avilleret/laser_drawer/schematic/README

ce dossier contient le projet Kicad laser_drawer.pro

Il s'agit de la version 2 du projet (version RGB et symétrisée)

Il a été crée avec la version 2013-03-31 BZR 4008-stable de Kicad (non compatible avec la version des dépôts du moment).

Exporter depuis Kicad vers Latex :
je n'utilise que le format PDF dans Latex.

Pour exporter en PDF depuis Eeschema (éditeur de schéma) :
Fichier -> Tracer
Puis sélectionner : 
Dimension page : taille schématique
Format : PDF
Épaisseur de ligne par défaut : 0.152
Mode : couleur
Tracer cartouche et encadrement (optionel)

Puis cliquer : tracer toutes les pages

Pour exporter depuis PcbNew (éditeur de circuit imprimé) vers Latex (on passe par le format intermédiaire SVG) :
Export du schéma avec l'empreinte des composants, les valeurs, les reférences, les jumpers...
Fichier -> Export SVG
Répertoire de sortie : svg/
Couche cuivre : aucune sinon c'est illisible à cause du plan de masse
Couches techniques : 
	Dessus.Silks -> pour avoir les formes des composants
	Eco2.User -> pour avoir la connexion des jumpers
Dimension plume par défaut : 0,00393701 inch
Mode d'impression : couleur
Format de la page SVG : Surface du circuit seulement
Cocher Imprimer les contours du CI
Option de fichier : Tout en un fichier

Puis convertir les fichiers avec Inkscape : 
laser_drawer--brd.svg :
	Convertir en PDF : Fichier -> Enregistrer sous -> ../pdf/laser_drawer--brd.pdf
Options d'export : 
	Version PDF : 1.4
	Convertir textes en chemins : NON
	PDF+Latex : NON
	Rastériser : NON
	Résolution pour la rastérisation : 90
	Exporter dessin : NON
	Exporter page : NON
	Limiter l'exportation à l'id : <VIDE>

Pour exporter le typon : 
Fichier -> Tracer
	Format : SVG
	Répertoire : svg/
	Couches : Dessous.Cu
	Imprimer cartouche : NON
	Tracer pads sur sérigraphie : NON
	Tracer valeur module : OUI
	Tracer référence module : OUI
	Tracer autre texte : OUI
	Tracer textes invisibles : NON
	Ne pas couvrir les via : NON
	Exclure les tracés contour PCB : NON
	Tracé mirroir : NON
	Tracé négatif : NON
	Marques de perçage : petit
	Épaisseur ligne par défaut : 0,006"

Puis ouvrir svg/laser_drawer-Dessous_Cu.svg avec Inkscape
Réduire la taille de la page au contenu : 
	Fichier -> Propriété du document
	Dans l'onglet Page -> Taille de la page
	Redimensionner la page au contenu -> Ajuster la page au dessin ou à la sélection
	Fermer la fenêtre de dialogue
Retourner l'image : 
	Sélectionner tout : CTRL + A
	Retourner horizontalement : H
Sauvegarder en PDF : 
	Fichier -> Sauvegarder sous : pdf/laser_drawer-Dessous_Cu.pdf
Option d'export PDF cf plus haut.
