avilleret/laser_drawer/doc/laser_drawer-en-web.pdf

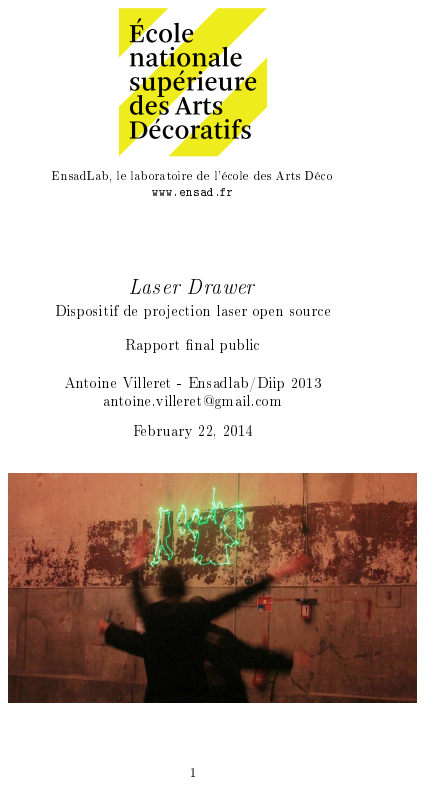
[picture p1: page 1]
❊♥s❛❞▲❛❜✱ ❧❡ ❧❛❜♦r❛t♦✐r❡ ❞❡ ❧✬é❝♦❧❡ ❞❡s ❆rts ❉é❝♦ ✇✇✇✳❡♥s❛❞✳❢r

## ❈♦♥t❡♥ts

✶ ❙t❛t❡ ♦❢ t❤❡ ❛rt ❛♥❞ t❡❝❤♥✐❝s | ✷
✶✳✶ P✐❡❝❡s ♦❢ ❛rt✐st✐❝ ✇♦r❦ ✳ ✳ ✳ ✳ ✳ ✳ ✳ ✳ ✳ ✳ ✳ ✳ ✳ ✳ ✳ ✳ ✳ ✳ ✳ ✳ | ✸
✶✳✶✳✶ | ❏❡❛♥✲▼✐❝❤❡❧ ❏❛rr❡ ✕ ▲❛s❡r ❤❛r♣ ✕ ✶✾✽✵✬s ✳ ✳ ✳ ✳ ✳ ✳ | ✸
✶✳✶✳✷ | ❆❧✈❛r♦ ❈❛ss✐♥❡❧❧✐ ✕ ❙❝♦r❡ ▲✐❣❤t ✕ ✷✵✵✽ ✳ ✳ ✳ ✳ ✳ ✳ ✳ | ✸
✶✳✶✳✸ | ❘♦❜✐♥ ❋♦① ✕ ▲❛s❡r ❙❤♦✇ ✳ ✳ ✳ ✳ ✳ ✳ ✳ ✳ ✳ ✳ ✳ ✳ ✳ ✳ ✳ | ✸
✶✳✶✳✹ | ❯❱❆ ✕ ❙♣❡❡❞ ♦❢ ❧✐❣❤t ✕ ✷✵✶✵ ✳ ✳ ✳ ✳ ✳ ✳ ✳ ✳ ✳ ✳ ✳ ✳ ✳ | ✹
✶✳✶✳✺ | ❘♦❜❡rt ❍❡♥❦❡ ✕ ❋r❛❣✐❧❡s ❚❡rr✐t♦✐r❡s ✕ ✷✵✶✷ ✳ ✳ ✳ ✳ | ✹
✶✳✶✳✻ | ❙❛♠✉❡❧ ❇✐❛♥❝❤✐♥✐ ✕ ❙✐❣♥ ✕ ✷✵✶✷ ✳ ✳ ✳ ✳ ✳ ✳ ✳ ✳ ✳ ✳ ✳ | ✺
✶✳✶✳✼ | ❍②✉♥❞❛✐ ❛♥❞ ❲❤✐t❡❱♦✐❞ ✕ ❋❧✉✐❞✐❝ ✲ ❙❝✉❧♣t✉r❡ ✐♥
| ♠♦t✐♦♥ ✕ ✷✵✶✸ ✳ ✳ ✳ ✳ ✳ ✳ ✳ ✳ ✳ ✳ ✳ ✳ ✳ ✳ ✳ ✳ ✳ ✳ ✳ ✳ | ✺
✶✳✶✳✽ | ❉❛✐t♦ ▼❛♥❛❜❡ ✕ ❯❱ ❧❛s❡r ❢❛❞❡ ♦✉t ✕ ✷✵✶✵ ✳ ✳ ✳ ✳ ✳ | ✺
✶✳✶✳✾ | ❆♥t♦✐♥❡ ❱✐❧❧❡r❡t ✕ ❙✐❧❤♦✉❡tt❡ ✕ ✷✵✶✸ ✳ ✳ ✳ ✳ ✳ ✳ ✳ ✳ | ✺
✶✳✶✳✶✵ ▼❛rs❤♠❛❧❧♦✇ ▲❛s❡r ❋❡❛st ✕ ▲❛s❡r ❋♦r❡st ✕ ✷✵✶✸ ✳ ✳ | ✺
✶✳✶✳✶✶ ❆ ❜✐t ♦❢ ❤✐st♦r② ✳ ✳ ✳ ✳ ✳ ✳ ✳ ✳ ✳ ✳ ✳ ✳ ✳ ✳ ✳ ✳ ✳ ✳ ✳ ✳ ✶✵ ✶✳✶✳✶✷ ▲❛s❡r ♣r♦❥❡❝t♦rs ✳ ✳ ✳ ✳ ✳ ✳ ✳ ✳ ✳ ✳ ✳ ✳ ✳ ✳ ✳ ✳ ✳ ✳ ✳ ✶✵ ✶✳✶✳✶✸ ■▲❉❆ ✐♥t❡r❢❛❝❡s ✳ ✳ ✳ ✳ ✳ ✳ ✳ ✳ ✳ ✳ ✳ ✳ ✳ ✳ ✳ ✳ ✳ ✳ ✳ ✳ ✶✵
✷ ❚❤❡ ▲❛s❡r ❉r❛✇❡r ♣r♦❥❡❝t | ✶✷
✷✳✶ ❙♣❡❝✐✜❝❛t✐♦♥s ✳ ✳ ✳ ✳ ✳ ✳ ✳ ✳ ✳ ✳ ✳ ✳ ✳ ✳ ✳ ✳ ✳ ✳ ✳ ✳ ✳ ✳ ✳ ✳ ✳ ✶✷ ✷✳✷ ❙♦❢t✇❛r❡ ❛♥❞ ❤❛r❞✇❛r❡ ❞❡s✐❣♥ ✳ ✳ ✳ ✳ ✳ ✳ ✳ ✳ ✳ ✳ ✳ ✳ ✳ ✳ ✳ ✳ ✶✷
✷✳✷✳✶ | ❍❛r❞✇❛r❡ ✳ ✳ ✳ ✳ ✳ ✳ ✳ ✳ ✳ ✳ ✳ ✳ ✳ ✳ ✳ ✳ ✳ ✳ ✳ ✳ ✳ ✳ ✳ ✶✷
✷✳✷✳✷ | ❙♦❢t✇❛r❡ ✳ ✳ ✳ ✳ ✳ ✳ ✳ ✳ ✳ ✳ ✳ ✳ ✳ ✳ ✳ ✳ ✳ ✳ ✳ ✳ ✳ ✳ ✳ ✳ ✶✸
✷✳✸ ▲❛s❡r ❉r❛✇❡r ✈s✳ ●❛❧❛①② ▲❛s❡r ❙❤♦✇ ✳ ✳ ✳ ✳ ✳ ✳ ✳ ✳ ✳ ✳ ✳ ✳ ✶✺
❆ ❊❧❡❝tr♦♥✐❝ ❙❝❤❡♠❛t✐❝s | ✶✾
❇ ▲❡❣❛❧ ❛♥❞ s❡❝✉r✐t② ✐ss✉❡s ✇✐t❤ t❤❡ ❧❛s❡rs | ✷✹
❈ ■♠❛❣❡ ❝r❡❞✐t | ✷✻

▲❛s❡r ❉r❛✇❡r ✐s ❛♥ ♦♣❡♥ s♦✉r❝❡ ❧❛s❡r ♣r♦❥❡❝t✐♦♥ ❛♣♣❛r❛t✉s✳ ❆❢t❡r ❛ st❛t❡ ♦❢ t❤❡ ❛rt ❛♥❞ t❡❝❤♥✐❝s ❛r♦✉♥❞ ❛♥✐♠❛t✐♦♥ ❧❛s❡r✱ t❤✐s ❛rt✐❝❧❡ ✐♥tr♦✲ ❞✉❝❡ t❤❡ ❞❡✈✐❝❡ ❛♥❞ ❤♦✇ ✐t ✐s ♠❛❞❡✳ ❚✇♦ ❛♣♣❡♥❞✐❝❡s ♣r❡s❡♥ts ❡❧❡❝tr♦♥✐❝ s❝❤❡♠❛t✐❝s ❛♥❞ s❡❝✉r✐t② ✐ss✉❡s✳

## ✶ ❙t❛t❡ ♦❢ t❤❡ ❛rt ❛♥❞ t❡❝❤♥✐❝s

■♥st❡❛❞ ♦❢ ♠❛❦✐♥❣ ❛♥ ❡①❤❛✉t✐✈❡ st❛t❡ ♦❢ t❤❡ ❛rt ❛♥❞ t❡❝❤♥✐❝s✱ ■ ❝❤♦♦s❡ ❢❡✇ ♣✐❡❝❡s ♦❢ ❛rt✐st✐❝ ✇♦r❦s ✐♥✈♦❧✈✐♥❣ ❧❛s❡r ❛♥❞ s♦♠❡ s♦❧✉t✐♦♥s t♦ ❞r✐✈❡ t❤❡♠ ✇✐t❤ ❛ ❝♦♠♣✉t❡r✳

✷

✶✳✶ | P✐❡❝❡s ♦❢ ❛rt✐st✐❝ ✇♦r❦
✶✳✶✳✶ | ❇❡r♥❛r❞ ❙③❛❥♥❡r ✕ ❙②♥r✐♥❣✉❡ ✭❤❛r♣❡ ❧❛s❡r✮ ✕ ✶✾✽✵

■♥ t❤❡ ✶✾✽✵✬s✱ ❇❡r♥❛r❞ ❙③❛❥♥❡r✶ ❞❡s✐❣♥❡❞ ❛ ♠✉s✐❝❛❧ ✐♥str✉♠❡♥t ❜❛s❡❞ ♦♥ ❛ ❧❛s❡r ❜❡❛♠ ✿ ❙②r✐♥❣✉❡✱ t❤❡ ❧❛s❡r ❤❛r♣✳ ■t ✐s ♦❢t❡♥ ❛ttr✐❜✉t❡❞ t♦ ❏❡❛♥✲ ▼✐❝❤❡❧ ❏❛rr❡ ✇❤✐❝❤ ✉s❡s ❛ ❧❛s❡r ❤❛r♣ s✐♥❝❡ ♠❛♥② ②❡❛rs ✇✐t❤♦✉t ❝r❡❞✐t t♦ ❇❡r♥❛r❞ ❙③❛❥♥❡r✳ ■t✬s ♣r❡tt② s✐♠♣❧❡ ✿ t❤❡ ❝✉t ♦❢ ❛ ❧❛s❡r ❜❡❛♠ tr✐❣❣❡rs ❛ s②♥t❤❡s✐③❡r✳
❆❝❝♦r❞✐♥❣ t♦ ❏❛rr❡✱ ❧❛s❡r ❡♥❛❜❧❡s ✧t♦ s❤❛r❡ ✇✐t❤ t❤❡ ❛✉❞✐❡♥❝❡✱ ✇❤✐❝❤ ✐s ❢❛r ❛✇❛② ✐♥ t❤❡ ✈❡♥✉❡✱ ❬✳ ✳ ✳ ❪ t❤❡ ♠✉s✐❝ ✐♥ ❛ ✈✐s✐❜❧❡ ❛♥❞ s❡♥s✐❜❧❡ ✇❛②✧✳ ◆❡✈❡rt❤❡❧❡ss✱ t❤✐s ❞✐s♣♦s❛❧ ❤❛s ❛ ❧✐♠✐t❡❞ ❡①♣r❡ss✐✈✐t②✳ ❚❤❡r❡ ✐s ♥❡✐t❤❡r ✈❡❧♦❝✐t② ♥♦r ❛❢t❡rt♦✉❝❤✳

✶✳✶✳✷ ❆❧✈❛r♦ ❈❛ss✐♥❡❧❧✐ ✕ ❙❝♦r❡ ▲✐❣❤t ✕ ✷✵✵✽

❙❝♦r❡ ▲✐❣❤t ✐s ❛♥ ❆❧✈❛r♦ ❈❛ss✐♥❡❧❧✐✬s ♣r♦❥❡❝t ✇❤❡r❡ ❛ s♠❛❧❧ ❧❛s❡r ❜❡❛♠ ❢♦❧❧♦✇s s❤❛♣❡s ❞r❛✇♥ ✐♥ r❡❛❧ t✐♠❡ ♦r ♠♦✈❡❞ ♦♥ ❛ ❞❡s❦ ✭❝❢✳ ✶✮✳ ❚❤✐s ✐♥st❛❧❧❛t✐♦♥ ✉s❡s ❛ s♠❛❧❧ ❧❛s❡r ❛ss♦❝✐❛t❡❞ ✇✐t❤ ❛ ✈✐❞❡♦ ❝❛♠❡r❛ t♦ ❞❡t❡❝t ❝♦♥t♦✉rs✳ ❆❧✈❛r❛ ❈❛ss✐♥❡❧❧✐ ✐s ❝✉rr❡♥t❧② ✇♦r❦✐♥❣ ♦♥ ▲❛s❡r ●❛♠❡ ♣r♦❥❡❝t ✿ t❤❡ ❧❛s❡r ❜❡❛♠ ✐s ♣r♦❥❡❝t❡❞ ♦♥ ❛ ❚✲s❤✐rt ❛♥❞ ❜♦✉♥❝❡ ♦♥ s♠❛❧❧ ♣r✐♥t❡❞ ❞♦ts ❧✐❦❡ ❛ ✢✐♣♣❡r ❜❛❧❧✳ ❚❤❡ ❣❛♠❡r s❤♦✉❧❞ ♠♦✈❡ ❤✐♠s❡❧❢ t♦ s❛✈❡ t❤❡ ❜❛❧❧ ❢r♦♠ ❢❛❧❧✐♥❣ ❞♦✇♥✳

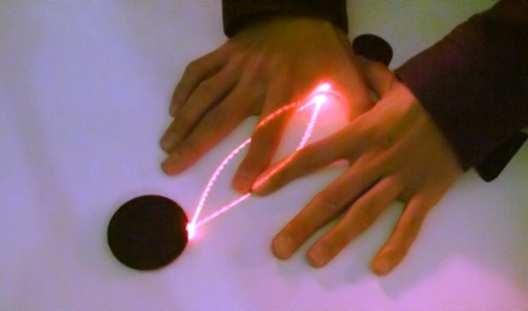
[picture p2: figure]

❋✐❣✉r❡ ✶✿ ❆❧✈❛r♦ ❈❛ss✐♥❡❧❧✐ ✕ ❙❝♦r❡ ▲✐❣❤t

✶❤tt♣✿✴✴s③❛❥♥❡r✳♥❡t✴s②r✐♥❣❡✲❧❛s❡r✲❤❛r♣✴ (http://szajner.net/syringe-laser-harp/)

✸

✶✳✶✳✸ ❘♦❜✐♥ ❋♦① ✕ ▲❛s❡r ❙❤♦✇

❘♦❜✐♥ ❋♦① ✉s❡s ❧❛s❡r ❧✐❦❡ ❛♥ ♦s❝✐❧❧♦s❝♦♣❡✳ ❍❡ ❢❡❡❞s t❤❡ ❧❛s❡r ✇✐t❤ t❤❡ s❛♠❡ s✐❣♥❛❧ ❤❡ s❡♥❞s t♦ ❧♦✉❞s♣❡❛❦❡rs✳ ❚❤✐s ✐s ❣❡♥❡r❛t❡❞ ❜② ❛ ▼❛①✴▼❙P ♣❛t❝❤ ✐♥ r❡❛❧✲t✐♠❡✳ ❚❤❛♥❦s t♦ t❤❡ s♠♦❦❡✱ t❤❡ ❜❡❛♠ ✐s ✈✐s✐❜❧❡ ✐♥ t❤❡ s♣❛❝❡ ❛♥❞ ✈♦❧✉♠❡s ❛♣♣❡❛rs ✭❝❢✳ ✷✮✳ ❚❤❡ ❜❡❛♠ s❝❛♥s t❤❡ ❛✉❞✐❡♥❝❡✱ t❤✐s ✐s ❞❛♥❣❡r♦✉s ❡✈❡♥ ✐❢ t❤❡ s♠♦❦❡ ❛tt❡♥✉❛t❡s t❤❡ ❜❡❛♠✳ ❚❤❡ s❤♦✇ ✐s ✐♠♣r❡ss✐✈❡ ❜✉t t❤❡ s②st❡♠❛t✐❝ ❝♦rr❡❧❛t✐♦♥ ❜❡t✇❡❡♥ s♦✉♥❞ ❛♥❞ ✈✐s✉❛❧ ♠❛❦❡s ✐t ❜♦r✐♥❣ q✉✐❝❦❧②✳ ❘♦❜✐♥ ❋♦① ✉s❡s ❛ ▼❖❚❯ ❚r❛✈❡❧❧❡r s♦✉♥❞ ❝❛r❞ ❛♥❞ ❛ ❤✐s ♦✇♥ ❡❧❡❝tr♦♥✐❝s t♦ ❞r✐✈❡ ❤✐s ✸✺✵ mW ❧❛s❡r✳

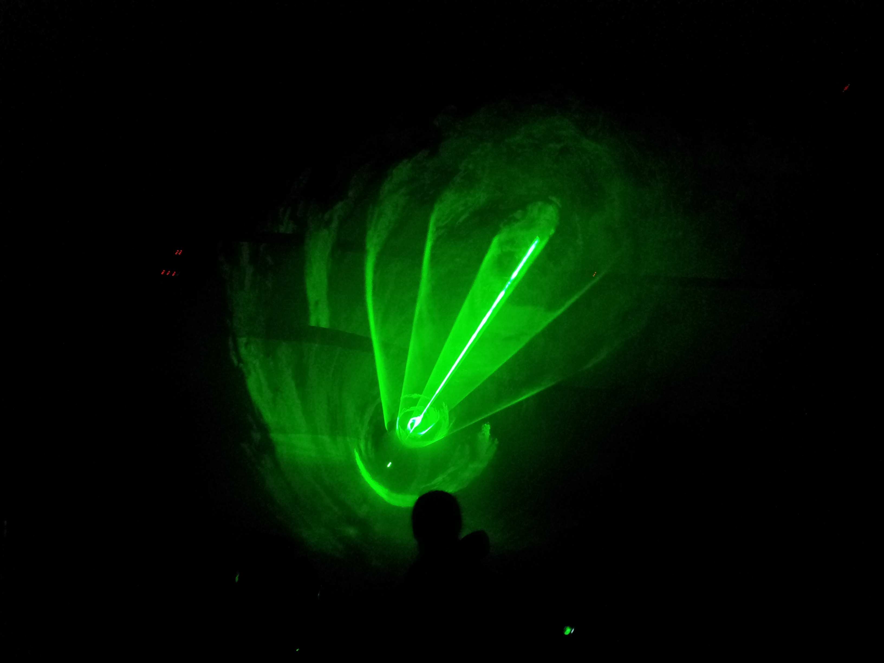
[picture p3: figure]

❋✐❣✉r❡ ✷✿ ❘♦❜✐♥ ❋♦① ✕ ▲❛s❡r ❙❤♦✇

✶✳✶✳✹ ❯❱❆ ✕ ❙♣❡❡❞ ♦❢ ❧✐❣❤t ✕ ✷✵✶✵

❙♣❡❡❞ ♦❢ ❧✐❣❤t ✐s ❛ ❧❛❜②r✐♥t❤✐❝ s❡t ♦❢ ❧❛s❡r ✐♥st❛❧❧❛t✐♦♥s✳ ❙❡✈❡r❛❧ ✐♥st❛❧✲ ❧❛t✐♦♥s s❤♦✇ ✈♦❧✉♠✐❝ ✜❣✉r❡s ❞r❛✇♥ ✇✐t❤ ❢❡✇ ❧❛s❡rs ❞❡✢❡❝t❡❞ t❤❛♥❦s t♦ ✜①❡❞ ♠✐rr♦rs✳ ❆♥♦t❤❡r ✐♥st❛❧❧❛t✐♦♥ ❞r❛✇s ❛♥ ✐♥t❡r❛❝t✐✈❡ t❡①t❡ ♦♥ ❛ ✇❛❧❧✳ ■♥ ❛ ✈✐❞❡♦✱ ✇❡ s❤♦✇ t❤❡ t❡❛♠ ✇♦r❦✐♥❣ ✇✐t❤ ▼❛①✴▼❙P✱ t❤❡② ♣r♦❜❛❜❧② ✉s❡ t❤✐s s♦❢t✇❛r❡ t♦ ❞r✐✈❡ ❧❛s❡rs✱ ❜✉t ■ ❤❛✈❡ ♥♦ ♣r♦♦❢✳

✶✳✶✳✺ ❘♦❜❡rt ❍❡♥❦❡ ✕ ❋r❛❣✐❧❡s ❚❡rr✐t♦✐r❡s ✕ ✷✵✶✷

❋r❛❣✐❧❡s ❚❡rr✐t♦✐r❡s ✐s ❛♥ ✐♥t❡r❛❝t✐✈❡ ❛♥❞ ❣❡♥❡r❛t✐✈❡ ✐♥st❛❧❧❛t✐♦♥ ❜② ❘♦❜❡rt ❍❡♥❦❡✳ ■t s❤♦✇s ❛♥ ❛♥✐♠❛t❡❞ ♥❡t✇♦r❦✳ ❚❤❡ ❛✉❞✐❡♥❝❡ ✐♥✢✉❡♥❝❡s t❤❡ ❛✉✲ ❞✐♦ ❛♥❞ ✈✐s✉❛❧ ♣❛tt❡r♥ ❣❡♥❡r❛t✐♦♥✳ ❚❤✐s ✐♥st❛❧❧❛t✐♦♥ ❤❛✈❡ ❜❡❡♥ s❤♦✇♥

| ✹

✐♥ ❊s♣❛❝❡ ▲❯ ✐♥ ◆❛♥t❡s ✭❋❘✮✳ ❘♦❜❡rt ❍❡♥❦❡ ✉s❡s ❛ ▼❖❚❯ ❚r❛✈❡❧❧❡r s♦✉♥❞ ❝❛r❞ t♦ ❞r✐✈❡ ❢♦✉r ②❡❧❧♦✇✲❜❧✉❡ ✺W ❧❛s❡rs✳ ❉✉❡ t♦ t❤❡ ❤❛③❛r❞ ♦❢ t❤♦s❡ ♣♦✇❡r❢✉❧ ❧❛s❡rs ❛♥❞ t❤❡ ✐♥❞♦♦r ✉s❡✱ ❤❡ ❞❡♣❧♦②s s♦♠❡ s♣❡❝✐❛❧ s❡❝✉r✐t② ♠❡❛s✉r❡s ✭♣❧❡❛s❡ r❡❢❡r t♦ ❆♣♣❡♥❞✐① ❇ t♦ ❧❡❛r♥ ♠♦r❡✮✳

✶✳✶✳✻ ❙❛♠✉❡❧ ❇✐❛♥❝❤✐♥✐ ✕ ❙✐❣♥ ✕ ✷✵✶✷

❙✐❣♥ ✐s ❛ ❣❡♥❡r❛t✐✈❡ ✐♥st❛❧❧❛t✐♦♥✳ ❲♦r❞s t❛❦❡♥ ❢r♦♠ t❤❡ s❝✐❡♥t✐✜❝ ✈♦❝❛❜✲ ✉❧❛r② ❛♥❞ ❢r♦♠ t❤❡ ✉♥✐✈❡rs✐t② ✇❡❜s✐t❡ ❛r❡ ✇r✐tt❡♥ ✇✐t❤ ❛ ❣r❡❡♥ ❧❛s❡r ♦♥ t❤❡ ❢r♦♥t ♦❢ ❛ ❜✉✐❧❞✐♥❣✳ ❚❤❡ ✇♦r❞s ❛r❡ ❞r❛✇♥ ✇✐t❤ ❛ ❤❛♥❞✇r✐tt❡♥ ❝❛❧✲ ❧✐❣r❛♣❤② ✇✐t❤ ❤❡s✐t❛t✐♦♥s ❛♥❞ ❝r♦ss✐♥❣ ♦✉t ❛s ✐❢ s♦♠❡♦♥❡ ✇❡r❡ ❝✉rr❡♥t❧② ✇r✐t✐♥❣ ♦♥ ❛ ♣❡♥ t❛❜❧❡t✳ ❚❤✐s ✐♥st❛❧❧❛t✐♦♥ ✉s❡s ❛ ✶✵W ❣r❡❡♥ ❧❛s❡r ❞r✐✈❡♥ ❜② ❛ ●❛❧❛①② ❙❤♦✇ ✐♥t❡r❢❛❝❡✳ ❆ s♦❢t✇❛r❡ ❤❛✈❡ ❜❡❡♥ ❞❡✈❡❧♦♣❡❞ t♦ ✉s❡ t❤✐s ✐♥t❡r❢❛❝❡ ✇✐t❤ P✉r❡❞❛t❛ ✉♥❞❡r ▲✐♥✉① ✭❝❢✳ ✶✳✶✳✶✸ ❛♥❞ ✜❣✉r❡ ✺✮✳

✶✳✶✳✼ ❍②✉♥❞❛✐ ❛♥❞ ❲❤✐t❡❱♦✐❞ ✕ ❋❧✉✐❞✐❝ ✲ ❙❝✉❧♣t✉r❡ ✐♥ ♠♦t✐♦♥ ✕ ✷✵✶✸

❋♦r t❤❡ ▼✐❧❛♥✬s ❞❡s✐❣♥❡r ✇❡❡❦ ✷✵✶✸✱ ❍✉②♥❞❛✐ ✐♥tr♦❞✉❝❡s ❋✉✐❧❞✐❝ ✲ ❙❝✉❧♣✲ t✉r❡ ✐♥ ♠♦t✐♦♥✱ ❛♥ ✐♥t❡r❛❝t✐✈❡ ✐♥st❛❧❧❛t✐♦♥ ♠❛❞❡ ❜② ❲❤✐t❡✈♦✐❞ t❡❛♠✳ ■t ✉s❡s ❛ ✸✲❞✐♠❡♥s✐♦♥❛❧ ♠♦t✐♦♥ ❝❛♣t✉r❡ ❞✐s♣♦s❛❧ t♦ tr❛❝❦ ♣❡♦♣❧❡ ❣❡st✉r❡ ❛♥❞ t♦ ❛♥✐♠❛t❡ ❧❛s❡r ♣❛tt❡r♥ ♣r♦❥❡❝t❡❞ ♦♥ ❛ ❝❧♦✉❞ ♦❢ t❤♦✉s❛♥❞ ♦❢ ♣✐♥❣✲♣♦♥❣ ❧✐❦❡ ❜❛❧❧s ✭❝❢✳ ✜❣✉r❡ ✻✮✳

✶✳✶✳✽ ❉❛✐t♦ ▼❛♥❛❜❡ ✕ ❯❱ ❧❛s❡r ❢❛❞❡ ♦✉t ✕ ✷✵✶✵

❉❛✐t♦ ▼❛♥❛❜❡ ✉s❡s ❧❛s❡r ✐♥ s❡✈❡r❛❧ ♦❢ ❤✐s ✇♦r❦s✳ ❯❱ ❧❛s❡r ❢❛❞❡ ♦✉t ✐♥✈♦❧✈❡s ❛ ❯❱ ❧❛s❡r t♦ ❞r❛✇ ♦♥ ❛ ♣❤♦s♣❤♦r❡s❝❡♥t ❜♦❛r❞✳ ❚❤❡ ❧❛s❡r ❝❤❛r❣❡s s✉❝❝❡ss✐✈❡❧② s♠❛❧❧ ♣♦✐♥ts✱ t❤❡ ❞✐s❝❤❛r❣❡ ♠❛❦❡s ❞✐✛❡r❡♥t ❧✉♠✐♥♦s✐t② ❧❡✈❡❧s ❛♥❞ ❛ ♣✐❝t✉r❡ ❛♣♣❡❛rs ✭❝❢✳ ✜❣✉r❡ ✼✮✳
❲✐t❤ P✉❧s❡✱ ❉❛✐t♦ ▼❛♥❛❜❡ ✉s❡s ❧❛s❡r ♠♦✉♥t❡❞ ♦♥ r♦❜♦t ❛♥❞ ♠✐rr♦rs ♣❧❛❝❡❞ ✐♥ ❛ ❧❛r❣❡ s♣❛❝❡ t♦ ❞❡✢❡❝t ❜❡❛♠s✳

✶✳✶✳✾ ❆♥t♦✐♥❡ ❱✐❧❧❡r❡t ✕ ❙✐❧❤♦✉❡tt❡ ✕ ✷✵✶✸

❙✐❧❤♦✉❡tt❡ ✐s ❛♥ ✐♥t❡r❛❝t✐✈❡ ✐♥st❛❧❧❛t✐♦♥ ✐♥ ✇❤✐❝❤ ❛ ❧❛s❡r ♣r♦❥❡❝t♦r ❞r❛✇s ❛♥✐♠❛t❡❞ s✐❧❤♦✉❡tt❡s✳ ■t ✇❛s ✜rst s❤♦✇❡❞ ❞✉r✐♥❣ t❤❡ ♦♣❡♥ ❞❛②s ♦❢ t❤❡ ❊◆❙❆❉ ✐♥ ❏❛♥✉❛r② ✷✺t❤ ❛♥❞ ✷✻t❤✱ ✷✵✶✸✳
❚❤❡ ✈✐s✐t♦rs ❡♥t❡r❡❞ t❤❡ ❜✉✐❧❞✐♥❣ t❤r♦✉❣❤ ❛ s✐♥♦✉s ❛♥❞ ♥❛rr♦✇ ❝♦rr✐✲ ❞♦r✳ ❆t ✐ts ❡♥❞✱ t❤❡② s❛✇ ❛ ❣r❡❡♥ s❤❛♣❡ ❛♥❞ r❡❛❧✐③❡❞ ❜② ❣❡tt✐♥❣ ❝❧♦s❡r t❤❛t ✐t ✇❛s t❤❡✐r ❝♦♥t♦✉r ♣r♦❥❡❝t❡❞ ♦♥ ❛ ♣❛♣❡r s❝r❡❡♥ ❜② ❛ ❧❛s❡r ✭❝❢✳ ✽✮✳ ❚❤✐s ❞✐s♣♦s❛❧ ✉s❡s ❛ ❞❡♣t❤ s❡♥s♦r ✭❑✐♥❡❝t✮ t❤❛t ❡❛s✐❧② ❡①tr❛❝ts t❤❡ ✈✐s✐t♦r✬s s✐❧❤♦✉❡tt❡s✳ ❚❤♦s❡ s✐❧❤♦✉❡tt❡s ❛r❡ t❤❡♥ ✈❡❝t♦r✐s❡❞ ❛♥❞ s❡♥t t♦ t❤❡ ❧❛s❡r t❤❛♥❦s t♦ t❤❡ ❝✉st♦♠ ✐♥t❡r❢❛❝❡ ❞❡❝r✐❜❡❞ ✐♥ t❤❡ r❡♣♦rt✳ ❚❤❡ ✇❤♦❧❡ ✈✐❞❡♦ ♣r♦❝❡ss✐♥❣ ✐s ❛❝❤✐❡✈❡❞ ✇✐t❤ ♣✉r❡❞❛t❛ t❤❛♥❦s t♦ ❝✉st♦♠ ❡①t❡r♥❛❧s✳

✺

✶✳✶✳✶✵ ▼❛rs❤♠❛❧❧♦✇ ▲❛s❡r ❋❡❛st ✕ ▲❛s❡r ❋♦r❡st ✕ ✷✵✶✸

▲❛s❡r ❋♦r❡st ✐♥✈♦❧✈❡s ✶✺✵ ❧❛s❡rs ♣❧❛❝❡s ♦♥ t♦♣ ♦❢ ✈❡rt✐❝❛❧ ✸ m t❛❧❧ ♠❡t❛❧ t✉❜❡s t❤✉s ❝r❡❛t✐♥❣ ❛ ✧❢♦r❡st✧✳ ❚❤❡ ♥❛t✉r❛❧ s♣r✐♥❣♥❡ss ♦❢ t✉❜❡ ♠❛❦❡s ✐t ♦s❝✐❧❧❛t✐♥❣ ✇❤❡♥ s♦♠❡❜♦❞② t♦✉❝❤❡s ✐t ❛♥❞ t❤❡♥ t❤❡ ❧❛s❡r ❞r❛✇s ✜❣✉r❡s ♦♥ t❤❡ ❝❡✐❧✐♥❣ ✭❝❢✳ ✾✮✳ ❆ t♦♥❡ ✐s ❛ss♦❝✐❛t❡❞ ✇✐t❤ ❡❛❝❤ tr❡❡✱ ✈✐s✐t♦rs ❝❛♥ ♣❧❛② s♦✉♥❞ ❛♥❞ ❧✐❣❤t ❥✉st ❜② t♦✉❝❤✐♥❣ t❤❡ tr❡❡✳

✻

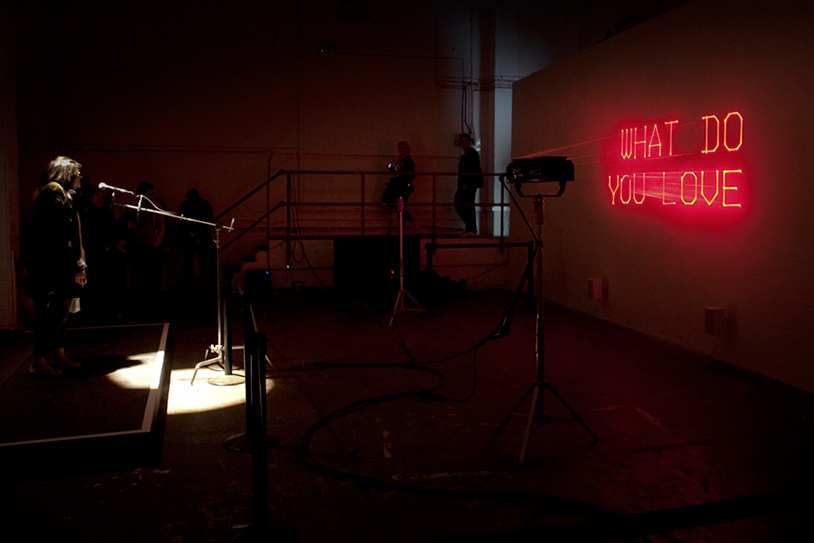
[picture p4: figure]
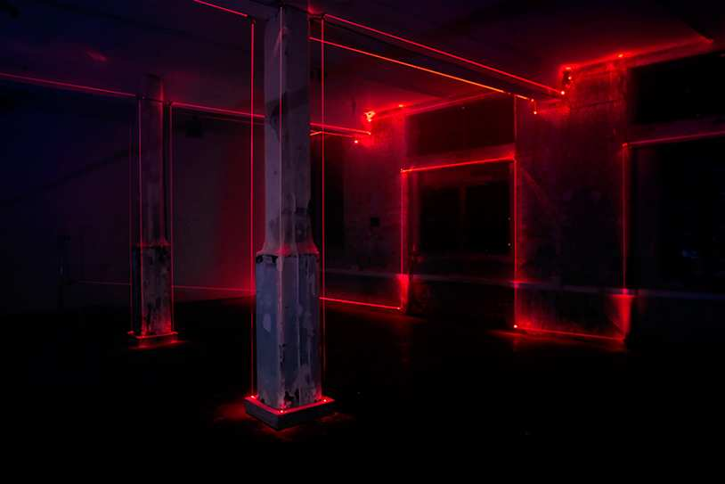
[picture p5: figure]

❋✐❣✉r❡ ✸✿ ❯❱❆ ✕ ❙♣❡❡❞ ♦❢ ❧✐❣❤t

✼

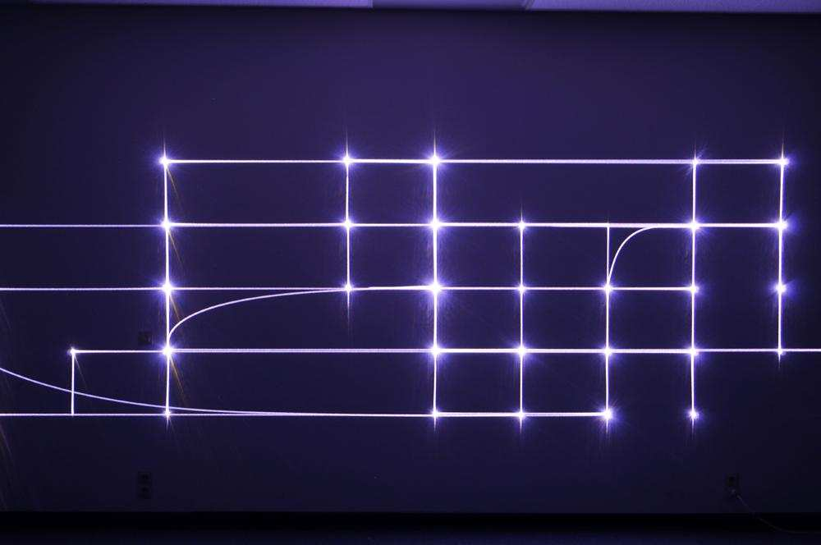
[picture p6: figure]

❋✐❣✉r❡ ✹✿ ❘♦❜❡rt ❍❡♥❦❡ ✕ ❋r❛❣✐❧❡s ❚❡rr✐t♦✐r❡s

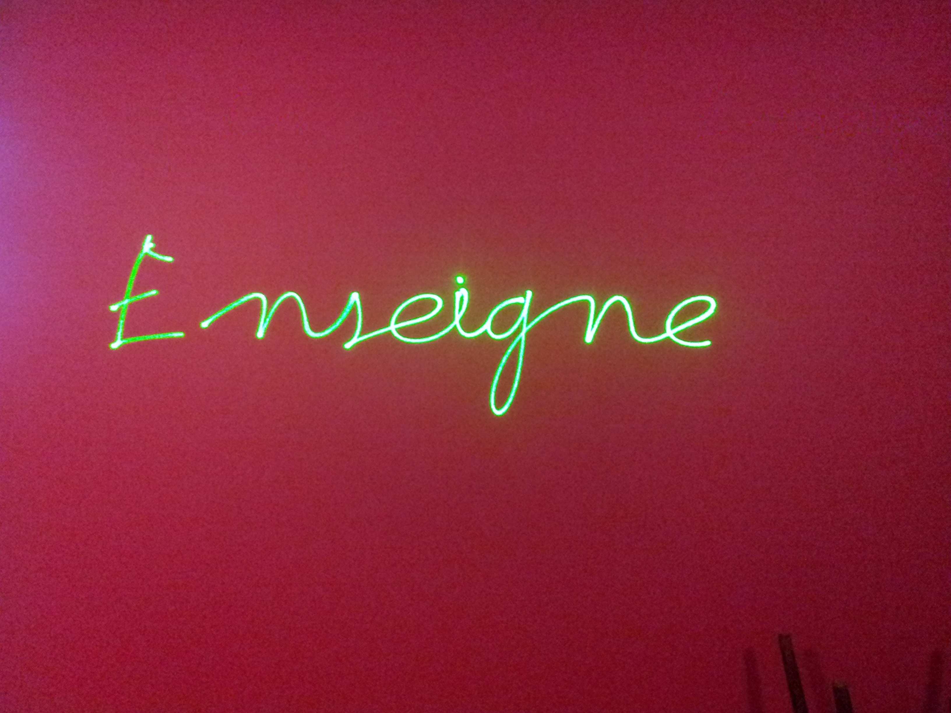
[picture p7: figure]

❋✐❣✉r❡ ✺✿ ❙❛♠✉❡❧ ❇✐❛♥❝❤✐♥✐ ✕ ❙✐❣♥

✽

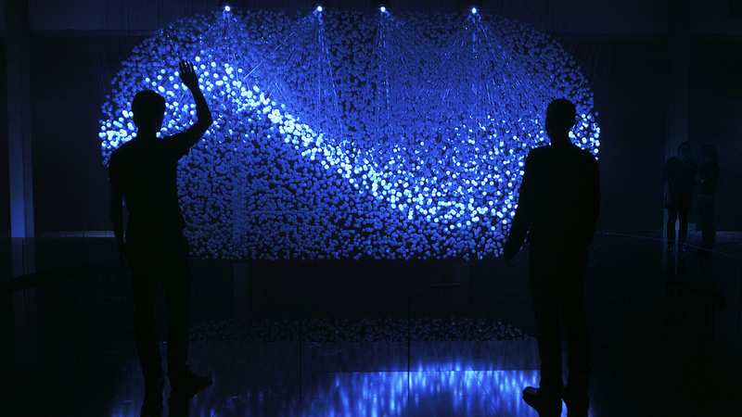
[picture p8: figure]

❋✐❣✉r❡ ✻✿ ❍②✉♥❞❛✐ ❛♥❞ ❲❤✐t❡❱♦✐❞ ✕ ❋❧✉✐❞✐❝ ✲ ❙❝✉❧♣t✉r❡ ✐♥ ♠♦t✐♦♥

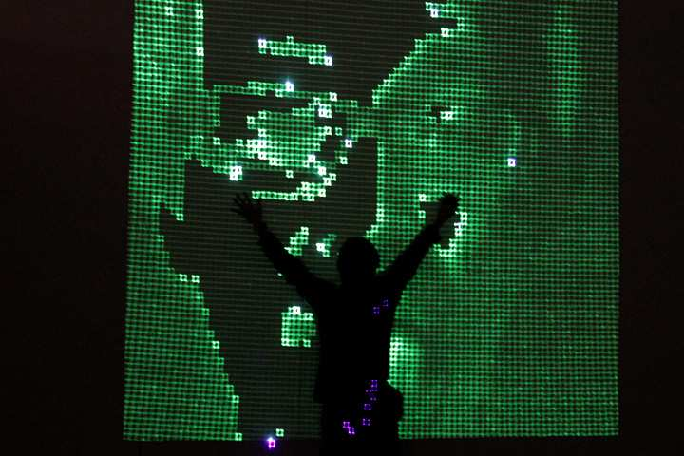
[picture p9: figure]

❋✐❣✉r❡ ✼✿ ❉❛✐t♦ ▼❛♥❛❜❡ ✕ ❯❱ ❧❛s❡r ❢❛❞❡ ♦✉t

✾

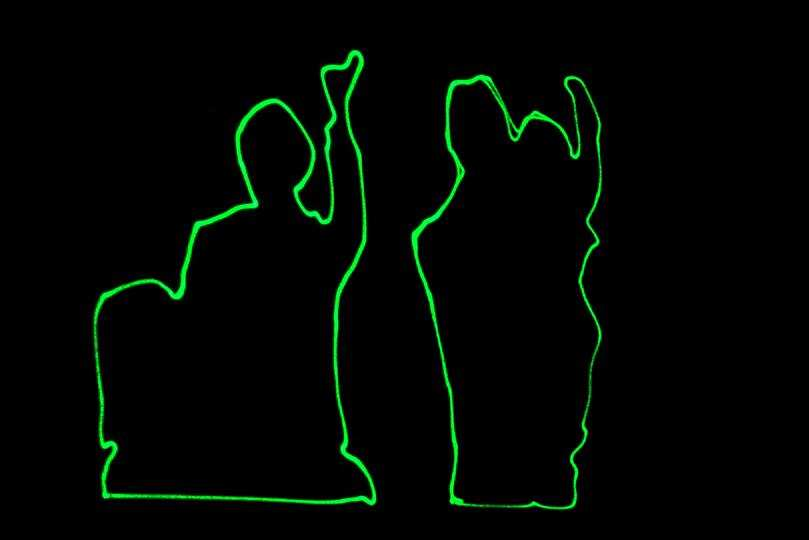
[picture p10: figure]

❋✐❣✉r❡ ✽✿ ❆♥t♦✐♥❡ ❱✐❧❧❡r❡t ✕ ❙✐❧❤♦✉❡tt❡

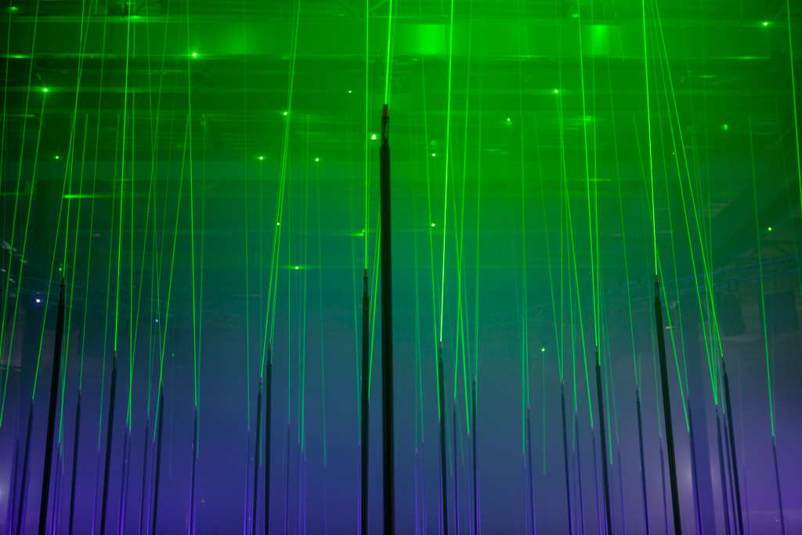
[picture p11: figure]

❋✐❣✉r❡ ✾✿ ▼❛rs❤♠❛❧❧♦✇ ▲❛s❡r ❋❡❛st ✕ ▲❛s❡r ❋♦r❡st

✶✵

✶✳✶✳✶✶ ❆ ❜✐t ♦❢ ❤✐st♦r②

❚❤❡ ❧❛s❡r ✇❛s ❝♦♥❝❡♣t✉❛❧✐③❡❞ ❜② ❆❧❜❡rt ❊✐♥st❡✐♥ ❛r♦✉♥❞ ✶✾✶✼✳ ❚❤❡ ✜rst ❧❛s❡r ❤❛s ❜❡❡♥ ❜✉✐❧❞ ❛r♦✉♥❞ ✶✾✺✽✳ ■ts ✐♥❞✉str✐❛❧ ✉s❡ st❛rts ✐♥ t❤❡ ❧❛t❡ ✼✵✬s✱ ❡s♣❡❝✐❛❧❧② ❢♦r ❝✉tt✐♥❣✳ ❙✐♥❝❡ ✐t ✐s ✇✐❞❡❧② ✉s❡❞ ✐♥ t❤♦✉s❛♥❞ ♦❢ ❛♣♣❧✐❝❛✲ t✐♦♥s ✿ ♦♣t✐❝❛❧ ❞r✐✈❡✱ ❜❛r ❝♦❞❡ r❡❛❞❡r✱ ♠❛t❡r✐❛❧ ❝✉tt✐♥❣✱ ✇❡❛♣♦♥ ✐♥❞✉str②✱ ❞✐st❛♥❝❡ s❡♥s♦r✳ ✳ ✳ ❏❡❛♥✲▼✐❝❤❡❧ ❏❛rr❡ ✇❛s t❤❡ ✜rst ■ ❦♥♦✇ t♦ ✉s❡ ✐t ✐♥ ❛♥ ❛rt✐st✐❝ ♣✉r♣♦s❡ ✇✐t❤ ❤✐s ❧❛s❡r ❤❛r♣✳

✶✳✶✳✶✷ ▲❛s❡r ♣r♦❥❡❝t♦rs

■♥s✐❞❡ ❧❛s❡r ♣r♦❥❡❝t♦rs✱ t❤❡ ❜❡❛♠ ✐s ❞❡✢❡❝t❡❞ ❜② ❤✐❣❤ s♣❡❡❞ ♠♦✈✐♥❣ ♠✐r✲ r♦rs✳ ❚❤❡ ♠✐rr♦rs ❝♦♥st❛♥t❧② s❝❛♥ t❤❡ ♣✐❝t✉r❡✱ t❤❛♥❦s t♦ t❤❡ r❡t✐♥❛❧ ♣❡rs✐st❡♥❝❡ ✇❡ s❛✇ ❛ ❧✐♥❡ ❛♥❞ ♥♦t ❛ ♠♦✈✐♥❣ ❞♦t✳ ❙♦♠❡ ♣r♦❥❡❝t♦rs ❤❛✈❡ ❛ ❉▼❳ ✐♥♣✉t ❜✉t t❤❡ ❉▼❳ ❞❛t❛ ❝♦✉❧❞ ♦♥❧② ❝❤♦♦s❡ ♣❛tt❡r♥ ❢r♦♠ ❛ ❤❛r❞✲ ❝♦❞❡❞ ❧✐❜r❛r②✳ ❚♦ ❞r❛✇ ❛r❜✐tr❛r② ♣✐❝t✉r❡ ✇✐t❤ ❛ ❧❛s❡r✱ ✇❡ s❤♦✉❧❞ ❞r✐✈❡ t❤❡ ♠✐rr♦rs ❞✐r❡❝t❧②✳ ❚❤✐s ✐s t❤❡ ❛✐♠ ♦❢ t❤❡ ■▲❉❆ ♣r♦t♦❝♦❧✳ ❲✐t❤ t❤✐s ❛♥❛❧♦❣ ♣r♦t♦❝♦❧✱ ✇❡ ❝❛♥ ❛❧s♦ ❝♦♥tr♦❧ t❤❡ ✐♥t❡♥s✐t② ♦❢ t❤❡ ❧❛s❡r ❞✐♦❞❡✳

✶✳✶✳✶✸ ■▲❉❆ ✐♥t❡r❢❛❝❡s

❊✈❡♥ ✐❢ t❤❡ ■▲❉❆ ♣r♦t♦❝♦❧ ✐s ✇✐❞❡❧② ✉s❡❞ ♦♥ ❧❛s❡r ♣r♦❥❡❝t♦rs✱ t❤❡r❡ ❛r❡ ♦♥❧② ❢❡✇ s♦❧✉t✐♦♥s t♦ ❞r✐✈❡ t❤❡♠ ✇✐t❤ ❛ ❝♦♠♣✉t❡r✳

P❛♥❣♦❧✐♥ ❚❤❡ ✇♦r❧❞ ❧❡❛❞❡r ✐s P❛♥❣♦❧✐♥ ✇❤✐❝❤ ❤❛s ❛ ❝♦♠♣❧❡t❡ t❡❝❤♥✐❝❛❧ ❝❤❛✐♥ ❢r♦♠ t❤❡ s♦❢t✇❛r❡ t♦ t❤❡ ❤❛r❞✇❛r❡✳ ❖♥ t❤❡ s♦❢t✇❛r❡ s✐❞❡✱ t❤❡r❡ ❛r❡ s❡✈❡r❛❧ s♦❧✉t✐♦♥s t♦ ♠❛❦❡ s♠❛❧❧ s❤♦✇s ♦r ❡✈❡♥ ❤✉❣❡ ♦♥❡s✳ ❚❤❡r❡ ✐s ❛❧s♦ ❛ ❙❉❑ t♦ ❞❡✈❡❧♦♣ ❝✉st♦♠ s♦❢t✇❛r❡ ❛♥❞ s♦♠❡ t♦♦❧s t♦ ✈❡❝t♦r✐③❡ ❜✐t♠❛♣ ✐♠❛❣❡s✳
❖♥ t❤❡ ❤❛r❞✇❛r❡ s✐❞❡✱ t❤❡r❡ ❛r❡ ■▲❉❆ ✐♥t❡r❢❛❝❡s ✇✐t❤ ❯❙❇ ♦r ❊t❤❡r✲ ♥❡t ✐♥♣✉t ❛♥❞ ❡✈❡♥ ❛♥ ❖❊▼ s♦❧✉t✐♦♥ t♦ ✐♥t❡❣r❛t❡ t❤❡ ❞r✐✈❡r ✇✐t❤ ❛♥♦t❤❡r ❡❧❡❝tr♦♥✐❝ ❞❡✈✐❝❡✳ ❚❤❡r❡ ❛r❡ ❛❧s♦ ❞❡✈✐❝❡s t♦ ❞✐str✐❜✉t❡ ■▲❉❆ s✐❣♥❛❧ ❜❡✲ t✇❡❡♥ s❡✈❡r❛❧ ♣r♦❥❡❝t♦rs ❛♥❞ ❛ s❡t ♦❢ ♦♣t✐❝❛❧ ❧❡♥s❡s t♦ ❝♦✈❡r ❛ ✸✻✵➦ ❛♥❣❧❡✳ ❯♥❢♦rt✉♥❛t❡❧②✱ t❤♦s❡ s♦❧✉t✐♦♥s ❛r❡ ♦♥❧② ❛✈❛✐❧❛❜❧❡ ❢♦r ❲✐♥❞♦✇s ❜❛s❡❞ ❝♦♠♣✉t❡rs ❛♥❞ t❤♦s❡ ❛r❡ q✉✐t❡ ❡①♣❡♥s✐✈❡✳ ❚❤❡ s♠❛❧❧❡st ❞❡✈✐❝❡ ❝♦sts ✻✺✵e ❛♥❞ ♣r♦❢❡ss✐♦♥❛❧ t♦♦❧s st❛rt ❛r♦✉♥❞ ✹ ✵✵✵e✳

❊❧❡❝tr♦✲❝♦♥❝❡♣t ❊❧❡❝tr♦✲❝♦♥❝❡♣t✷ ❞❡✈❡❧♦♣❡❞ t✇♦ ❯❙❇ t♦ ■▲❉❆ ✐♥✲ t❡r❢❛❝❡s✱ ▼✐♥✐✐❧❞❛ ❛♥❞ ▼❛①✐✐❧❞❛✱ r❡s♣❡❝t✐✈❡❧② s♦❧❞ ❛t e ✷✺✾ ❛♥❞ e ✸✹✾✳ ❚❤♦s❡ t✇♦ ✐♥t❡r❢❛❝❡s ✇♦r❦s ✉♥❞❡r ❲✐♥❞♦✇s ✇✐t❤ t❤❡✐r ♦✇♥ s♦❢t✇❛r❡✳ ■✬✈❡ t❡st❡❞ t❤❡ ▼✐♥✐✐❧❞❛ ✇❤✐❝❤ ✇♦r❦s ✉♥❞❡r ▲✐♥✉① t❤❛♥❦s t♦ ❛ ♣✐❡❝❡ ♦❢ s♦❢t✇❛r❡ ■✬✈❡ ✇r✐tt❡♥✳ ❯♥❢♦rt✉♥❛t❡❧② ✐t✬s ♥♦t st❛❜❧❡ ❡♥♦✉❣❤ ❛♥❞ ❊❧❡❝tr♦✲ ❝♦♥❝❡♣t ❞♦❡s♥✬t ❛♣♣❡❛r t♦ ❜❡ ✐♥t❡r❡st❡❞ ✐♥ s✉❝❤ ❛ ❞❡✈❡❧♦♣♠❡♥t✳ ❙♦ t❤✐s ✇❛② ✇❛s ❡❛r❧② ❣✐✈❡♥ ✉♣✳

✷❤tt♣✿✴✴✇✇✇✳❜♦✉t✐q✉❡✲❡❧❡❝tr♦❝♦♥❝❡♣t✳❝♦♠✴❜♦✉t✐q✉❡✴ (http://www.boutique-electroconcept.com/boutique/)

✶✶

●❛❧❛①② ▲❛s❡r ❙❤♦✇ ❋♦r t❤❡ ❙✐❣♥ ♣r♦❥❡❝t ❜② ❙❛♠✉❡❧ ❇✐❛♥❝❤✐♥✐ ✭❝❢✳ ✺✮✱ ✇❡ ✇♦r❦❡❞ ✇✐t❤ ❙♦♥❛tr♦♥✐❝✱ ✇❤♦ ♣r♦❞✉❝❡s t❤❡ ●❛❧❛①② ▲❛s❡r ❙❤♦✇ ✐♥t❡r❢❛❝❡✱ t♦ ♣♦rt ✐t ♦♥ ▼❛❝ ❖❙ ❳ ❛♥❞ ▲✐♥✉①✳ ❚❤✐s ✇❛s ❛ ❣♦♦❞ ✐♥✐t✐❛t✐✈❡✱ ❡✈❡♥ ✐❢ t❤❡ s♦❢t✇❛r❡ s♦✉r❝❡ ✇❛s ♥♦t ♦♣❡♥✱ t❤✐s ✐s t❤❡ ✜rst ❝r♦ss✲♣❧❛t❢♦r♠ ✐♥t❡r❢❛❝❡ ■ ❦♥♦✇✳ ■t ✐s ❜❛s❡❞ ♦♥ ❛ s❡r✈❡r ✇r✐tt❡♥ ✐♥ ❈★ ❢r♦♠ t❤❡ ✳◆❊❚ ❢r❛♠❡✇♦r❦✸
✳ ❚❤✐s s❡r✈❡r ❝♦♠♠✉♥✐❝❛t❡s ✇✐t❤ t❤❡ ✐♥t❡r❢❛❝❡ ✇❤✐❝❤ ✐♥❝❧✉❞❡s ❛ ❋P●❆✳ P♦t❡♥t✐❛❧❧② ❛♥② s♦❢t✇❛r❡ ❝❛♣❛❜❧❡ ♦❢ s❡♥❞✐♥❣ ❯❉P ♣❛❝❦❡t ❝❛♥ ❜❡ ✉s❡❞ t♦ ❞r❛✇ ✇✐t❤ ❛ ❧❛s❡r ♣r♦❥❡❝t♦r✳
■✬✈❡ t❡st❡❞ t❤❡ r❡❧❡❛s❡s ✷ ❛♥❞ ✸ ♦❢ t❤❡ ✐♥t❡r❢❛❝❡✳ ❲✐t❤ t❤❡ r❡✈✐s✐♦♥ ✷✱ t❤❡ s♦❢t✇❛r❡ st♦♣s t❤❡ ❝♦♠♠✉♥✐❝❛t✐♦♥ ✇✐t❤ t❤❡ ❤❛r❞✇❛r❡ ✐❢ ♥❡t✇♦r❦ ♣❛❝❦❡ts ❛r❡ t♦♦ s♠❛❧❧ ♦r ✐❢ s❝❛♥♥❡rs✬ ❢r❡q✉❡♥❝② ✐s ❛❜♦✈❡ ✷✵ kpps✳ ❚❤❡ ✈❡rs✐♦♥ ✸ ■ ❤❛✈❡ t♦ t❡st ✇❛s ❜r♦❦❡♥ ✿ ❛s s♦♦♥ ❛s s♦♠❡t❤✐♥❣ ✐s ♣❧✉❣ ✐♥ t❤❡ ❙✉❜✲❉✷✺ t❤❡ ✐♥t❡r❢❛❝❡ ✐s ♥♦ ♠♦r❡ ❛✈❛✐❧❛❜❧❡ t♦ t❤❡ s♦❢t✇❛r❡✳

❜■▲❉❆ ♣r♦❥❡❝t ❜■▲❉❆ ✐s ❛♥ ♦♣❡♥ s♦✉r❝❡ ❯❙❇ t♦ ■▲❉❆ ✐♥t❡r❢❛❝❡ ♣r♦❥❡❝t✳ ■t ❝♦♠❡s ✇✐t❤ ❛♥ ❡❧❡❝tr♦♥✐❝ ❜♦❛r❞ ❛♥❞ ❛ s♦❢t✇❛r❡✳ ❚❤✐s ✐s ✉♥❢♦r✲ t✉♥❛t❡❧② ♦❜s♦❧❡t❡ ✿ t❤❡ ❜♦❛r❞ ✐s ❜❛s❡❞ ♦♥ t❤❡ ❝❤✐♣ ❆◆✷✶✸✺❙❈ ❢r♦♠ ❈②♣r❡ss ❙❡♠✐❝♦♥❞✉❝t♦r ✇❤✐❝❤ ✐s ♥♦ ♠♦r❡ ♣r♦❞✉❝❡❞✳ ▼♦r❡♦✈❡r ✐ts ♣❡r❢♦r♠❛♥❝❡s ✇❡r❡ ♥♦t ✈❡r② ❣♦♦❞ ✿ ♦♥❧② ✽ bit ❉❆❈✳

❊t❤❡r❞r❡❛♠✹ ❊t❤❡r❞r❡❛♠ ✐s ❛♥ ♦♣❡♥ s♦✉r❝❡ ❛♥❞ ✈❡rs❛t✐❧❡ ■▲❉❆ ✐♥✲ t❡r❢❛❝❡✳ ■t s✉♣♣♦rts str❡❛♠✐♥❣ ♣❧❛②❜❛❝❦ ♦✈❡r ❡t❤❡r♥❡t ✉♣ t♦ ✶✵✵ kpps✳ ❆❧❧ ❢❡❛t✉r❡s ❝❛♥ ❜❡ ❝♦♥tr♦❧❧❡❞ t❤r♦✉❣❤ ❖❙❈ ❛♥❞ ✐t ♣r♦✈✐❞❡s ❛ ♣❡rs♣❡❝✲ t✐✈❡ ❝♦rr❡❝t✐♦♥ t♦♦❧✳ ■t ❝♦✉❧❞ r✉♥ st❛♥❞❛❧♦♥❡ t❤❛♥❦s t♦ ✐ts ♠✐❝r♦❙❉ ❝❛r❞ r❡❛❞❡r✳ ❯♥❢♦rt✉♥❛t❡❧② ■ ♦♥❧② ❞✐s❝♦✈❡r t❤✐s ✐♥t❡r❢❛❝❡ ❛❢t❡r ❞❡s✐❣♥✐♥❣ ♠② ♦✇♥ ♦♥❡✳ ❚❤❡ ❜♦t❤ ♣r♦✈✐❞❡ s✐♠✐❧❛r ❢✉♥❝t✐♦♥♥❛❧✐t✐❡s ❛♥❞ ❛r❡ ♦♣❡♥ s♦✉r❝❡✳ ❊t❤❡r❞r❡❛♠ ✐♥t❡r❢❛❝❡ ✐s ❛✈❛✐❧❛❜❧❡ ✇✐t❤ ❝❛s❡ ❛♥❞ ♣♦✇❡r s✉♣♣② ❢♦r ✩ ✷✹✾✳

❆❧t❡r♥❛t✐✈❡ s♦❧✉t✐♦♥s ❆s ✐s ✇❛s s❡❡♥ ✐♥ ✶✳✶✱ s❡✈❡r❛❧ ❛rt✐sts ✉s❡ s♦✉♥❞ ❝❛r❞ t♦ ❞r✐✈❡ ❧❛s❡r ❛♥❞ ❡s♣❡❝✐❛❧❧② t❤❡ ▼❖❚❯ ❚r❛✈❡❧❧❡r✳ ❚❤✐s s♦✉♥❞ ❝❛r❞ ❤❛s ♥♦ ❉❈ ✜❧t❡rs ♦♥ ♦✉t♣✉t s♦ t❤❛t ✇❡ ❝❛♥ ♣r♦❞✉❝❡ ❛♥ ❛s②♠♠❡tr✐❝❛❧ s✐❣♥❛❧ ❢r♦♠ t❤❡ ❣r♦✉♥❞ ❛♥❞ t❤✉s tr❛♥s❧❛t❡ t❤❡ ❞r❛✇✐♥❣ ❤♦r✐③♦♥t❛❧❧② ♦r ✈❡rt✐❝❛❧❧② ❢r♦♠ t❤❡ ♣r♦❥❡❝t✐♦♥ ❝❡♥t❡r✳ ❚❤♦s❡ ❛rt✐sts ✉s❡s t❤❡✐r ♦✇♥ s♦❢t✲ ✇❛r❡ ✭♦❢t❡♥ ♠❛❞❡ ✇✐t❤ ▼❛①✴▼❙P✮ ❛♥❞ t❤❡✐r ♦✇♥ ❡❧❡❝tr✐❝❛❧ ❛❞❛♣t❛t✐♦♥ ❡❧❡❝tr♦♥✐❝✳

✸
✳◆❊❚ ✐s ❛ ▼✐❝r♦s♦❢t t❡❝❤♥♦❧♦❣② ❛✈❛✐❧❛❜❧❡ ♦♥ ▼❛❝ ❖❙ ❳ ❛♥❞ ▲✐♥✉① t❤❛♥❦s t♦ t❤❡ ♦♣❡♥ s♦✉r❝❡ ▼♦♥♦ ❢r❛♠❡✇♦r❦✳
✹❤tt♣✿✴✴❡t❤❡r✲❞r❡❛♠✳❝♦♠✴ (http://ether-dream.com/)

✶✷

✷ | ❚❤❡ ▲❛s❡r ❉r❛✇❡r ♣r♦❥❡❝t
✷✳✶ | ❙♣❡❝✐✜❝❛t✐♦♥s

❱❡rs❛t✐❧✐t② ❚❤❡ ♠♦st ✐♠♣♦rt❛♥t t❤✐♥❣ ✐s t♦ ❜❡ ❝♦♠♣❛t✐❜❧❡ ✇✐t❤ ❝♦♠✲ ♠❡r❝✐❛❧ ❧❛s❡r ♣r♦❥❡❝t♦rs✳ ❚❤♦s❡ ❧❛s❡r ♠♦st❧② ✉s❡ t❤❡ ■▲❉❆ ♣r♦t♦❝♦❧✳ ❙♦ t❤❛t t❤❡ ✐♥t❡r❢❛❝❡ s❤♦✉❧❞ ❜❡ ■▲❉❆ ❝♦♠♣❧✐❛♥t✳

Pr✐❝❡ ❈♦♠♠❡r❝✐❛❧ s♦❧✉t✐♦♥s ❝♦st s❡✈❡r❛❧ ❤✉♥❞r❡❞ ❡✉r♦s✱ ▲❛s❡r ❉r❛✇❡r s❤♦✉❧❞ ❜❡ ❝❤❡❛♣ t❤❛♥❦s t♦ t❤❡ ✉s❡ ♦❢ ✇✐❞❡s♣r❡❛❞ ❡❧❡❝tr♦♥✐❝ ❞❡✈✐❝❡s ❛♥❞ ❛ ❢r❡❡ ❛♥❞ ♦♣❡♥ s♦✉r❝❡ s♦❢t✇❛r❡✳
▲❛s❡r ❉r❛✇❡r s❤♦✉❧❞ ✇♦r❦ ✇✐t❤ ♠♦st ♦❢ ♦♣❡r❛t✐♥❣ s②st❡♠ ✭▼✐❝r♦s♦❢t ❲✐♥❞♦✇s✱ ❆♣♣❧❡ ▼❛❝ ❖❙ ❳✱ ❛♥❞ ▲✐♥✉① ❞✐str♦s ❧✐❦❡ ❉❡❜✐❛♥✲❜❛s❡❞ s②st❡♠ ✭❯❜✉♥t✉ ❛♥❞ ❘❛s♣❜✐❛♥✮✮✳

✷✳✷ ❙♦❢t✇❛r❡ ❛♥❞ ❤❛r❞✇❛r❡ ❞❡s✐❣♥

▲❛s❡r ❉r❛✇❡r ❤❛s ❛ ❤❛r❞✇❛r❡ ♣❛rt ❛♥❞ ✐ts ❛ss♦❝✐❛t❡❞ s♦❢t✇❛r❡✳

✷✳✷✳✶ ❍❛r❞✇❛r❡

❚❤❡ ❤❛r❞✇❛r❡ ♣❛rt ✐s ❜❛s❡❞ ♦♥ ❛ s♦✉♥❞ ❝❛r❞ ❛♥❞ ❛ ❡❧❡❝tr✐❝ ❛❞❛♣t❛t✐♦♥ ❜♦❛r❞✳

❙♦✉♥❞ ❝❛r❞ ■ ❝❤♦♦s❡ t❤❡ ❊❙■ ❯❉❏✲✻ s♦✉♥❞ ❝❛r❞ ❜❡❝❛✉s❡ ✐t✬s ❯❙❇ ❆✉❞✐♦ ✶✳✵ ❝♦♠♣❧✐❛♥t✱ t❤✉s ✐t ✇✐❧❧ r✉♥ ❞r✐✈❡r ❢r❡❡ ♦♥ ♠♦st ❝✉rr❡♥t ❖❙✳ ■t ❤❛s ✻ ❛♥❛❧♦❣ ♦✉t♣✉ts ❛♥❞ ♥♦ ✐♥♣✉t✱ ♣❡r❢❡❝t t♦ ❞r✐✈❡ ❛ ❘●❇ ❧❛s❡r✳ ■t r✉♥s ❛t ✹✽ Hz ♦♥ ✷✹ bit s♦ ✐t ❛❧❧♦✇s t♦ ❞r✐✈❡ ❧❛s❡r ✉♣ t♦ ✹✽ kpps ✇✐t❤ ❛ ✈❡r② ❣♦♦❞ ♣r❡❝✐s✐♦♥✳
❚❤✐s s♦✉♥❞ ❝❛r❞ ❤❛s ❉❈ ✜❧t❡r ♦♥ ♦✉t♣✉t✳ ❚♦ r❡♠♦✈❡ t❤❡♠✱ ✐t✬s ❥✉st ♥❡❡❞❡❞ t♦ s❤♦rt ❝✐r❝✉✐t s♦♠❡ ❝♦♥❞❡♥s❡rs ❜② s♦❧❞❡r ✇✐r❡ ❛s s❤♦✇♥ ✐♥ ✜❣✉r❡ ✶✵✳

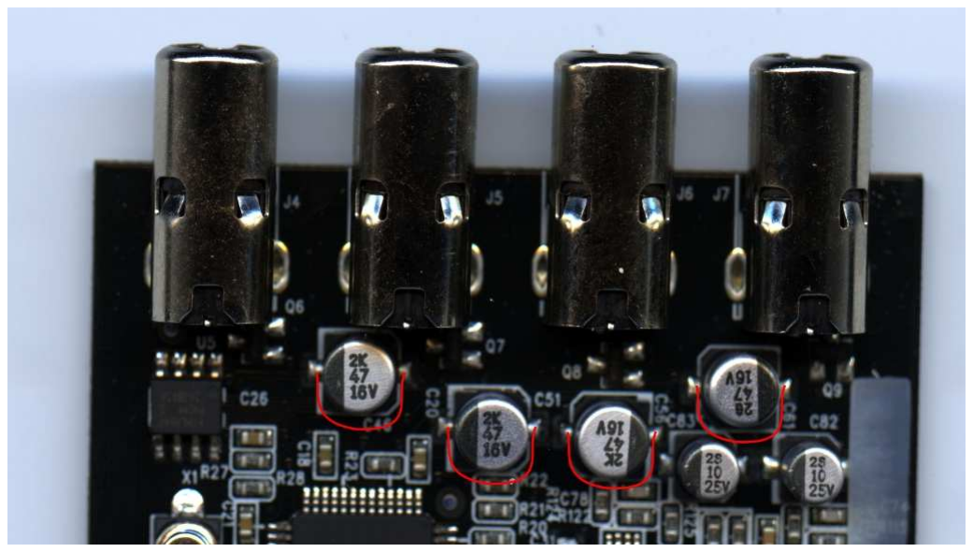
[picture p12: figure]

❋✐❣✉r❡ ✶✵✿ ❉❈ ✜❧t❡r ❜②♣❛ss❡❞

✶✸

❊❧❡❝tr✐❝❛❧ ❛❞❛♣t❛t✐♦♥ st❛❣❡ ❚❤❡ s♦✉♥❞ ❝❛r❞ ❞❡❧✐✈❡r ❛ ✵✳✻ V ♣❡❛❦✲ t♦✲♣❡❛❦ s✐❣♥❛❧ ✇❤❡r❡❛s t❤❡ ■▲❉❆ ♣r♦t♦❝♦❧ r❡q✉✐r❡s ✶✵ V ♣❡❛❦✲t♦✲♣❡❛❦ s✐❣♥❛❧s✳ ❚❤❡♥ ❛♥ ❡❧❡❝tr✐❝❛❧ ❛❞❛♣t✐♦♥ st❛❣❡ ✐s ♥❡❡❞❡❞✳ ❋♦r ♣r❛❝t✐❝❛❧ r❡❛✲ s♦♥s✱ ■ ❝❤♦♦s❡ t♦ ♣♦✇❡r t❤✐s st❛❣❡ ❞✐r❡❝t❧② ❢r♦♠ t❤❡ ❯❙❇ ♣♦✇❡r ♦❢ t❤❡ s♦✉♥❞ ❝❛r❞✳ ■ ❝❤♦♦s❡ ❛ r❛✐❧✲t♦✲r❛✐❧ ♦♣✲❛♠♣ t♦ r❡❛❝❤ t❤❡ ♣♦✇❡r s✉♣♣❧② ✈❛❧✉❡ ✭✺ V✮✳ ▼♦r❡♦✈❡r t❤❡ ❧❛s❡r ♣r♦❥❡❝t♦r ■ ❤❛✈❡ ✐s ♥♦t r❡❛❧❧② ■▲❉❆ ❝♦♠✲ ♣❧✐❛♥t ✭❛♥❞ ②❡s✱ ✐t✬s ❛ ♣✐t②✮ ✿ t❤❡ ■▲❉❆ ✐♥♣✉t ✐s ♥♦t ❜❛❧❛♥❝❡❞✳ ❙♦ ■✬✈❡ ❞❡❝✐❞❡❞ t♦ ♠❛❦❡ t❤❡ ♣r♦t♦t②♣❡ ♥♦t ■▲❉❆ ❝♦♠♣❧✐❛♥t ❜✉t ❛t ❧❡❛st ✇♦r❦✐♥❣ ✇✐t❤ t❤✐s ♣r♦❥❡❝t♦r✳
❚❤✐s ❤❛s s❡✈❡r❛❧ ❝♦♥s❡q✉❡♥❝❡s✳ ❋✐rst t❤❡ s✐❣♥❛❧ ✐s ♠♦r❡ s❡♥s✐t✐✈❡ t♦ ❡❧❡❝tr♦✲♠❛❣♥❡t✐❝ ♣❡rt✉r❜❛t✐♦♥s✱ s♦ t❤❡ ❝❛❜❧❡ ❧❡♥❣t❤ s❤♦✉❧❞ ❜❡ ❛s s❤♦rt ❛s ♣♦ss✐❜❧❡ ❜❡t✇❡❡♥ t❤❡ ✐♥t❡r❢❛❝❡ ❛♥❞ t❤❡ ❧❛s❡r✳ ❚❤❡♥ ✇❡ ❦❡❡♣ ♦♥❧② t❤❡ ♣♦s✐t✐✈❡ ♣❛rt ♦❢ t❤❡ s✐❣♥❛❧ ❛♥❞ ✐♥st❡❛❞ ♦❢ ✶✵ V ♣❡❛❦✲t♦✲♣❡❛❦ ✇❡ ❣❡t ♦♥❧② ✺ V✳ ❚❤❡ s❝❛♥♥✐♥❣ ❛r❡❛ ✐s ❛❧s♦ ❞✐✈✐❞❡❞ ❜② t✇♦ ❜✉t t❤✐s s✐♠♣❧✐✜❡s t❤❡ ❡❧❡❝tr♦♥✐❝✳

✷✳✷✳✷ ❙♦❢t✇❛r❡

❚❤❡ s♦❢t✇❛r❡ ✐s ♠❛✐♥❧② ❛♥ ❖❙❈ s❡r✈❡r✳ ■t r❡❝❡✐✈❡s ♣♦✐♥ts ✐♥ s❡✈❡r❛❧ ❖❙❈ ❜❧♦❜s✺ ♣❛❝❦❡❞ ✐♥ ♦♥❡ ❖❙❈ ♠❡ss❛❣❡✳ ❆❧❧ ❜❧♦❜s s❤♦✉❧❞ ❤❛✈❡ t❤❡ s❛♠❡ s✐③❡✳ ❚❤❡② ❝♦rr❡s♣♦♥❞ r❡s♣❡❝t✐✈❡❧② t♦ ❝❤❛♥♥❡❧ ❳✱ ❨✱ r❡❞✱ ❣r❡❡♥ ❛♥❞ ❜❧✉❡✳ ❚❤r❡❡✱ ❢♦✉r ♦r ✜✈❡ ❜❧♦❜s s❤♦✉❧❞ ❜❡ s❡♥❞ s✐♠✉❧t❛♥❡♦✉s❧② t♦ ✉♣❞❛t❡ ❛s ♠❛♥② t❛❜❧❡s✳ ❚❤❡ ♣r♦❥❡❝t✐♦♥s ♣❛r❛♠❡t❡rs ❛r❡ s❡♥t s❡♣❛r❛t❡❧② ✇✐t❤ ♦♥❡ ❖❙❈ ♠❡ss❛❣❡ ♣❡r ♣❛r❛♠❡t❡r✳ ❚❤❡ t❛❜❧❡ ✶ s❤♦✇s ❛❧❧ s✉♣♣♦rt❡❞ ♠❡ss❛❣❡s✳ ❋✐✈❡ t❛❜❧❡s ❦❡❡♣ t❤❡ ♣♦✐♥ts ✐♥ ♠❡♠♦r② ❛♥❞ t❤❡♥ t❤❡② ❛r❡ ♣❧❛②❡❞ ❛♥❞ tr❛♥s❢♦r♠❡❞ ❛❝❝♦r❞✐♥❣ t♦ ♣r♦❥❡❝t✐♦♥ ♣❛r❛♠❡t❡rs✳
❚❤❡ ❡♥❞ ❧✐♥❡ ❝♦rr❡❝t✐♦♥ ♦✛s❡ts t❤❡ ✐♥t❡♥s✐t② t❛❜❧❡ ♣❧❛②❤❡❛❞ ❜② ❛ s♠❛❧❧ ❛♠♦✉♥t t♦ ❝♦♠♣❡♥s❛t❡ t❤❡ ❞✐♦❞❡ s✇✐t❝❤✐♥❣ ❧❛t❡♥❝②✳ ❚❤✐s ❛ss✉♠❡s t❤❡ ❧❛t❡♥❝② ✐s ❝♦♥st❛♥t ❜✉t t❤✐s ✇❛s ♥♦t ✈❡r✐✜❡❞✳
❚❤❡ ❖❙❈ s❡r✈❡r ❛♥❞ ✐ts ❛ss♦❝✐❛t❡❞ ❝❧✐❡♥t ❛r❡ ❜✉✐❧❞ ✐♥ P✉r❡❞❛t❛✳ ❇♦t❤ ❞❡♣❡♥❞ ♦♥ t❤❡ ■▲❉❆ ❧✐❜r❛r② ❢♦r P✉r❡❞❛t❛✳ ❚❤✐s ❧✐❜r❛r② ♣r♦✈✐❞❡s t❤r❡❡ ❡①t❡r♥❛❧s ❛♥❞ ✐s ♣❛rt ♦❢ t❤❡ ▲❛s❡r ❉r❛✇❡r ♣r♦❥❡❝t✳ ❚❤❡ ✐❧❞❛s❡♥❞ ❡①t❡r✲ ♥❛❧ ❢♦r♠❛ts ❛♥❞ s❡♥❞s ❞❛t❛ ♦✈❡r ♥❡t✇♦r❦ ✇❤❡r❡❛s ✐❧❞❛r❡❝❡✐✈❡ r❡❝❡✐✈❡s ❛♥❞ ❞❡❝♦❞❡s t❤❡♠✳ ❚❤❡ ✐❧❞❛❢✐❧❡ ❡①t❡r♥❛❧✱ ❜❛s❡❞ ♦♥ ❜✐♥❢✐❧❡ ❜② ▼❛r✲ t✐♥ P❡❛❝❤✱ r❡❛❞s ✳✐❧❞ ✜❧❡s ❛♥❞ ❧♦❛❞ t❤❡✐r ❝♦♥t❡♥t ❢r❛♠❡ ❜② ❢r❛♠❡ ✐♥t♦ ❛ t❛❜❧❡✳
❚❤❡ s❡r✈❡r✴❝❧✐❡♥t ❛r❝❤✐t❡❝t✉r❡ ❛❧❧♦✇s t♦ r✉♥ ❡❛❝❤ ♦♥❡ ♦♥ ❛ s❡♣❛r❛t❡ ❝♦♠♣✉t❡r✳ ■ r❛♥ t❤❡ s❡r✈❡r ♦♥ ❘❛s♣❜❡rr② P✐ ❜✉t ✉♥❢♦rt✉♥❛t❡❧② ■ ❣♦t ❝r❛❝❦❧❡s ♦♥ s♦✉♥❞ ❛♥❞ ✐t r❡s✉❧ts ✐♥ ❛rt✐❢❛❝ts ✐♥ t❤❡ ❞r❛✇✐♥❣✳ ❚❤✐s ✐s ❞✉❡ t♦ s♦♠❡ ✐ss✉❡ ♦♥ t❤❡ ✐♥t❡r♥❛❧ ✜r♠✇❛r❡✳ ❚❤✐s ❝♦✉❧❞ ❜❡ ✜① ❜② t✉♥✐♥❣ s♦♠❡ ♣❛r❛♠❡t❡rs ❧✐❦❡ ❞✐s❛❜❧✐♥❣ t❤❡ t✉r❜♦ ♠♦❞❡ ♦❢ t❤❡ ❊t❤❡r♥❡t ❝♦♥tr♦❧❧❡r✳ ❇✉t ■ ❞✐❞♥✬t tr② ✐t ②❡t✳
❙♦❢t✇❛r❡ s♦✉r❝❡s ❛♥❞ ❡①❛♠♣❧❡s ❛r❡ ❛✈❛✐❧❛❜❧❡ ♦♥ ♠② ❣✐t❤✉❜ ✿ ❤tt♣s✿ ✴✴❣✐t❤✉❜✳❝♦♠✴❛✈✐❧❧❡r❡t✴❧❛s❡r❴❞r✐✈❡r✳ (https://github.com/avilleret/laser_driver)

✺❜❧♦❜ ✐s ❛♥ ❖❙❈ ❞❛t❛t②♣❡ ✇✐t❤ ✇❤✐❝❤ ✇❡ ❝❛♥ tr❛♥s♠✐t ❛r❜✐tr❛r② ❞❛t❛✳

✶✹

▼❡ss❛❣❡ | P❛r❛♠❡t❡r ❜ ✿ ❜❧♦❜ ❢ ✿ ❢❧♦❛t | ❊✛❡❝t
✴❛rr❛②s | ❜❜❜④❜⑥④❜⑥ | ❯♣❞❛t❡ t❛❜❧❡s ✈❛❧✉❡s
✴s❡tt✐♥❣✴♦❢❢s❡t | ❢❢❢ | ❖✛s❡t ♦♥ ❡❛❝❤ ❝❤❛♥♥❡❧✱ r❡s♣✳ ❳✱ ❨ ❛♥❞ ✐♥t❡♥s✐t②
✴s❡tt✐♥❣✴s❝❛❧❡ | ❢❢❢ | ❙❝❛❧❡ ♦♥ ❡❛❝❤ ❝❛❤♥♥❡❧✱ r❡s♣✳ ❳✱ ❨ ❛♥❞ ✐♥t❡♥s✐t②
✴s❡tt✐♥❣✴✐♥✈❡rt | ❢❢❢ | ■♥✈❡rt ❡❛❝❤ ❝❤❛♥♥❡❧✱ r❡s♣✳ ❳✱ ❨ ❛♥❞ ✐♥t❡♥s✐t②
✴s❡tt✐♥❣✴✐♥t❡♥s✐t② | ❢❢❢ | ■♥t❡♥s✐t② ♦♥ ❡❛❝❤ ❝♦❧♦r ❝❤❛♥♥❡❧✱ r❡s♣✳ ❘✱ ● ❛♥❞ ❇
✴s❡tt✐♥❣✴❜❧❛♥❦✐♥❣❴♦❢❢ | ❢ | ❚✉r♥ ♦✛ ❜❧❛♥❦✐♥❣
✴s❡tt✐♥❣✴❛♥❣❧❡❴❝♦rr❡❝t✐♦♥ | ❢ | ❆♥❣❧❡ ❝♦rr❡❝t✐♦♥ ♣❛r❛♠❡t❡r ✭♥♦t ✐♠✲ ♣❧❡♠❡♥t❡❞ ②❡t✮
✴s❡tt✐♥❣✴❡♥❞❴❧✐♥❡❴❝♦rr❡❝t✐♦♥ | ❢ | ❊♥❞ ❧✐♥❡ ❝♦rr❡❝t✐♦♥
✴s❡tt✐♥❣✴s❝❛♥❴❢r❡q | ❢ | ❙❝❛♥♥❡r ❢r❡q✉❡♥❝② ✐♥ kHz
✴s❡tt✐♥❣✴♣❡rs♣❡❝t✐✈❡❴❝♦rr❡❝t✐♦♥ | ❢ | ❚✉r♥ ♣❡rs♣❡❝t✐✈❡ ❝♦rr❡❝t✐♦♥ ♦♥ ❛♥❞ ♦✛
✴s❡tt✐♥❣✴❞st❴♣♦✐♥t | ❢❢❢❢❢❢❢❢ | ✹ ❝♦r♥❡rs ❝♦♦r❞✐♥❛t❡s t♦ ❞❡✜♥❡ ♣r♦✲ ❥❡❝t✐♦♥ ❛r❡❛ ❛♥❞ t♦ ❝♦rr❡❝t ♣❡rs♣❡❝✲ t✐✈❡

❚❛❜❧❡ ✶✿ ❍❛♥❞❧❡❞ ❖❙❈ ♠❡ss❛❣❡s

✶✺

✷✳✸ ▲❛s❡r ❉r❛✇❡r ✈s✳ ●❛❧❛①② ▲❛s❡r ❙❤♦✇

❚❤✐s s❡❝t✐♦♥ s❤♦✇s t❤❡ ♣❡r❢♦r♠❛♥❝❡s ♦❢ ▲❛s❡r ❉r❛✇❡r ❛♥❞ ●❛❧❛①② ▲❛s❡r ❙❤♦✇ s✐❞❡ ❜② s✐❞❡✳ ■ ✉s❡ t❤❡ ■▲❉❆ t❡st ♣❛tt❡r♥ ✭❝❢✳ ✜❣✉r❡ ✶✶✮ ❛♥❞ ♦❜s❡r✈❡ ✐t ❜♦t❤ ✇✐t❤ ❛♥ ♦s❝✐❧❧♦s❝♦♣❡ ❛♥❞ ♣r♦❥❡❝t❡❞ ❜② t❤❡ ❧❛s❡r✳ ❚❤✐s ♣❛tt❡r♥ ✐s ✉s❡❞ t♦ t✉♥❡ ♣r♦❥❡❝t♦r ❜② ❝❤❛♥❣✐♥❣ t❤❡ ❤✐❣❤ ❛♥❞ ❧♦✇ ❞❛♠♣✐♥❣ ♦❢ ❣❛❧✲ ✈❛♥♦♠❡t❡rs✳ ❖♥ t❤❡ ✜❣✉r❡ ✶✶❝ t❤❡ ❜❧✉❡ ❝✐r❝❧❡ ❛♣♣❡❛rs ✐♥s✐❞❡ t❤❡ ❣r❡❡♥ sq✉❛r❡ ✇❤❡r❡❛s ♦♥ t❤❡ ✈❡❝t♦r ✐♠❛❣❡ ✶✶❜ ✐t ❛♣♣❡❛rs ♦✉ts✐❞❡✳ ❚❤✐s ✐s ❤♦✇ ❛ ✇❡❧❧ t✉♥❡❞ ❧❛s❡r s❤♦✉❧❞ r❡s♣♦♥❞s ❛❝❝♦r❞✐♥❣ t♦ ■▲❉❆ r❡❝♦♠♠❡♥❞❛t✐♦♥✳ ❚❤❡ ✜rst ♦❜s❡r✈❛t✐♦♥ ✐s t❤❛t ●❛❧❛①② ✐♥t❡r❢❛❝❡ ❞♦❡s♥✬t ✐♥t❡r♣♦❧❛t❡ ❝♦♥✲ t✐♥✉♦✉s❧② ❜❡t✇❡❡♥ ♣♦✐♥ts✳ ❲❡ s❤♦✇ ♦♥❧② ♣♦✐♥ts✱ ♥♦t ❧✐♥❡s✳ ❖♥ t❤❡ ✜❣✉r❡ ✶✶❛✱ t❤❡ ❜❧✉❡ ❝✐r❝❧❡ ✐s ♠❛❞❡ ♦❢ ✶✷ ♣♦✐♥ts ✇❤❡r❡❛s ♦♥ t❤❡ ✜❣✉r❡ ✶✷❜ t❤❡r❡ ❛r❡ ✸✵ ❛♥❞ ♦♥ ✜❣✉r❡ ✶✷❛ t❤❡ ❝✐r❝❧❡ ❧✐♥❡ ✐s ❝♦♥t✐♥✉♦✉s✳ ❚❤✐s ✐s ❛♥ ✐ss✉❡ ❢♦r t✇♦ r❡❛s♦♥s✳ ❋✐rst ✇❡ ✇✐❧❧ s❡❡ ♣♦✐♥ts ✐♥st❡❛❞ ♦❢ ❧✐♥❡s ✇✐t❤ ❛ ❧♦✇ ❧❛✲ t❡♥❝② ❧❛s❡r ❞✐♦❞❡✳ ❆♥❞ t❤❡♥ ❜② ❛❞❞✐♥❣ ♣♦✐♥ts✱ t❤❡ ❞r❛✇✐♥❣ ✐s ♥♦t r✐❣❤t ✭❛❝❝♦r❞✐♥❣ t♦ ■▲❉❆ r❡❝♦♠♠❡♥❞❛t✐♦♥✮✱ t❤❡ ❝✐r❝❧❡ ❛♣♣❡❛rs ♦✉ts✐❞❡ ♦❢ t❤❡ sq✉❛r❡ ✇✐t❤ ❛ ✇❡❧❧ t✉♥❡❞ ❧❛s❡r ✭❝❢✳ ✜❣✉r❡ ✶✹❜✮✳
❚❤❡ ✜❣✉r❡ ✶✸ s❤♦✇s ●❛❧❛①② ✐s ♠♦r❡ st❛❜❧❡ t❤❛♥ ▲❛s❡r ❉r❛✇❡r✬s ✇❤❡♥ ✐♥❝r❡❛s✐♥❣ s❝❛♥♥❡rs ❢r❡q✉❡♥❝②✳ ❇✉t ✇✐t❤ ●❛❧❛①②✱ s♦♠❡ ♣♦✐♥t ❜❡❝♦♠❡ ❧✐❣❤t❡r ✇❤❡♥ ✐♥❝r❡❛s✐♥❣ s❝❛♥♥❡r ❢r❡q✉❡♥❝②✳
❚❤❡ s♠❛❧❧ ❛rt✐❢❛❝ts ♦♥ t❤❡ ❝✐r❝❧❡ ✐♥ ✜❣✉r❡ ✶✸❛ ❛r❡ ♥♦♥✲❧✐♥❡❛r✐t✐❡s ♦❢ ♦♣✲❛♠♣ ❞✉❡ t♦ ♣♦✇❡r s✉♣♣❧② r❡❛❝❤✐♥❣ t❤❡ ♦♣✲❛♠♣✬s ❧✐♠✐ts✳ ❉✉r✐♥❣ t❤❡ t❡sts✱ t❤❡ ❜♦❛r❞ ✇❛s s✉♣♣❧✐❡❞ ❜② t❤❡ ❧❛s❡r✬s ♠❛✐♥ ✶✺ V✴✲✶✺ V✳ ❚❤❡ ▲▼✸✺✽ ♦♣✲❛♠♣ ✇❡r❡ ❛❜♦✉t t♦ ✜r❡✳ ❚❤❡ ✉s❡ ♦❢ ♦t❤❡r ♦♣✲❛♠♣ ❛♥❞ ❧♦✇s❡r ♣♦✇❡r s✉♣♣❧② s❤♦✉❧❞ ✜① t❤✐s✳

✶✻

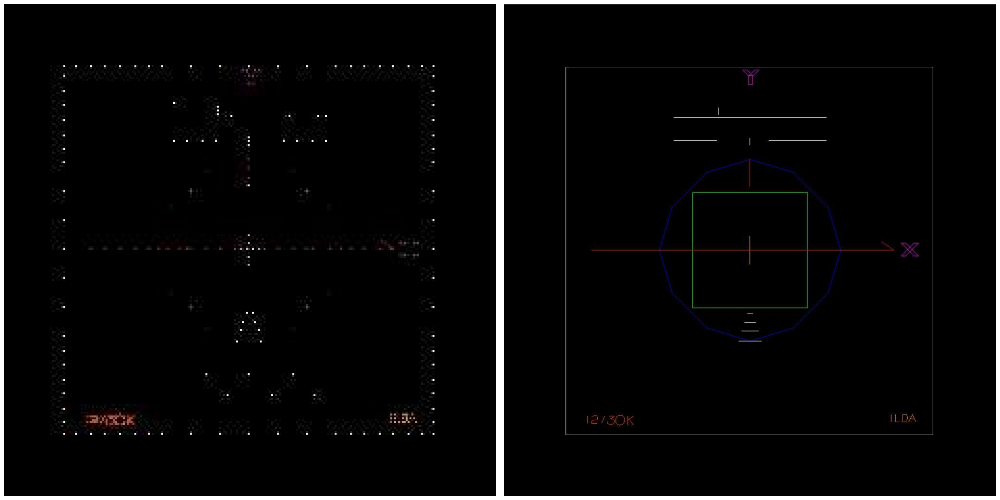
[picture p13: figure]

✭❛✮ P♦✐♥ts | ✭❜✮ ❱❡❝t♦rs

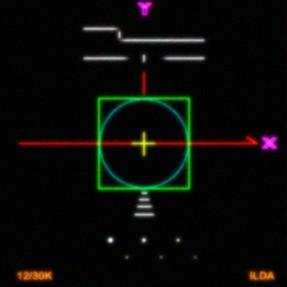
[picture p14: figure]

✭❝✮ Pr♦❥❡❝t❡❞ ✇✐t❤ ❛ ✇❡❧❧ t✉♥❡❞ ❧❛s❡r

❋✐❣✉r❡ ✶✶✿ ■▲❉❆ ♣❛tt❡r♥ ✿ ♣♦✐♥ts✱ ✈❡❝t♦rs ❛♥❞ r❡❢❡r❡♥❝❡ ♣r♦❥❡❝t✐♦♥

✶✼

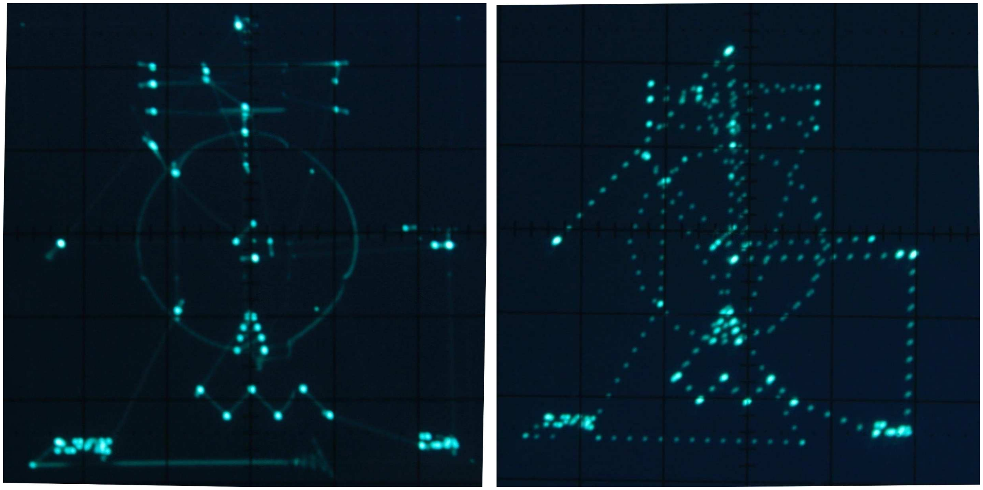
[picture p15: figure]

✭❛✮ ▲❛s❡r ❉r❛✇❡r | ✭❜✮ ●❛❧❛①②

❋✐❣✉r❡ ✶✷✿ ❖♥ ♦s❝✐❧❧♦s❝♦♣❡ ❛t ✶✷ kpps

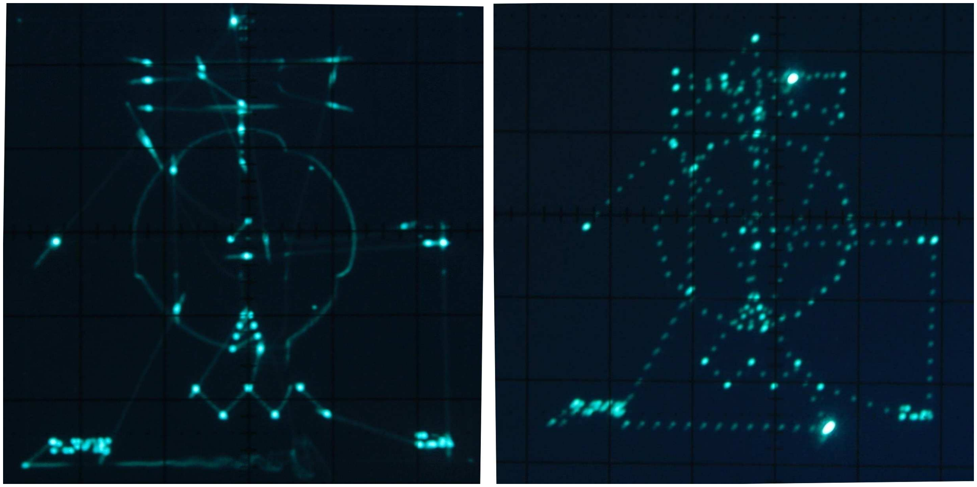
[picture p16: figure]

✭❛✮ ▲❛s❡r ❉r❛✇❡r ✕ ✹✽ kpps | ✭❜✮ ●❛❧❛①② ✕ ✶✵✵ kkps

❋✐❣✉r❡ ✶✸✿ ❍✐❣❤❡st s♣❡❡❞ s❤♦✇♥ ♦♥ ♦s❝✐❧❧♦s❝♦♣❡

✶✽

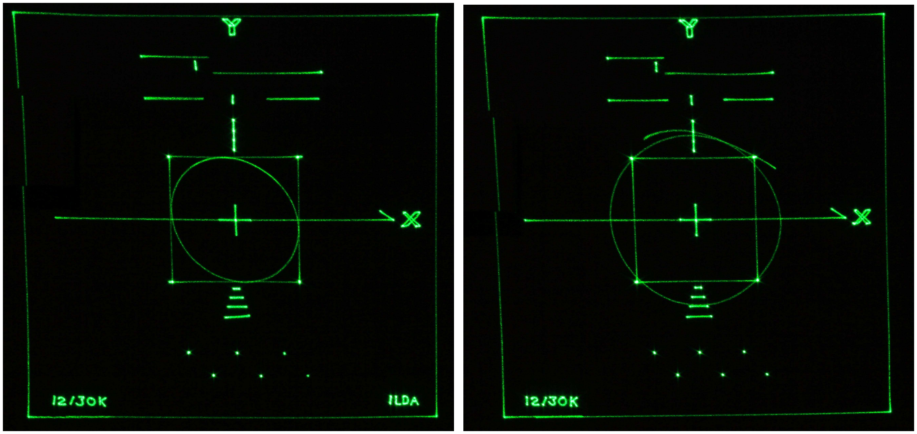
[picture p17: figure]

✭❛✮ ▲❛s❡r ❉r❛✇❡r | ✭❜✮ ●❛❧❛①②

❋✐❣✉r❡ ✶✹✿ ▲❛s❡r ♣r♦❥❡❝t✐♦♥ ❛t ✶✷ kpps

✶✾

## ❆♣♣❡♥❞✐① ❆ ❊❧❡❝tr♦♥✐❝ ❙❝❤❡♠❛t✐❝s

❚❤❡ ♣r♦t♦t②♣❡ s❝❤❡♠❛t✐❝ ♦♥ ✜❣✉r❡ ✶✺ ✇♦r❦s ❜✉t ❤❛s s♦♠❡ ❞❡❢❡❝ts✳ ❋✐rst ✐t✬s ♥♦t r❡❛❧❧② ■▲❉❆ ❝♦♠♣❧✐❛♥t s✐♥❝❡ t❤❡ ♦✉t♣✉t ✐s♥✬t ❜❛❧❛♥❝❡❞✳ ❆❧s♦ t❤❡r❡ ✐s ♥♦ s❤♦rt ❝✐r❝✉✐t ♣r♦t❡❝t✐♦♥ ♦♥ ♦✉t♣✉ts✳ ❚❤❡ ♦♣✲❛♠♣s ❝♦✉❧❞ ❜❡ ❞❛♠❛❣❡❞ ❜② ❛ ❝♦♥♥❡❝t✐♦♥ ❡rr♦r ♦r ❛ ❤❛r❞✇❛r❡ ❢❛✐❧✉r❡✳
❚❤❡ ❜♦❛r❞ ✇❛s ♣♦✇❡r❡❞ ❜② ❯❙❇ ❜✉t t❤❡r❡ ✐s ♦♥❧② ✹✳✽✺ V ♦♥ t❤❡ ❡♥❞ ❛♥❞ ✐t✬s ♥♦t ❡♥♦✉❣❤ ❢♦r ❉❈✴❉❈ ❝♦♥✈❡rt❡r t♦ ✇♦r❦ ♣r♦♣❡r❧②✳
■t ✇✐❧❧ ❜❡ ❡❛s✐❡r t♦ ✉s❡ ❛ ❉❈✴❉❈ ✺ V t♦ ✾ V ❝♦♥✈❡rt❡r✳ ■♥ t❤✐s ❝❛s❡✱ ✇❡ ❝♦✉❧❞ ❝❤♦♦s❡ ❜❡tt❡r ♦♣✲❛♠♣ ✭♥♦t r❛✐❧✲t♦✲r❛✐❧✱ s♦ ❝❤❡❛♣❡r✮ ❧✐❦❡ ◆❊✺✺✸✷✳ ❚❤❡r❡ ✐s ❛♥ ✐♠♣r♦✈❡❞ s❝❤❡♠❛t✐❝ ♦♥ ✜❣✉r❡ ✶✻ t♦ ❞r✐✈❡ ❛ ❘●❇ ❧❛s❡r✳ ❖♥ t❤✐s✱ ♦✉t♣✉ts ❛r❡ ❜❛❧❛♥❝❡❞ ❛♥❞ t❤❡r❡ ❛r❡ ❝❛♣❛❝✐t♦rs ✐♥ t❤❡ ❢❡❡❞❜❛❝❦ ❧♦♦♣ ♦❢ ♦♣✲❛♠♣✱ s♦ t❤❛t s♣♦♥t❛♥❡♦✉s ♦s❝✐❧❧❛t✐♦♥s ❛r❡ ❛✈♦✐❞❡❞✳ ❙♦♠❡ r❡s✐st♦rs ♦♥ t❤❡ ♦✉t♣✉t ♣r♦t❡❝t ♦♣✲❛♠♣ ❛❣❛✐♥st s❤♦rt ❝✐r❝✉✐t✳
❚❤❡ ❉❈✴❉❈ ❝♦♥✈❡rt❡r ❳P✲P❖❲❊❘ ■❍✵✺✵✾❙ ❤❛s ❛ ✇✐❞❡ r❛♥❣❡ ♦❢ ✐♥✲ ♣✉t ✈♦❧t❛❣❡ ✭❢r♦♠ 4, 5 V t♦ 9 V✮ ❛♥❞ ❛ ❞✉❛❧ r❡❣✉❧❛t❡❞ ♦✉t♣✉t✳ ❚❤✉s ■ ❝❛♥ ❝❤♦♦s❡ ♥♦♥✲r❛✐❧✲t♦✲r❛✐❧ ❛♥❞ t❤❡♥ ❝❤❡❛♣❡r ♦♣✲❛♠♣✳ ■ ❝❤♦♦s❡ ◆❊✺✺✸✷ ❢♦r ✐ts ❣♦♦❞ q✉❛❧✐t②✴♣r✐❝❡ r❛t✐♦ ❛♥❞ ✐ts ❣♦♦❞ ❛✉❞✐♦ ♣❡r❢♦r♠❛♥❝❡s✳ ❏✉♠♣❡rs ❏P✶ t♦ ❏P✻ ❛r❡ ♦♥✲❜♦❛r❞ ✇✐r❡s t♦ ❛✈♦✐❞ ❞♦✉❜❧❡ ❢❛❝❡ P❈❇✳ ❚❤❡ ❥✉♠♣❡rs ❝♦♥✲ ♥❡❝t✐♦♥s ❛r❡ ❞r❛✇♥ ✐♥ ②❡❧❧♦✇ ♦♥ t❤❡ ❝♦♠♣♦♥❡♥t ✐♠♣❧❡♠❛♥t❛t✐♦♥ s❝❤❡♠❛t✐❝ ✶✼ ♣❛❣❡ ✷✷✳
❚❤❡ ✜❣✉r❡ ✶✽ s❤♦✇s t❤❡ P❈❇ ❛♥❞ t❤❡ t❛❜❧❡ ✷ ✐s t❤❡ ❧✐st ♦❢ ❝♦♠♣♦♥❡♥ts✳

✷✵

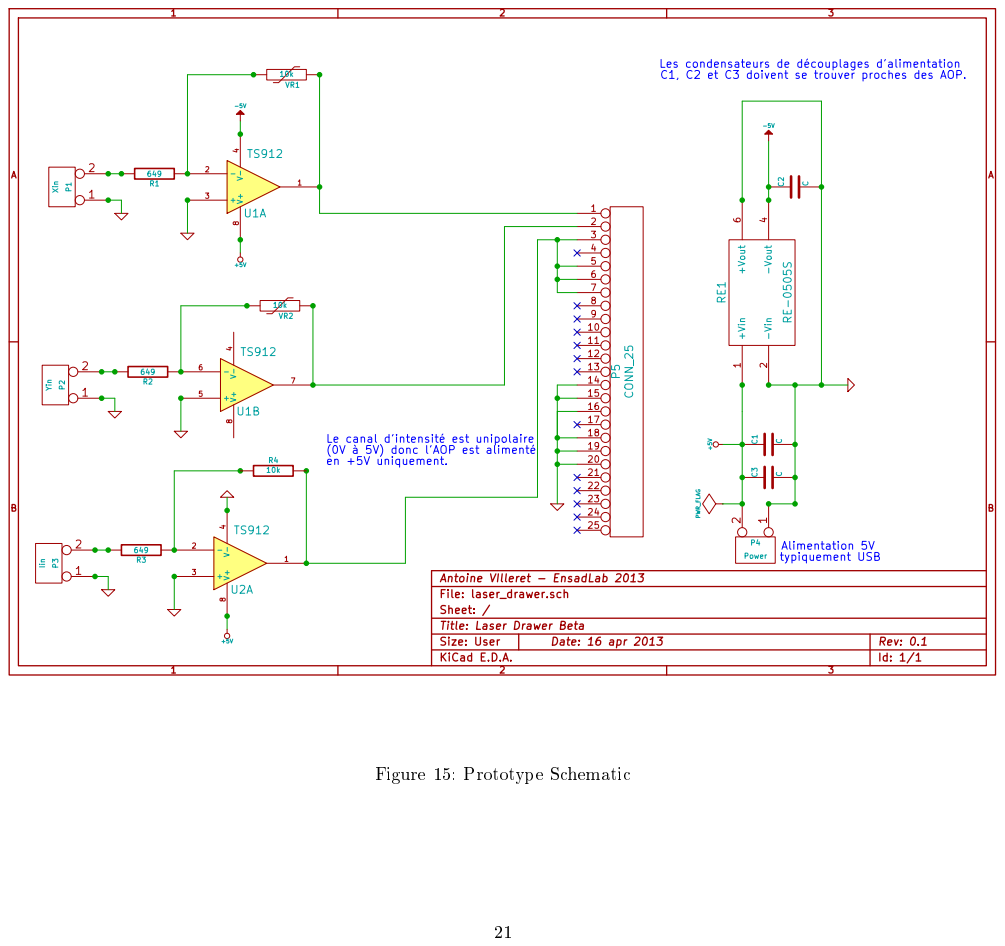
[picture p18: page 21]

Les condensateurs de découplages d'alimentation
C1, C2 et C3 doivent se trouver proches des AOP.

Le canal d'intensité est unipolaire
(0V à 5V) donc l'AOP est alimenté
en +5V uniquement.

Antoine VIlleret - EnsadLab 2013
File: laser_drawer.sch
Sheet: /
Title: Laser Drawer Beta
KiCad E.D.A.

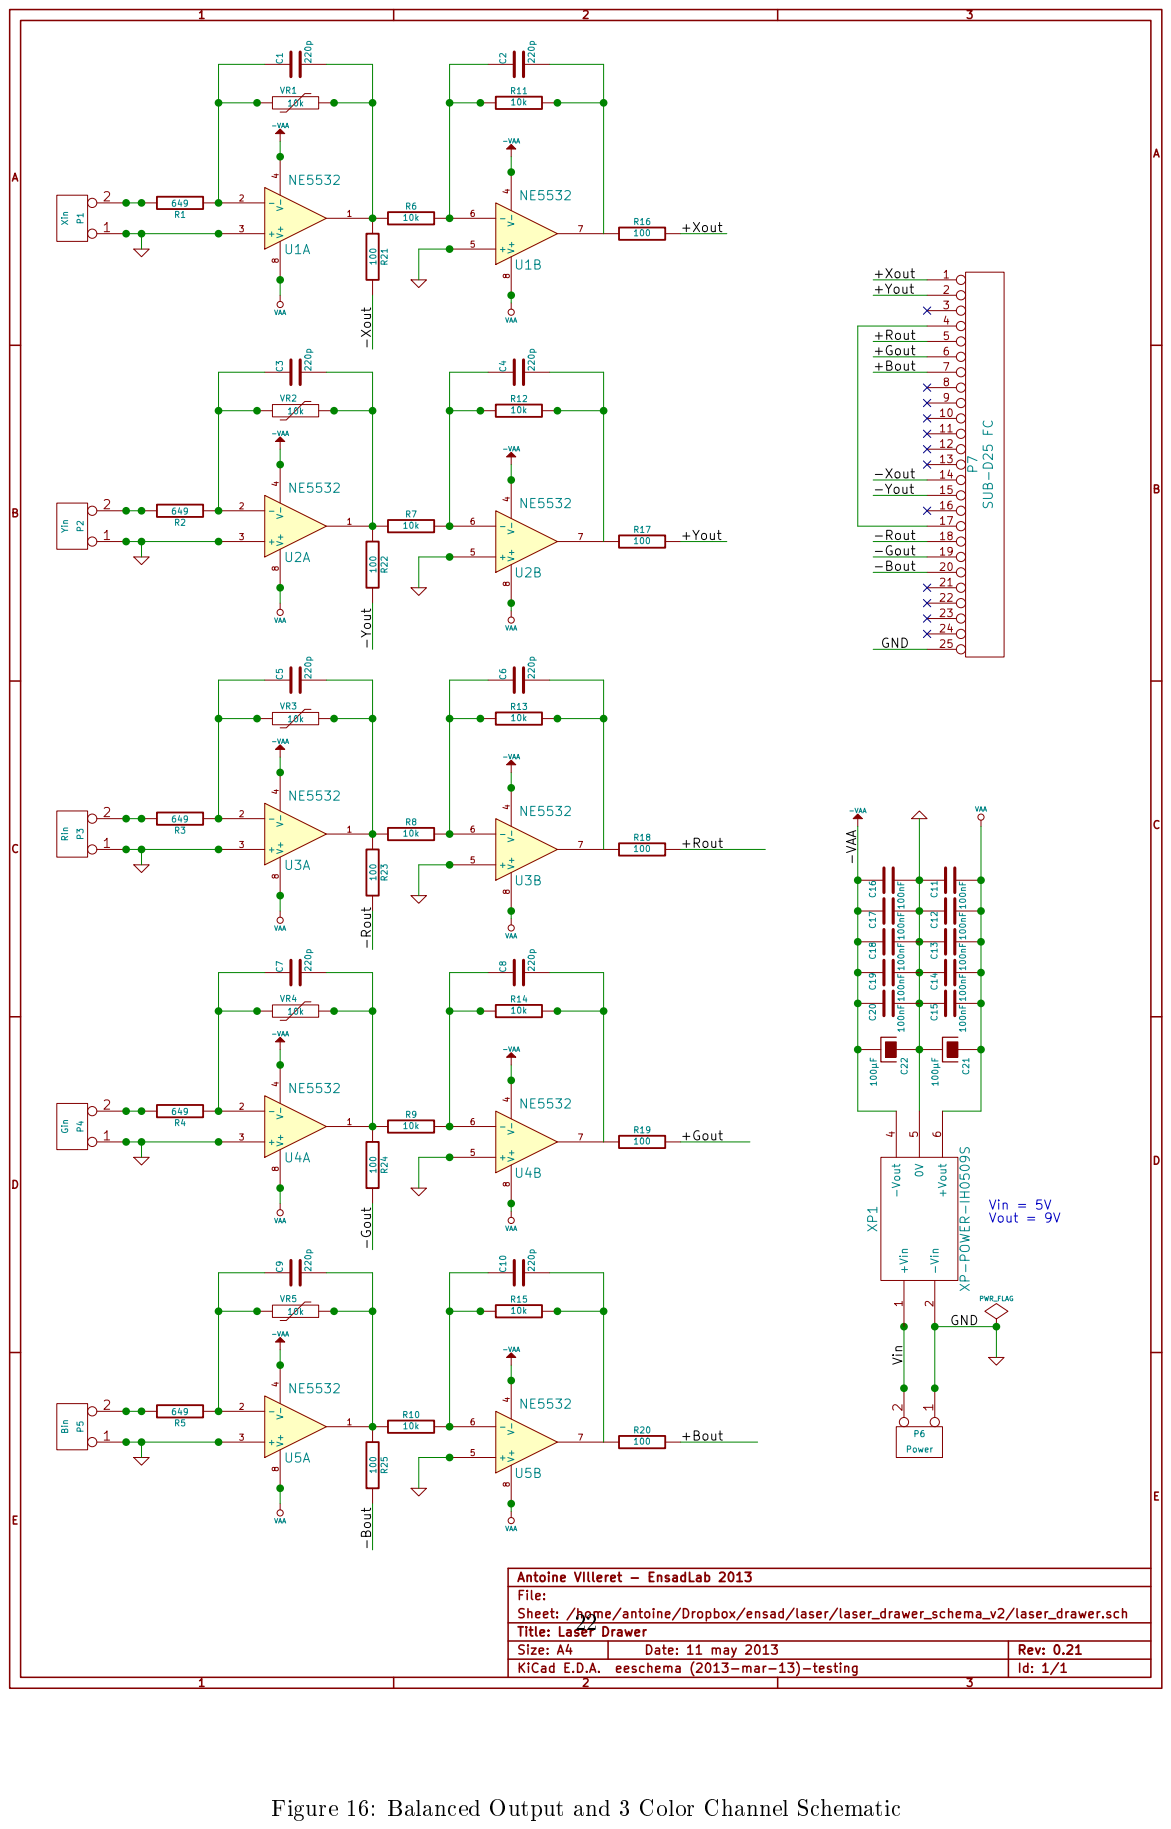
[picture p19: page 22]

Antoine VIlleret - EnsadLab 2013
File:
Sheet: /home/antoine/Dropbox/ensad/laser/laser_drawer_schema_v2/laser_drawer.sch

Title: Laser Drawer
KiCad E.D.A. eeschema (2013-mar-13)-testing

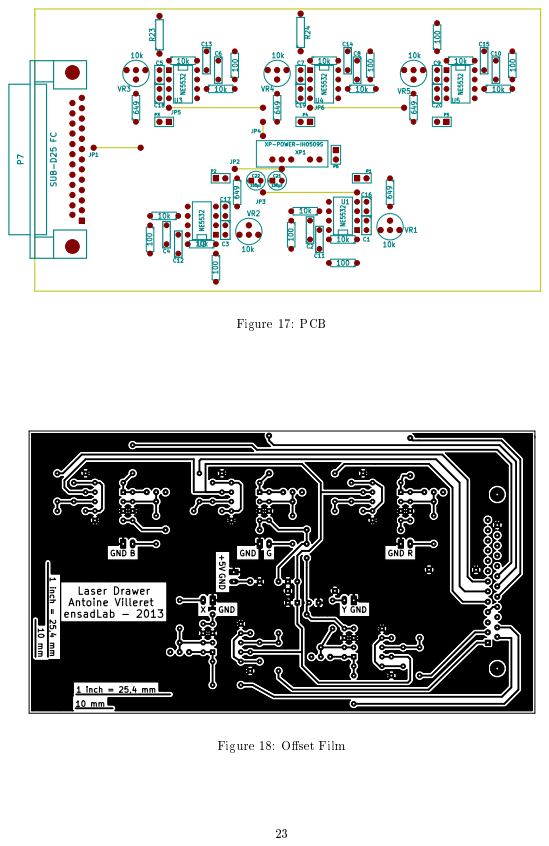
[picture p20: page 23]

❘❡❢✳ | ❱❛❧✉❡ | ◗✉❛♥t✐t② | ❘❡❢✳ ❋❛r♥❡❧❧
❈✶ à ❈✶✵ | 220 pF | ✶✵
❈✶✶ à ❈✷✵ | 100 nF | ✶✵
❈✷✶✱ ❈✷✷ | 100 µF | ✷
❏P✶ à ❏P✻ | ❏❯▼P❊❘ | ✻
P✶ à P✻ | ✷①✶ P■◆ ❍❊❆❉❊❘ | ✻ | ✾✼✸✶✶✹✽ (http://fr.farnell.com/jsp/search/productdetail.jsp?sku=9731148)
P✼ | ❙❯❇✲❉✷✺ ❋❈ | ✶ | ✶✵✾✾✷✾✻ (http://fr.farnell.com/jsp/search/productdetail.jsp?sku=1099296)
❘✶ à ❘✺ | 649 Ω | ✺
❘✻ à ❘✶✺ | 10 kΩ | ✶✵
❘✶✻ à ❘✷✺ | 100 Ω | ✶✵
❯✶ à ❯✺ | ◆❊✺✺✸✷ | ✺ | ✶✶✵✻✵✾✶ (http://fr.farnell.com/jsp/search/productdetail.jsp?sku=1106091)
❱❘✶ à ❱❘✺ | 10 kΩ tr✐♠❡r | ✺ | ✾✸✺✹✸✵✶ (http://fr.farnell.com/jsp/search/productdetail.jsp?sku=9354301)
❳P✶ | ❳P✲P❖❲❊❘ ■❍✵✺✵✾❙ | ✶ | ✽✼✷✼✽✽✵ (http://fr.farnell.com/jsp/search/productdetail.jsp?sku=8727880)

❚❛❜❧❡ ✷✿ ❇✐❧❧ ♦❢ ♠❛t❡r✐❛❧s

✷✹

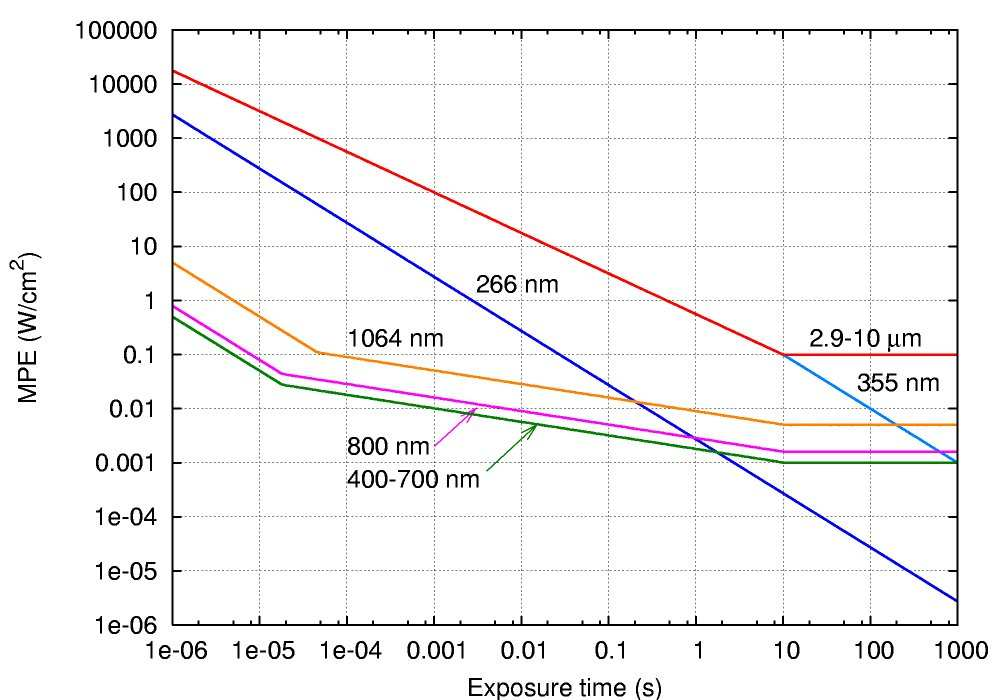
[picture p21: figure]

❋✐❣✉r❡ ✶✾✿ ▼P❊ ❢♦r s❡✈❡r❛❧ ✇❛✈❡❧❡♥❣❤t ✭s♦✉r❝❡ ✿ ❲✐❦✐♣❡❞✐❛✮

## ❆♣♣❡♥❞✐① ❇ ▲❡❣❛❧ ❛♥❞ s❡❝✉r✐t② ✐ss✉❡s ✇✐t❤ t❤❡ ❧❛s❡rs

▲❛s❡rs ❝♦✉❧❞ ❜❡ ❞❛♥❣❡r♦✉s✳ ❆ ❤✐❣❤ ❧❡✈❡❧ ♦❢ ❝♦❤❡r❡♥t ❧✐❣❤t ❝♦♥❝❡♥tr❛t❡❞ ♦♥ ❛ s♠❛❧❧ s✉r❢❛❝❡ ❤❡❛ts q✉✐❝❦❧②✳ ❚❤❛t ✐s ✇❤② ✇❡ ✉s❡ ❧❛s❡rs t♦ ❝✉t ♠❛t❡r✐❛❧s✳ ❇✉t t❤✐s ♣r♦♣❡rt② ✐s ❛❧s♦ ❞❛♥❣❡r♦✉s✱ ❜♦t❤ ❢♦r t❤✐♥❣s ❛♥❞ ♣❡♦♣❧❡✳ ❆ ✺W ❧❛s❡r ❝❛♥ ❜✉r♥ t❤❡ s❦✐♥ ♦r ❧✐❣❤t❡♥ ❛ ❝✐❣❛r❡tt❡✳
❚❤❡ ❧❛✇s ❞❡✜♥❡ s♦♠❡ r❡str✐❝t✐♦♥s t❤❛t ❝♦✉❧❞ ❜❡ ❞✐✣❝✉❧t t♦ ❢♦❧❧♦✇✳ ■ ✇✐❧❧ tr② t♦ ❝❧❛r✐❢② t❤♦s❡ ❛♥❞ t♦ r❡❧❛t✐✈✐s❡ ❛❝❝♦r❞✐♥❣ t♦ ✇❤❛t ✇❡ ❛r❡ ❞♦✐♥❣ ✇✐t❤ ❧❛s❡rs✳

❚❤❡ r✐s❦s

▲❛s❡rs ❝❛♥ ❜✉r♥ t❤❡ s❦✐♥ ❛♥❞ t❤❡ r❡t✐♥❛✳ ❘❡t✐♥❛✬s ✐♥❥✉r✐❡s ❛r❡ ✐rr❡✈♦❝❛❜❧❡✳ ▼❛♥ ❝❛♥ ❜❡❝♦♠❡ ❜❧✐♥❞ ❜② ❞✐r❡❝t❧② ❧♦♦❦✐♥❣ ✐♥t♦ ❛ ❧❛s❡r ❞✐♦❞❡✳ ❈❧❛ss ✹ ❧❛s❡rs ❝❛♥ ❡❛s✐❧② tr✐❣ ❛ ✜r❡✳
❚♦ ❜❡ s❛❢❡✱ t❤❡ ❡①♣♦s✉r❡ s❤♦✉❧❞♥✬t ❣♦ ❛❜♦✈❡ t❤❡ ▼❛①✐♠✉♠ P❡r♠✐s✲ s✐❜❧❡ ❊①♣♦s✉r❡ ✭▼P❊✮✳ ▼P❊ ✐s ❞❡✜♥❡❞ ❛s t❤❡ t❡♥t❤ ♦❢ t❤❡ ❞♦s❡ ✇❤✐❝❤ ❤❛s ❤❛❧❢ ❝❤❛♥❝❡ t♦ ♠❛❦❡ ❛♥ ✐rr❡✈♦❝❛❜❧❡ ✐♥❥✉r②✳ ❚❤✐s ✐s ♠❡❛s✉r❡❞ ♦♥ t❤❡ ❝♦r♥❡❛ ♦r ♦♥ t❤❡ s❦✐♥ ❢♦r ❛ ❣✐✈❡♥ ✇❛✈❡ ❧❡♥❣t❤ ❛♥❞ ❡①♣♦s✉r❡ t✐♠❡✳ ▼P❊ ✉s❡❞ t♦ ❜❡ ❡①♣r❡ss❡❞ ✐♥ W/cm² ♦✉ J/cm²
| ✳ ❋✐❣✉r❡ ✶✾ s❤♦✇s t❤❡ ❝♦♥t✐♥✲
✉♦✉s ❡①♣♦s✐t✐♦♥ ♦❢ ❝♦r♥❡❛ t♦ ✈✐s✐❜❧❡ ❧❛s❡r ✐s ❞❛♥❣❡r♦✉s ❛❜♦✈❡ ✶ mW✳ ▲❛s❡rs ❝♦✉❧❞ ❛❧s♦ ❜❡ ❞❛♥❣❡r❡♦✉s ❢♦r ❛✈✐❛t✐♦♥✳ ❊✈❡♥ ✐❢ t❤❡ ♣❧❛♥❡s ✢② ❤✐❣❤ ❡♥♦✉❣❤ t♦ ♥♦t ❜❡ ❞❛♠❛❣❡❞ ❜② ❛ ❧❛s❡r ❜❡❛♠✱ ♣✐❧♦t ❝♦✉❧❞ ❜❡ ❞❛③③❧❡❞✳

✷✺

❈❧❛ss ✶ | ❆ ❈❧❛ss ✶ ❧❛s❡r ✐s s❛❢❡ ✉♥❞❡r ❛❧❧ ❝♦♥❞✐t✐♦♥s ♦❢ ♥♦r♠❛❧ ✉s❡✳ ❚❤✐s ♠❡❛♥s t❤❡ ♠❛①✐♠✉♠ ♣❡r♠✐ss✐❜❧❡ ❡①♣♦s✉r❡ ✭▼P❊✮ ❝❛♥♥♦t ❜❡ ❡①❝❡❡❞❡❞ ✇❤❡♥ ✈✐❡✇✐♥❣ ❛ ❧❛s❡r ✇✐t❤ t❤❡ ♥❛❦❡❞ ❡②❡ ♦r ✇✐t❤ t❤❡ ❛✐❞ ♦❢ t②♣✐❝❛❧ ♠❛❣♥✐❢②✐♥❣ ♦♣t✐❝s ✭❡✳❣✳ t❡❧❡s❝♦♣❡ ♦r ♠✐❝r♦s❝♦♣❡✮✳ ❚♦ ✈❡r✐❢②
| ❝♦♠♣❧✐❛♥❝❡✱ t❤❡ st❛♥❞❛r❞ s♣❡❝✐✜❡s t❤❡ ❛♣❡rt✉r❡ ❛♥❞ ❞✐st❛♥❝❡ ❝♦rr❡s♣♦♥❞✐♥❣ t♦ t❤❡ ♥❛❦❡❞ ❡②❡✱ ❛ t②♣✐❝❛❧ t❡❧❡s❝♦♣❡ ✈✐❡✇✐♥❣ ❛ ❝♦❧❧✐♠❛t❡❞ ❜❡❛♠✱ ❛♥❞ ❛ t②♣✐❝❛❧ ♠✐❝r♦s❝♦♣❡ ✈✐❡✇✐♥❣ ❛ ❞✐✈❡r❣❡♥t ❜❡❛♠✳ ■t ✐s ✐♠♣♦rt❛♥t t♦ r❡❛❧✐③❡ t❤❛t ❝❡rt❛✐♥ ❧❛s❡rs ❝❧❛ss✐✜❡❞ ❛s ❈❧❛ss ✶ ♠❛② st✐❧❧ ♣♦s❡ ❛ ❤❛③❛r❞ ✇❤❡♥ ✈✐❡✇❡❞ ✇✐t❤ ❛ t❡❧❡s❝♦♣❡ ♦r ♠✐❝r♦s❝♦♣❡ ♦❢ s✉✣❝✐❡♥t❧② ❧❛r❣❡ ❛♣❡rt✉r❡✳ ❋♦r ❡①❛♠♣❧❡✱ ❛ ❤✐❣❤✲♣♦✇❡r ❧❛s❡r ✇✐t❤ ❛ ✈❡r② ❧❛r❣❡ ❝♦❧❧✐♠❛t❡❞ ❜❡❛♠ ♦r ✈❡r② ❤✐❣❤❧② ❞✐✈❡r❣❡♥t ❜❡❛♠ ♠❛② ❜❡ ❝❧❛ss✐✜❡❞ ❛s ❈❧❛ss ✶ ✐❢ t❤❡ ♣♦✇❡r t❤❛t ♣❛ss❡s t❤r♦✉❣❤ t❤❡ ❛♣❡rt✉r❡s ❞❡✜♥❡❞ ✐♥ t❤❡ st❛♥❞❛r❞ ✐s ❧❡ss t❤❛♥ t❤❡ ❆❊▲ ❢♦r ❈❧❛ss ✶❀ ❤♦✇❡✈❡r✱ ❛♥ ✉♥s❛❢❡ ♣♦✇❡r ❧❡✈❡❧ ♠❛② ❜❡ ❝♦❧❧❡❝t❡❞ ❜② ❛ ♠❛❣♥✐❢②✐♥❣ ♦♣t✐❝ ✇✐t❤ ❧❛r❣❡r ❛♣❡rt✉r❡✳
❈❧❛ss ✶▼ | ❆ ❈❧❛ss ✶▼ ❧❛s❡r ✐s s❛❢❡ ❢♦r ❛❧❧ ❝♦♥❞✐t✐♦♥s ♦❢ ✉s❡ ❡①❝❡♣t ✇❤❡♥ ♣❛ss❡❞ t❤r♦✉❣❤ ♠❛❣♥✐❢②✐♥❣ ♦♣t✐❝s s✉❝❤ ❛s ♠✐❝r♦s❝♦♣❡s ❛♥❞ t❡❧❡s❝♦♣❡s✳ ❈❧❛ss ✶▼ ❧❛s❡rs ♣r♦❞✉❝❡ ❧❛r❣❡✲❞✐❛♠❡t❡r ❜❡❛♠s✱ ♦r ❜❡❛♠s t❤❛t ❛r❡ ❞✐✈❡r❣❡♥t✳ ❚❤❡ ▼P❊ ❢♦r ❛ ❈❧❛ss ✶▼ ❧❛s❡r ❝❛♥♥♦t ♥♦r♠❛❧❧② ❜❡ ❡①❝❡❡❞❡❞ ✉♥❧❡ss ❢♦❝✉s✐♥❣ ♦r ✐♠❛❣✐♥❣ ♦♣t✐❝s ❛r❡ ✉s❡❞ t♦ ♥❛rr♦✇ t❤❡ ❜❡❛♠✳ ■❢ t❤❡ ❜❡❛♠ ✐s r❡❢♦❝✉s❡❞✱ t❤❡ ❤❛③❛r❞ ♦❢ ❈❧❛ss ✶▼ ❧❛s❡rs ♠❛② ❜❡ ✐♥❝r❡❛s❡❞ ❛♥❞ t❤❡ ♣r♦❞✉❝t ❝❧❛ss ♠❛② ❜❡ ❝❤❛♥❣❡❞✳ ❆ ❧❛s❡r ❝❛♥ ❜❡ ❝❧❛ss✐✜❡❞ ❛s ❈❧❛ss ✶▼ ✐❢ t❤❡ ♣♦✇❡r t❤❛t ❝❛♥ ♣❛ss t❤r♦✉❣❤ t❤❡ ♣✉♣✐❧ ♦❢ t❤❡ ♥❛❦❡❞ ❡②❡ ✐s ❧❡ss t❤❛♥ t❤❡ ❆❊▲ ❢♦r ❈❧❛ss ✶✱ ❜✉t t❤❡ ♣♦✇❡r t❤❛t ❝❛♥ ❜❡ ❝♦❧❧❡❝t❡❞ ✐♥t♦ t❤❡ ❡②❡ ❜② t②♣✐❝❛❧ ♠❛❣♥✐❢②✐♥❣ ♦♣t✐❝s ✭❛s ❞❡✜♥❡❞ ✐♥ t❤❡ st❛♥❞❛r❞✮ ✐s ❤✐❣❤❡r t❤❛♥ t❤❡ ❆❊▲ ❢♦r
| ❈❧❛ss ✶ ❛♥❞ ❧♦✇❡r t❤❛♥ t❤❡ ❆❊▲ ❢♦r ❈❧❛ss ✸❇✳
❈❧❛ss ✷ | ❆ ❈❧❛ss ✷ ❧❛s❡r ✐s s❛❢❡ ❜❡❝❛✉s❡ t❤❡ ❜❧✐♥❦ r❡✢❡① ✇✐❧❧ ❧✐♠✐t t❤❡ ❡①♣♦s✉r❡ t♦ ♥♦ ♠♦r❡ t❤❛♥ ✵✳✷✺ s❡❝♦♥❞s✳ ■t ♦♥❧② ❛♣♣❧✐❡s t♦ ✈✐s✐❜❧❡✲❧✐❣❤t ❧❛s❡rs ✭✹✵✵✕✼✵✵ ♥♠✮✳ ❈❧❛ss✲✷ ❧❛s❡rs ❛r❡ ❧✐♠✐t❡❞ t♦ ✶ ♠❲ ❝♦♥t✐♥✉♦✉s ✇❛✈❡✱ ♦r ♠♦r❡ ✐❢ t❤❡ ❡♠✐ss✐♦♥ t✐♠❡ ✐s ❧❡ss t❤❛♥ ✵✳✷✺ s❡❝♦♥❞s ♦r ✐❢ t❤❡ ❧✐❣❤t ✐s ♥♦t s♣❛t✐❛❧❧② ❝♦❤❡r❡♥t✳ ■♥t❡♥t✐♦♥❛❧ s✉♣♣r❡ss✐♦♥ ♦❢ t❤❡ ❜❧✐♥❦ r❡✢❡① ❝♦✉❧❞ ❧❡❛❞ t♦ ❡②❡ ✐♥❥✉r②✳ ▼❛♥② ❧❛s❡r ♣♦✐♥t❡rs ❛♥❞ ♠❡❛s✉r✐♥❣ ✐♥str✉♠❡♥ts ❛r❡ ❝❧❛ss ✷✳
❈❧❛ss ✷▼ | ❆ ❈❧❛ss ✷▼ ❧❛s❡r ✐s s❛❢❡ ❜❡❝❛✉s❡ ♦❢ t❤❡ ❜❧✐♥❦ r❡✢❡① ✐❢ ♥♦t ✈✐❡✇❡❞ t❤r♦✉❣❤ ♦♣t✐❝❛❧ ✐♥✲ str✉♠❡♥ts✳ ❆s ✇✐t❤ ❝❧❛ss ✶▼✱ t❤✐s ❛♣♣❧✐❡s t♦ ❧❛s❡r ❜❡❛♠s ✇✐t❤ ❛ ❧❛r❣❡ ❞✐❛♠❡t❡r ♦r ❧❛r❣❡ ❞✐✈❡r❣❡♥❝❡✱ ❢♦r ✇❤✐❝❤ t❤❡ ❛♠♦✉♥t ♦❢ ❧✐❣❤t ♣❛ss✐♥❣ t❤r♦✉❣❤ t❤❡ ♣✉♣✐❧ ❝❛♥♥♦t ❡①❝❡❡❞ t❤❡ ❧✐♠✐ts ❢♦r ❝❧❛ss ✷✳
❈❧❛ss ✸❘ | ❆ ❈❧❛ss ✸❘ ❧❛s❡r ✐s ❝♦♥s✐❞❡r❡❞ s❛❢❡ ✐❢ ❤❛♥❞❧❡❞ ❝❛r❡❢✉❧❧②✱ ✇✐t❤ r❡str✐❝t❡❞ ❜❡❛♠ ✈✐❡✇✐♥❣✳ ❲✐t❤ ❛ ❝❧❛ss ✸❘ ❧❛s❡r✱ t❤❡ ▼P❊ ❝❛♥ ❜❡ ❡①❝❡❡❞❡❞✱ ❜✉t ✇✐t❤ ❛ ❧♦✇ r✐s❦ ♦❢ ✐♥❥✉r②✳ ❱✐s✐❜❧❡ ❝♦♥t✐♥✉♦✉s ❧❛s❡rs ✐♥ ❈❧❛ss ✸❘ ❛r❡ ❧✐♠✐t❡❞ t♦ ✺ ♠❲✳ ❋♦r ♦t❤❡r ✇❛✈❡❧❡♥❣t❤s ❛♥❞ ❢♦r ♣✉❧s❡❞ ❧❛s❡rs✱ ♦t❤❡r ❧✐♠✐ts ❛♣♣❧②
❈❧❛ss ✸❇ | ❆ ❈❧❛ss ✸❇ ❧❛s❡r ✐s ❤❛③❛r❞♦✉s ✐❢ t❤❡ ❡②❡ ✐s ❡①♣♦s❡❞ ❞✐r❡❝t❧②✱ ❜✉t ❞✐✛✉s❡ r❡✢❡❝t✐♦♥s s✉❝❤ ❛s t❤♦s❡ ❢r♦♠ ♣❛♣❡r ♦r ♦t❤❡r ♠❛tt❡ s✉r❢❛❝❡s ❛r❡ ♥♦t ❤❛r♠❢✉❧✳ ❚❤❡ ❆❊▲ ❢♦r ❝♦♥t✐♥✉♦✉s ❧❛s❡rs ✐♥ t❤❡ ✇❛✈❡❧❡♥❣t❤ r❛♥❣❡ ❢r♦♠ ✸✶✺ ♥♠ t♦ ❢❛r ✐♥❢r❛r❡❞ ✐s ✵✳✺ ❲✳ ❋♦r ♣✉❧s❡❞ ❧❛s❡rs ❜❡t✇❡❡♥ ✹✵✵ ❛♥❞ ✼✵✵ ♥♠✱ t❤❡ ❧✐♠✐t ✐s ✸✵ ♠❏✳ ❖t❤❡r ❧✐♠✐ts ❛♣♣❧② t♦ ♦t❤❡r ✇❛✈❡❧❡♥❣t❤s ❛♥❞ t♦ ✉❧tr❛s❤♦rt ♣✉❧s❡❞ ❧❛s❡rs✳ Pr♦t❡❝t✐✈❡ ❡②❡✇❡❛r ✐s t②♣✐❝❛❧❧② r❡q✉✐r❡❞ ✇❤❡r❡ ❞✐r❡❝t ✈✐❡✇✐♥❣ ♦❢ ❛ ❝❧❛ss ✸❇ ❧❛s❡r ❜❡❛♠ ♠❛② ♦❝❝✉r✳ ❈❧❛ss✲✸❇ ❧❛s❡rs ♠✉st ❜❡ ❡q✉✐♣♣❡❞ ✇✐t❤ ❛ ❦❡② s✇✐t❝❤ ❛♥❞ ❛ s❛❢❡t② ✐♥t❡r❧♦❝❦✳ ❈❧❛ss ✸❇ ❧❛s❡rs ❛r❡ ✉s❡❞ ✐♥s✐❞❡ ❈❉ ❛♥❞ ❉❱❉ ✇r✐t❡rs✱ ❛❧t❤♦✉❣❤ t❤❡ ✇r✐t❡r ✉♥✐t ✐ts❡❧❢ ✐s ❝❧❛ss ✶ ❜❡❝❛✉s❡ t❤❡ ❧❛s❡r ❧✐❣❤t ❝❛♥♥♦t ❧❡❛✈❡ t❤❡ ✉♥✐t✳
❈❧❛ss ✹ | ❈❧❛ss ✹ ✐s t❤❡ ❤✐❣❤❡st ❛♥❞ ♠♦st ❞❛♥❣❡r♦✉s ❝❧❛ss ♦❢ ❧❛s❡r✱ ✐♥❝❧✉❞✐♥❣ ❛❧❧ ❧❛s❡rs t❤❛t ❡①❝❡❡❞ t❤❡ ❈❧❛ss ✸❇ ❆❊▲✳ ❇② ❞❡✜♥✐t✐♦♥✱ ❛ ❝❧❛ss ✹ ❧❛s❡r ❝❛♥ ❜✉r♥ t❤❡ s❦✐♥✱ ♦r ❝❛✉s❡ ❞❡✈❛st❛t✐♥❣ ❛♥❞ ♣❡r♠❛♥❡♥t ❡②❡ ❞❛♠❛❣❡ ❛s ❛ r❡s✉❧t ♦❢ ❞✐r❡❝t✱ ❞✐✛✉s❡ ♦r ✐♥❞✐r❡❝t ❜❡❛♠ ✈✐❡✇✐♥❣✳ ❚❤❡s❡ ❧❛s❡rs ♠❛② ✐❣♥✐t❡ ❝♦♠❜✉st✐❜❧❡ ♠❛t❡r✐❛❧s✱ ❛♥❞ t❤✉s ♠❛② r❡♣r❡s❡♥t ❛ ✜r❡ r✐s❦✳ ❚❤❡s❡ ❤❛③❛r❞s ♠❛② ❛❧s♦ ❛♣♣❧② t♦ ✐♥❞✐r❡❝t ♦r ♥♦♥✲s♣❡❝✉❧❛r r❡✢❡❝t✐♦♥s ♦❢ t❤❡ ❜❡❛♠✱ ❡✈❡♥ ❢r♦♠ ❛♣♣❛r❡♥t❧② ♠❛tt❡ s✉r❢❛❝❡s✖♠❡❛♥✐♥❣ t❤❛t ❣r❡❛t ❝❛r❡ ♠✉st ❜❡ t❛❦❡♥ t♦ ❝♦♥tr♦❧ t❤❡ ❜❡❛♠ ♣❛t❤✳ ■♥ ♠♦st st❛t❡s ✐t ✐s ✐❧❧❡❣❛❧ t♦ s❡❧❧ ♣r❡❛ss❡♠❜❧❡❞ ❝❧❛ss ✹ ❧❛s❡rs✱ ❤♦✇❡✈❡r ❛ ❝✐t✐③❡♥ ❝❛♥ ❝♦♥str✉❝t ❛ ❝❧❛ss ✹ ❧❛s❡r ❢♦r ♣❡rs♦♥❛❧ ✉s❡✳ ❈❧❛ss ✹ ❧❛s❡rs ♠✉st ❜❡ ❡q✉✐♣♣❡❞ ✇✐t❤ ❛ ❦❡② s✇✐t❝❤ ❛♥❞ ❛ s❛❢❡t② ✐♥t❡r❧♦❝❦✳ ▼♦st ✐♥❞✉str✐❛❧✱ s❝✐❡♥t✐✜❝✱ ♠✐❧✐t❛r②✱ ❛♥❞ ♠❡❞✐❝❛❧ ❧❛s❡rs ❛r❡ ✐♥ t❤✐s ❝❛t❡❣♦r②✳
| ❚❛❜❧❡ ✸✿ ▲❛s❡r ❝❧❛ss✐✜❝❛t✐♦♥ ✭s♦✉r❝❡ ✿ ❲✐❦✐♣❡❞✐❛✮ ✷✻

❚❤❡ ❧❛✇

▲❛s❡rs ❛r❡ ❝❧❛ss✐✜❡❞ ❛❝❝♦r❞✐♥❣ t♦ t❤❡✐r ❞❛♥❣❡r♦✉s✐t② ✭s❡❡ t❛❜❧❡ ✸✮✳ ❚❤❡ ✜rst ❝❧❛ss✐✜❝❛t✐♦♥ ✐♥ r♦♠❛♥ ♥✉♠❜❡rs t❛❦❡s ♦♥❧② t❤❡ ❞✐♦❞❡ ♣♦✇❡r ✐♥t♦ ❛❝❝♦✉♥t✳ ❚❤❡ ✷✵✵✼ r❡✈✐s✐♦♥ t❛❦❡s ❛❧s♦ t❤❡ ✇❛✈❡❧❡♥❣t❤ ❛♥❞ t❤❡ ❞✐✈❡r❣❡♥❝❡ ✐♥t♦ ❛❝❝♦✉♥t✳
▲❛s❡r ❢r♦♠ ❝❧❛ss ✸ ❛♥❞ ❛❜♦✈❡ ❝♦✉❧❞ ♦♥❧② ❜❡ ✉s❡❞ ♦✉t❞♦♦r✳ ❖♥❧② ❛ q✉❛❧✐✜❡❞ t❡❝❤♥✐❝✐❛♥ ❝♦✉❧❞ ♠❛♥✐♣✉❧❛t❡ t❤❡ ❧❛s❡r✱ ❜✉t ■ ❝❛♥✬t ✜♥❞ ❛♥② ❝♦♠♣❛❣♥② ✐♥ ❋r❛♥❝❡ t❤❛t ❞❡❧✐✈❡rs ❛♥ ❛❣r❡❡♠❡♥t ❢♦r ❛♥✐♠❛t✐♦♥ ❧❛s❡rs✳ P❡♦♣❧❡ ❤❛✈❡ t♦ ❧❡❛r♥ ❧❛s❡r s❛❢❡t② t❤❡♠s❡❧✈❡s ❛♥❞ t❛❦❡ t❤❡✐r r❡s♣♦♥s❛❜✐❧✐t②✳ ❉✉❡ t♦ t❤✐s ❞❛♥❣❡r❡♦✉s✐t②✱ ❧❛s❡r ♠✉st ❤❛✈❡ ❛ s❡❝✉r✐t② s②st❡♠ t♦ ❝✉t t❤❡ ❜❡❛♠ ✐❢ ❛ ❢❛✐❧✉r❡ ♦❝❝✉rs✳ ❖♥ s♦♠❡ ♥❡✇ ❧❛s❡rs✱ t❤❡ ❞✐♦❞❡ ✐s s✇✐t❝❤❡❞ ♦✛ ✐❢ t❤❡ s❝❛♥♥✐♥❣ ❛r❡❛ ✐s ♥♦t ✇✐❞❡ ❡♥♦✉❣❤✳ ❚❤❡ ❜✐❣❣❡r t❤❡ s❝❛♥♥✐♥❣ ❛r❡❛ ✐s✱ t❤❡ ❧❡ss t❤❡ ❜❡❛♠ st❛② ♦♥ t❤❡ s❛♠❡ ♣❧❛❝❡✱ s♦ t❤❡ ❧❡ss ✐t ✐s ❞❛♥❣❡r♦✉s✳ ❇✉t ✇✐t❤ s✉❝❤ ❛ s②st❡♠ ✇❡ ❝❛♥✬t ❞r❛✇ ❛r❜✐tr❛r② ♣❛tt❡r♥s ✇✐t❤ ❧❛s❡r ❡✈❡♥ ✐❢ ✇❡ t❛❦❡ ❝♦♠♣❡♥s❛t♦r② ❛rr❛♥❣❡♠❡♥t ❧✐❦❡ ❝♦♥str❛✐♥✐♥❣ ❜❡❛♠ ♦r ❛ ✜r❡♣r♦♦❢❡❞ ♣r♦❥❡❝t✐♦♥ s❝r❡❡♥✳

■♥ ♣r❛❝t✐❝❡

■♥ ♣r❛❝t✐❝❡✱ t❤❡ ❧❛✇s ❛r❡ ✈❡r② r❡str✐❝t✐✈❡ ❛♥❞ ♠♦r❡♦✈❡r t❤❡② ❝❛♥ ❛❢r❛✐❞ t❡❝❤♥✐❝❛❧ ❞✐r❡❝t♦r ✐❢ t❤❡② ❛r❡ ♥♦t ❡①♣❧❛✐♥❡❞ ♣r♦♣❡r❧②✳ ❆s s♦♦♥ ❛s ✇❡ ✉s❡ ❛ ❈❧❛ss ✸ ♦r ❛❜♦✈❡ ❧❛s❡r✱ ❛✉❞✐❡♥❝❡ s❝❛♥♥✐♥❣ s❤♦✉❧❞ ❜❡ ❛✈♦✐❞❡❞✳ ■❢ ✐t ✐s r❡❛❧❧② ♥❡❡❞❡❞ t♦ s❝❛♥ ❛♥ ❛r❡❛ ❛❝❝❡ss✐❜❧❡ t♦ ♣❡♦♣❧❡✱ ✇❡ ♠✉st t❛❦❡ s♦♠❡ s♣❡❝✐❛❧ ♠❡❛s✉r❡s t♦ ❜❡ s✉r❡ t❤❛t t❤❡ ❛✉❞✐❡♥❝❡ ❡①♣♦s✉r❡ ✐s ❜❡❧♦✇ t❤❡ ▼P❊✳ ❘♦❜❡rt ❍❡♥❦❡ ✉s❡s ❝❧❛ss ✹ ❧❛s❡r ✐♥❞♦♦r ❢♦r ❋r❛❣✐❧❡s ❚❡rr✐t♦✐r❡s✳ ❍❡ ❤❛❞ t♦ s❡t✉♣ ❛♥ ■❘ ❜❛rr✐❡r t♦ ❝✉t ♦❢ ❛❧❧ ❧❛s❡rs ✐❢ s♦♠❡♦♥❡ ❡♥t❡rs ✐♥ t❤❡ ❢♦r❜✐❞❞❡♥ ❛r❡❛✳ ❚❤✉s ♥♦❜♦❞② ❝❛♥ ❜❡ r❡❛❝❤❡❞ ❜② t❤❡ ❧❛s❡r ❜❡❛♠✳ ❍❡ ❤❛❞ t♦ ❣♦ t❤r♦✉❣❤ ❛ ❧♦t ♦❢ ❞✐s❝✉ss✐♦♥s ❜❡❢♦r❡ t❤✐s ✇❛s ❛♣♣r♦✈❡❞✳
❋♦r ❙✐❣♥ ❜② ❙❛♠✉❡❧ ❇✐❛♥❝❤✐♥✐✱ t❤❡ ❧❛s❡r ✐s ❝♦♥str❛✐♥❡❞ ✐♥t♦ ❛ s♠❛❧❧ ❜❧❛❝❦ ♠❡t❛❧ ✇✐♥❞♦✇✳ ❚❤r♦✉❣❤ t❤✐s ✇✐♥❞♦✇ t❤❡ ❧❛s❡r ❜❡❛♠ ❝❛♥ ♦♥❧② r❡❛❝❤ ✐ts t❛r❣❡t ✿ ❛ ❢r♦♥t ♦❢ ❛ ❜✉✐❧❞✐♥❣ ✷✺✵ m ❢❛r✳ ■❢ ✐♥ ❛♥② ❝❛s❡ t❤❡ ❜❡❛♠ ❧❡❛✈❡ t❤❡ ✇✐♥❞♦✇✱ t❤❡ s✉rr♦✉♥❞✐♥❣ ♠❡t❛❧ ❛❜s♦r❜s ✐t✳
❈♦♥❝❡r♥✐♥❣ ❘♦❜✐♥ ❋♦①✱ ❤❡ ♣❧❛❝❡s t❤❡ ❧❛s❡r ♣r♦❥❡❝t♦r ✐♥ ❢r♦♥t ♦❢ t❤❡ ❛✉✲ ❞✐❡♥❝❡ s♦ t❤❛t t❤❡ ❜❡❛♠ ❝❛♥ r❡❛❝❤ ♦✉r ❡②❡s ❡❛s✐❧②✳ ❍❡ s❡❡♠s t♦ ❜❡ ❛✇❛r❡ ♦❢ t❤❡ ❧❛s❡r✬s ❤❛③❛r❞s ❜✉t ❞♦❡s♥✬t ❦♥♦✇ ❤✐s ❧❛s❡r ✐s ❢♦r❜✐❞❞❡♥ ✐♥❞♦♦r✱ ✐♥ ❋r❛♥❝❡ ❛t ❧❡❛st✳

## ❆♣♣❡♥❞✐① ❈ ■♠❛❣❡ ❝r❡❞✐t

P✐❝t✉r❡ ✾ ✐s r❡♣r♦❞✉❝❡❞ ✇✐t❤ ❝♦✉rt❡s② ♦❢ ▼❛rs❤♠❛❧❧♦✇ ▲❛s❡r ❋❡❛st✳ P✐❝t✉r❡ ✻ ✐s r❡♣r♦❞✉❝❡❞ ✇✐t❤ ❝♦✉rt❡s② ♦❢ ❲❤✐t❡ ❱♦✐❞✳
P✐❝t✉r❡ ✹ ✐s r❡♣r♦❞✉❝❡❞ ✇✐t❤ ❝♦✉rt❡s② ♦❢ ❘♦❜❡rt ❍❡♥❦❡ ❤✐♠s❡❧❢✳ P✐❝t✉r❡s ✺ ❛♥❞ ✷ ❛r❡ ♠✐♥❡✳

✷✼

❖t❤❡r ♣✐❝t✉r❡s ❛r❡ r❡♣r♦❞✉❝❡❞ ✇✐t❤♦✉t ❝♦✉rt❡s② ❜❡❝❛✉s❡ ■ r❡❝❡✐✈❡❞ ♥♦ ❛♥s✇❡r ❢r♦♠ t❤❡✐r ♦✇♥❡rs✳ ❊✈❡♥t❤♦✉❣❤ ■ ❞❡❝✐❞❡❞ t♦ r❡♣r♦❞✉❝❡ t❤❡♠ t♦ ✐❧❧✉str❛t❡ t❤✐s r❡♣♦rt✳ ■ ✇✐❧❧ r❡♠♦✈❡ t❤❡♠ ✐❢ ❛✉t❤♦r ❝❧❛✐♠s✳

✷✽
