avilleret/laser_drawer/doc/laser_drawer-web.pdf

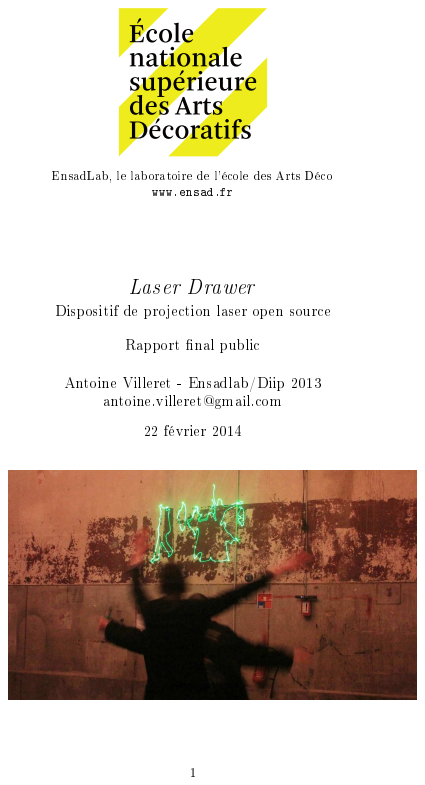
[picture p22: page 1]
❊♥s❛❞▲❛❜✱ ❧❡ ❧❛❜♦r❛t♦✐r❡ ❞❡ ❧✬é❝♦❧❡ ❞❡s ❆rts ❉é❝♦ ✇✇✇✳❡♥s❛❞✳❢r

## ❚❛❜❧❡ ❞❡s ♠❛t✐èr❡s

✶ ➱t❛t ❞❡ ❧✬❛rt ❡t ❞❡s t❡❝❤♥✐q✉❡s | ✷
✶✳✶ ❙é❧❡❝t✐♦♥ ❞❡ ♣r♦❥❡ts ❛rt✐st✐q✉❡s ✳ ✳ ✳ ✳ ✳ ✳ ✳ ✳ ✳ ✳ ✳ ✳ ✳ ✳ ✳ | ✸
✶✳✶✳✶ | ❇❡r♥❛r❞ ❙③❛❥♥❡r ✕ ❙②♥r✐♥❣✉❡ ✭❤❛r♣❡ ❧❛s❡r✮ ✕ ✶✾✽✵ ✳ | ✸
✶✳✶✳✷ | ❆❧✈❛r♦ ❈❛ss✐♥❡❧❧✐ ✕ ❙❝♦r❡ ▲✐❣❤t ✕ ✷✵✵✽ ✳ ✳ ✳ ✳ ✳ ✳ ✳ | ✸
✶✳✶✳✸ | ❘♦❜✐♥ ❋♦① ✕ ▲❛s❡r ❙❤♦✇ ✳ ✳ ✳ ✳ ✳ ✳ ✳ ✳ ✳ ✳ ✳ ✳ ✳ ✳ ✳ | ✹
✶✳✶✳✹ | ❯❱❆ ✕ ❙♣❡❡❞ ♦❢ ❧✐❣❤t ✕ ✷✵✶✵ ✳ ✳ ✳ ✳ ✳ ✳ ✳ ✳ ✳ ✳ ✳ ✳ ✳ | ✹
✶✳✶✳✺ | ❘♦❜❡rt ❍❡♥❦❡ ✕ ❋r❛❣✐❧❡s ❚❡rr✐t♦✐r❡s ✕ ✷✵✶✷ ✳ ✳ ✳ ✳ | ✺
✶✳✶✳✻ | ❙❛♠✉❡❧ ❇✐❛♥❝❤✐♥✐ ✕ ❊♥s❡✐❣♥❡ ✕ ✷✵✶✷ ✳ ✳ ✳ ✳ ✳ ✳ ✳ ✳ | ✺
✶✳✶✳✼ | ❍②✉♥❞❛✐ ❛♥❞ ❲❤✐t❡❱♦✐❞ ✕ ❋❧✉✐❞✐❝ ✲ ❙❝✉❧♣t✉r❡ ✐♥
| ♠♦t✐♦♥ ✕ ✷✵✶✸ ✳ ✳ ✳ ✳ ✳ ✳ ✳ ✳ ✳ ✳ ✳ ✳ ✳ ✳ ✳ ✳ ✳ ✳ ✳ ✳ | ✺
✶✳✶✳✽ | ❉❛✐t♦ ▼❛♥❛❜❡ ✕ ❯❱ ❧❛s❡r ❢❛❞❡ ♦✉t ✕ ✷✵✶✵ ✳ ✳ ✳ ✳ ✳ | ✺
✶✳✶✳✾ | ❆♥t♦✐♥❡ ❱✐❧❧❡r❡t ✕ ❙✐❧❤♦✉❡tt❡ ✕ ✷✵✶✸ ✳ ✳ ✳ ✳ ✳ ✳ ✳ ✳ | ✺
✶✳✶✳✶✵ ▼❛rs❤♠❛❧❧♦✇ ▲❛s❡r ❋❡❛st ✕ ▲❛s❡r ❋♦r❡st ✕ ✷✵✶✸ ✳ ✳ | ✻
✶✳✷ ➱t❛t ❞❡s t❡❝❤♥✐q✉❡s ✳ ✳ ✳ ✳ ✳ ✳ ✳ ✳ ✳ ✳ ✳ ✳ ✳ ✳ ✳ ✳ ✳ ✳ ✳ ✳ ✳ ✳ ✶✶
✶✳✷✳✶ | ❯♥ ♣❡✉ ❞✬❤✐st♦✐r❡ ✳ ✳ ✳ ✳ ✳ ✳ ✳ ✳ ✳ ✳ ✳ ✳ ✳ ✳ ✳ ✳ ✳ ✳ ✳ ✶✶
✶✳✷✳✷ | ▲❡s ♣r♦❥❡❝t❡✉rs ❞✬❛♥✐♠❛t✐♦♥ ✳ ✳ ✳ ✳ ✳ ✳ ✳ ✳ ✳ ✳ ✳ ✳ ✳ ✶✶
✶✳✷✳✸ | ▲❡s ✐♥t❡r❢❛❝❡s ■▲❉❆ ✳ ✳ ✳ ✳ ✳ ✳ ✳ ✳ ✳ ✳ ✳ ✳ ✳ ✳ ✳ ✳ ✳ ✶✶
✷ ▲❡ ♣r♦❥❡t ▲❛s❡r ❉r❛✇❡r | ✶✹
✷✳✶ ❈❛❤✐❡r ❞❡s ❝❤❛r❣❡s ✳ ✳ ✳ ✳ ✳ ✳ ✳ ✳ ✳ ✳ ✳ ✳ ✳ ✳ ✳ ✳ ✳ ✳ ✳ ✳ ✳ ✳ ✶✹ ✷✳✷ ❈♦♥❝❡♣t✐♦♥ ✳ ✳ ✳ ✳ ✳ ✳ ✳ ✳ ✳ ✳ ✳ ✳ ✳ ✳ ✳ ✳ ✳ ✳ ✳ ✳ ✳ ✳ ✳ ✳ ✳ ✳ ✶✹
✷✳✷✳✶ | ▼❛tér✐❡❧ ✳ ✳ ✳ ✳ ✳ ✳ ✳ ✳ ✳ ✳ ✳ ✳ ✳ ✳ ✳ ✳ ✳ ✳ ✳ ✳ ✳ ✳ ✳ ✳ ✶✹
✷✳✷✳✷ | ▲♦❣✐❝✐❡❧ ✳ ✳ ✳ ✳ ✳ ✳ ✳ ✳ ✳ ✳ ✳ ✳ ✳ ✳ ✳ ✳ ✳ ✳ ✳ ✳ ✳ ✳ ✳ ✳ ✶✺
✷✳✸ ❈♦♠♣❛r❛✐s♦♥ ❛✈❡❝ ❧✬✐♥t❡r❢❛❝❡ ●❛❧❛①② ▲❛s❡r ❙❤♦✇ ✳ ✳ ✳ ✳ ✳ ✶✽
❆ ❙❝❤é♠❛ é❧❡❝tr♦♥✐q✉❡ | ✷✷
❇ ▲é❣✐s❧❛t✐♦♥ s✉r ❧❡s ❧❛s❡rs | ✷✼
❈ ❈ré❞✐t ✐♠❛❣❡ | ✸✶

▲❛s❡r ❉r❛✇❡r ❡st ✉♥ ♣r♦❥❡t ❞❡ ❞✐s♣♦s✐t✐❢ ❞❡ ♣r♦❥❡❝t✐♦♥ ❧❛s❡r ♦♣❡♥ s♦✉r❝❡✳ ❆♣rès ✉♥ ét❛t ❞❡ ❧✬❛rt ❡t ❞❡s t❡❝❤♥✐q✉❡s✱ ❝❡ ❞♦❝✉♠❡♥t ♣rés❡♥t❡ à ❧❛ ❢♦✐s ❧❡ ❞✐s♣♦s✐t✐❢ ❛✐♥s✐ q✉❡ s❛ ré❛❧✐s❛t✐♦♥✳ ❖♥ tr♦✉✈❡r❛ ❡♥ ❛♥♥❡①❡ ❞✬✉♥❡ ♣❛rt ❧❡ s❝❤é♠❛ é❧❡❝tr♦♥✐q✉❡ ❞✉ ♣r♦t♦t②♣❡ ré❛❧✐sé ❛✐♥s✐ q✉✬✉♥❡ ♥♦t❡ s✉r ❧❛ ré❣❧❡♠❡♥t❛t✐♦♥ ❞❡s ❧❛s❡rs ❡t ❧❡s ♣r♦❜❧è♠❡s q✉✐ ② s♦♥t ❧✐és✳

## ✶ ➱t❛t ❞❡ ❧✬❛rt ❡t ❞❡s t❡❝❤♥✐q✉❡s

P❧✉tôt q✉✬✉♥ ét❛t ❞❡ ❧✬❛rt ❡t ❞❡s t❡❝❤♥✐q✉❡s ❡①❤❛✉st✐❢✱ ❥❡ ♣rés❡♥t❡ ✐❝✐ t♦✉t ❞✬❛❜♦r❞ q✉❡❧q✉❡s ♣r♦❥❡ts ❛rt✐st✐q✉❡s q✉✐ ✉t✐❧✐s❡♥t ❧❡ ❧❛s❡r ❡t ❡♥s✉✐t❡ ♣❧✉s✐❡✉rs s♦❧✉t✐♦♥s t❡❝❤♥✐q✉❡s q✉✐ ♣❡r♠❡tt❡♥t ❞❡ ♣✐❧♦t❡r ❧❡s ♣r♦❥❡❝t❡✉rs ❧❛s❡r ❞❡♣✉✐s ✉♥ ♦r❞✐♥❛t❡✉r✳

✷

## ✶✳✶ ❙é❧❡❝t✐♦♥ ❞❡ ♣r♦❥❡ts ❛rt✐st✐q✉❡s

✶✳✶✳✶ ❇❡r♥❛r❞ ❙③❛❥♥❡r ✕ ❙②♥r✐♥❣✉❡ ✭❤❛r♣❡ ❧❛s❡r✮ ✕ ✶✾✽✵

▲❛ ❤❛r♣❡ ❧❛s❡r ❡st ✉♥ ✐♥str✉♠❡♥t ❞❡ ♠✉s✐q✉❡ ✐♠❛❣✐♥é ♣❛r ❇❡r♥❛r❞ ❙③❛❥♥❡r ✶
| ❡t ❛ttr✐❜✉é à t♦rt à ❏❡❛♥✲▼✐❝❤❡❧ ❏❛rr❡✳ P❧✉s✐❡✉rs ✈❡rs✐♦♥s ♦♥t
✈✉ ❧❡ ❥♦✉r ❞❡♣✉✐s ❧❡s ❛♥♥é❡s ✽✵✱ t♦✉❥♦✉rs ❜❛sé❡s s✉r ❧❡ ♠ê♠❡ ♣r✐♥❝✐♣❡ ✿ ❧❛ ❝♦✉♣✉r❡ ❞✬✉♥ ❢❛✐s❝❡❛✉ ❧❛s❡r à ❧✬❛✐❞❡ ❞❡ ❧❛ ♠❛✐♥ ❞é❝❧❡♥❝❤❡ ✉♥ s②♥t❤ét✐s❡✉r✳ ❙❡❧♦♥ ❏❡❛♥✲▼✐❝❤❡❧ ❏❛rr❡✱ ❧❡ ❧❛s❡r ♣❡r♠❡t ❞❡ ✓ ♣♦✉✈♦✐r ♣❛rt❛❣❡r ❛✈❡❝ ❧❡ ♣✉❜❧✐❝ ❬q✉✐❪ s❡ tr♦✉✈❡ ❛✉ ❢♦♥❞ ❞✬✉♥❡ s❛❧❧❡ ❬✳ ✳ ✳❪ ❧❡ ❥❡✉ ♠✉s✐❝❛❧ ❞✬✉♥❡ ♠❛♥✐èr❡ ✈✐s✐❜❧❡ ❡t à ❧❛ ❢♦✐s s❡♥s✐❜❧❡ ✔✳ ❈❡ ❞✐s♣♦s✐t✐❢ ❛ ♣♦✉rt❛♥t ✉♥❡ ❡①♣r❡ss✐✈✐té ❧✐♠✐té❡ ❝❛r ✐❧ ♥✬② ❛ ♣❛s ❞❡ ❝♦♥trô❧❡ ❞❡ ✈é❧♦❝✐té ♥✐ ❞✬❛❢t❡rt♦✉❝❤ ✷
| ✳
✶✳✶✳✷ | ❆❧✈❛r♦ ❈❛ss✐♥❡❧❧✐ ✕ ❙❝♦r❡ ▲✐❣❤t ✕ ✷✵✵✽

❙❝♦r❡ ▲✐❣❤t ❡st ✉♥ ♣r♦❥❡t ❞✬❆❧✈❛r♦ ❈❛ss✐♥❡❧❧✐ ❞❛♥s ❧❡q✉❡❧ ✉♥ ♣❡t✐t ❢❛✐s❝❡❛✉ ❧❛s❡r s✉✐t ❧❡s ❝♦♥t♦✉rs ❞❡ ❢♦r♠❡s ♣♦sé❡s s✉r ✉♥❡ t❛❜❧❡ ✭❝❢✳ ✶✮✳ ■❧ ❡st ♣♦ss✐❜❧❡ ❞❡ ❜♦✉❣❡r ❧❡s ❢♦r♠❡s ❡t ❞✬❡♥ ❛❥♦✉t❡r ♣♦✉r ♠♦❞✐✜❡r ❧❛ tr❛✲ ❥❡❝t♦✐r❡ ❞✉ ❢❛✐s❝❡❛✉ ❧❛s❡r✳ ❈❡ ❞✐s♣♦s✐t✐❢ s✬❛♣♣✉✐❡ s✉r ❧❡ ❞é✈❡❧♦♣♣❡♠❡♥t ❞✬✉♥ ♠♦❞✉❧❡ ❧❛s❡r ❞❡ ❢❛✐❜❧❡ ♣✉✐ss❛♥❝❡ ❛ss♦❝✐é à ✉♥❡ ❝❛♠ér❛✱ ❞✐s♣♦s✐t✐❢ s✐♠✐❧❛✐r❡ à ❝❡ q✉❡ ❧✬♦♥ ♣❡✉t tr♦✉✈❡r ❞❛♥s ❧❡s ❞♦✉❝❤❡tt❡s ❧❛s❡rs ♣♦✉r s❝❛♥✲ ♥❡r ❧❡s ❝♦❞❡s ❜❛rr❡s✳ ❈❡ ♣r♦❥❡t ♣ré✜❣✉r❡ ❧❡ ♣r♦❥❡t ▲❛s❡r ●❛♠❡ ❡♥ ❝♦✉rs ❞❡ ❞é✈❡❧♦♣♣❡♠❡♥t ❡t ♦ù ❧❡ ❧❛s❡r ❡st ♣r♦❥❡té s✉r ❧❡ t✲s❤✐rt ❞✉ ❥♦✉❡✉r ❡t r❡❜♦♥❞✐t s✉r ❧❡s ♠♦t✐❢s à ❧❛ ♠❛♥✐èr❡ ❞✬✉♥❡ ❜✐❧❧❡ ❞❡ ✢✐♣♣❡r✳


❋✐❣✉r❡ ✶ ✕ ❆❧✈❛r♦ ❈❛ss✐♥❡❧❧✐ ✕ ❙❝♦r❡ ▲✐❣❤t

✶✳ ❤tt♣✿✴✴s③❛❥♥❡r✳♥❡t✴s②r✐♥❣❡✲❧❛s❡r✲❤❛r♣✴ (http://szajner.net/syringe-laser-harp/)
✷✳ ▲✬❛❢t❡rt♦✉❝❤ ❡st ✉♥ t❡r♠❡ ✈❡♥❛♥t ❞❡ ❧❛ ♥♦r♠❡ ▼■❉■ ❡t q✉✐ q✉❛❧✐✜❡ ❧❛ ♣♦ss✐❜✐❧✐té ❞❡ ♠♦❞✉❧❡r ❧❡ s♦♥ ❡♥ ♠♦❞✐✜❛♥t ❧❛ ♣r❡ss✐♦♥ ❡①❡r❝é❡ s✉r ❧❡s t♦✉❝❤❡s ❞✬✉♥ ✐♥str✉♠❡♥t ✭♥♦t❛♠♠❡♥t à ❝❧❛✈✐❡r✮✳

✸

✶✳✶✳✸ ❘♦❜✐♥ ❋♦① ✕ ▲❛s❡r ❙❤♦✇
❘♦❜✐♥ ❋♦① ✉t✐❧✐s❡ ❞❛♥s s❡s s❤♦✇s ❧❡ ❧❛s❡r ❝♦♠♠❡ ✉♥ ♦s❝✐❧❧♦s❝♦♣❡ ♣♦✉r ✈✐s✉❛❧✐s❡r ❧❡ s✐❣♥❛❧ ❛✉❞✐♦ q✉✬✐❧ ❣é♥èr❡ ❡♥ t❡♠♣s ré❡❧ ❛✈❡❝ ❧❡ ❧♦❣✐✲ ❝✐❡❧ ▼❛①✴▼❙P✳ ■❧ ✉t✐❧✐s❡ ❧❛ ❢✉♠é❡ ♣♦✉r ♠❛tér✐❛❧✐s❡r ❧❡ ❢❛✐s❝❡❛✉ ❡t ❢❛✐r❡ ❛♣♣❛r❛îtr❡ ❞❡s ✈♦❧✉♠❡s ❝♦♥✐q✉❡s ❞❛♥s ❧✬❡s♣❛❝❡ ✭❝❢✳ ✷✮✳ ▲❡ s❤♦✇ ❡st ✐♠♣r❡s✲ s✐♦♥♥❛♥t ♠❛✐s ❧❛ ❝♦rré❧❛t✐♦♥ s②sté♠❛t✐q✉❡ ❞✉ s♦♥ ❛✈❡❝ ❧❛ ✈✐s✉❛❧✐s❛t✐♦♥ ❧❡ r❡♥❞ ✈✐t❡ ❡♥♥✉②❡✉①✳ ❘♦❜✐♥ ❋♦① ✉t✐❧✐s❡ ✉♥❡ ❝❛rt❡ s♦♥ ▼❖❚❯ ❚r❛✈❡❧❧❡r ❡t ✉♥ ❜♦ît✐❡r ❞✬❛❞❛♣t❛t✐♦♥ ♣♦✉r ♣✐❧♦t❡r s♦♥ ❧❛s❡r ✈❡rt ❞❡ ✸✺✵ mW q✉✬✐❧ ♥✬❤és✐t❡ ♣❛s ❡♥✈♦②❡r ❞❛♥s ❧❡s ②❡✉① ❞✉ ♣✉❜❧✐❝✳


❋✐❣✉r❡ ✷ ✕ ❘♦❜✐♥ ❋♦① ✕ ▲❛s❡r ❙❤♦✇

✶✳✶✳✹ ❯❱❆ ✕ ❙♣❡❡❞ ♦❢ ❧✐❣❤t ✕ ✷✵✶✵
❙♣❡❡❞ ♦❢ ❧✐❣❤t ❡st ✉♥ ❧❛❜②r✐♥t❤❡ ❞✬✐♥st❛❧❧❛t✐♦♥s ❧❛s❡r ❞❛♥s ❧❡q✉❡❧ ❧❡s s♣❡❝t❛t❡✉rs s♦♥t ✐♥✈✐tés à ❞é❛♠❜✉❧❡r✳ P❧✉s✐❡✉rs ✐♥st❛❧❧❛t✐♦♥s ♣rés❡♥t❡ ❞❡s ❢♦r♠❡s ❣é♦♠étr✐q✉❡s t✐ssé❡s à ♣❛rt✐r ❞❡ q✉❡❧q✉❡s ❢❛✐s❝❡❛✉① ❧❛s❡rs ❞é✈✐és ♣❛r ❞❡s ♠✐r♦✐rs ✜①❡s✳ ❯♥❡ ❛✉tr❡ ❛✣❝❤❡ ✉♥ t❡①t❡ ❞❡ ♠❛♥✐èr❡ ✐♥t❡r❛❝t✐✈❡✳ ❉❛♥s ✉♥❡ ✐♥t❡r✈✐❡✇ ♦♥ ❧❡s ✈♦✐t tr❛✈❛✐❧❧❡r ❛✈❡❝ ❧❡ ❧♦❣✐❝✐❡❧ ▼❛①✴▼❙P✱ ✐❧ ❡st ❢♦rt ♣r♦❜❛❜❧❡ q✉✬✐❧s ❧✬❛✐❡♥t ✉t✐❧✐sé ♣♦✉r ♣✐❧♦t❡r ❧❡s ❧❛s❡rs ♠❛✐s ❥❡ ♥✬❛✐ ♣❛s ♣✉ ❧❡ ✈ér✐✜❡r✳

✹

✶✳✶✳✺ ❘♦❜❡rt ❍❡♥❦❡ ✕ ❋r❛❣✐❧❡s ❚❡rr✐t♦✐r❡s ✕ ✷✵✶✷
❋r❛❣✐❧❡s t❡rr✐t♦✐r❡s ❡st ✉♥❡ ✐♥st❛❧❧❛t✐♦♥ ✐♥t❡r❛❝t✐✈❡ ❡t ❣é♥ér❛t✐✈❡ ❞❡ ❘♦❜❡rt ❍❡♥❦❡ q✉✐ r❡♣rés❡♥t❡ ✉♥ rés❡❛✉ ❛♥✐♠é✳ ▲❡ ♣✉❜❧✐❝ ✐♥✢✉❡ s✉r ❧❡s ❛❧❣♦r✐t❤♠❡s ❣é♥ér❛♥t ❧❡s ❢♦r♠❡s ❣é♦♠étr✐q✉❡s ❡t ❧❡ s♦♥✳ ❈❡tt❡ ✐♥st❛❧❧❛✲ t✐♦♥ ❛ été ♣rés❡♥té❡ à ❧✬❡s♣❛❝❡ ▲❯ ❞❡ ◆❛♥t❡s✳ ❘♦❜❡rt ❍❡♥❦❡ ✉t✐❧✐s❡ ✉♥❡ ❝❛rt❡ s♦♥ ▼❖❚❯ ❚r❛✈❡❧❧❡r ❡t q✉❛tr❡ ❧❛s❡rs ❜❧❡✉✲❥❛✉♥❡s ❞❡ ✺W✳ ❋❛❝❡ à ❧❛ ❞❛♥❣❡r♦s✐té ❞❡ ❝❡s ❧❛s❡rs ❡t ❛✉ ❢❛✐t ❞❡ ❧❡✉r ✉t✐❧✐s❛t✐♦♥ ❡♥ ✐♥tér✐❡✉r✱ ❞❡s ♠❡s✉r❡s s♣é❝✐❛❧❡s ❞❡ sé❝✉r✐té ♦♥t été ♣r✐s❡s ✭❝❢✳ ❇✮✳

✶✳✶✳✻ ❙❛♠✉❡❧ ❇✐❛♥❝❤✐♥✐ ✕ ❊♥s❡✐❣♥❡ ✕ ✷✵✶✷
❊♥s❡✐♥❣♥❡ ❡st ✉♥❡ ✐♥st❛❧❧❛t✐♦♥ ❣é♥ér❛t✐✈❡ ❞❡ ❙❛♠✉❡❧ ❇✐❛♥❝❤✐♥✐✳ ❉❡s ♠♦ts ✐ss✉s ❞✉ ❧❡①✐q✉❡ s❝✐❡♥t✐✜q✉❡ ❡t t✐rés ❞❡s s✐t❡s ✐♥t❡r♥❡t ❞❡s ❧✐❡✉① ❞✬❡♥s❡✐❣♥❡♠❡♥t s✉♣ér✐❡✉r s♦♥t ♣r♦❥❡tés à ❧✬❛✐❞❡ ❞✬✉♥ ❧❛s❡r s✉r ❧❛ ❢❛ç❛❞❡ ❞✬✉♥ ❜ât✐♠❡♥t✳ ▲❡s ♠♦ts s♦♥t é❝r✐ts ❞②♥❛♠✐q✉❡♠❡♥t ❛✈❡❝ ✉♥❡ ❝❛❧❧✐❣r❛♣❤✐❡ ♠❛♥✉s❝r✐t❡✱ ❞❡s r❛t✉r❡s✱ ❞❡s ❤és✐t❛t✐♦♥s✱ ❞❡s ❜❛rrés ❝♦♠♠❡ s✐ q✉❡❧q✉✬✉♥ ét❛✐t ❡♥tr❛✐♥ ❞✬é❝r✐r❡ ❡♥ t❡♠♣s ré❡❧✳ ❈❡tt❡ ✐♥st❛❧❧❛t✐♦♥ ✉t✐❧✐s❡ ✉♥ ❧❛s❡r ✈❡rt ❞❡ ✶✵W ♣✐❧♦té ♣❛r ✉♥❡ ✐♥t❡r❢❛❝❡ ●❛❧❛①② ▲❛s❡r ❙❤♦✇✳ ❯♥ ❧♦❣✐❝✐❡❧ ❛ s♣é❝✐❛❧❡♠❡♥t été ❞é✈❡❧♦♣♣é ♣♦✉r ♣♦✉✈♦✐r ♣✐❧♦t❡r ❝❡tt❡ ✐♥t❡r❢❛❝❡ ❞❡♣✉✐s P✉r❡❞❛t❛ ✭❝❢✳ ✶✳✷✳✸ ❡t ✜❣✉r❡ ✺✮✳

✶✳✶✳✼ ❍②✉♥❞❛✐ ❛♥❞ ❲❤✐t❡❱♦✐❞ ✕ ❋❧✉✐❞✐❝ ✲ ❙❝✉❧♣t✉r❡ ✐♥ ♠♦t✐♦♥ ✕ ✷✵✶✸

P♦✉r ❧❛ s❡♠❛✐♥❡ ❞✉ ❞❡s✐❣♥ ❞❡ ▼✐❧❛♥✱ ❍②✉♥❞❛✐ ❛ ♣rés❡♥té ❛✉ ♠✉sé❡ t❡♠♣♦r❛✐r❡ ❞✉ ♥♦✉✈❡❛✉ ❞❡s✐❣♥ ❧✬✐♥st❛❧❧❛t✐♦♥ ❋❧✉✐❞✐❝ ✲ ❙❝✉❧♣t✉r❡ ✐♥ ♠♦✲ t✐♦♥✳ ❈❡tt❡ ✐♥st❛❧❧❛t✐♦♥ ✐♥t❡r❛❝t✐✈❡ ✉t✐❧✐s❡ ✉♥ s②stè♠❡ ❞❡ ❝❛♣t❛t✐♦♥ tr✐✲ ❞✐♠❡♥s✐♦♥♥❡❧ ❞✉ ♠♦✉✈❡♠❡♥t ♣♦✉r q✉❡ ❧❡s s♣❡❝t❛t❡✉rs ✐♥t❡r❛❣✐ss❡♥t ❛✈❡❝ ✉♥ ♥✉❛❣❡ ❞❡ ♠✐❧❧✐❡r ❞❡ ❜❛❧❧❡s ❞❡ ♣✐♥❣✲♣♦♥❣ ✐❧❧✉♠✐♥é ♣❛r ❞❡ ♣✉✐ss❛♥ts ❧❛s❡r ❜❧❡✉s ✭❝❢✳ ✜❣✉r❡ ✻✮✳

✶✳✶✳✽ ❉❛✐t♦ ▼❛♥❛❜❡ ✕ ❯❱ ❧❛s❡r ❢❛❞❡ ♦✉t ✕ ✷✵✶✵
❉❛✐t♦ ▼❛♥❛❜❡ ✉t✐❧✐s❡ ❧❡ ❧❛s❡r ❞❛♥s ♣❧✉s✐❡✉rs ❞❡ ❝❡s ♣r♦❥❡ts✳ ❯❱ ❧❛✲ s❡r ❢❛❞❡ ♦✉t ✉t✐❧✐s❡ ✉♥ ❧❛s❡r ✉❧tr❛✲✈✐♦❧❡t ♣♦✉r ❞❡ss✐♥❡r s✉r ✉♥ s✉♣♣♦rt ♣❤♦s♣❤♦r❡s❝❡♥t✳ ▲❡ ❧❛s❡r ❝❤❛r❣❡ ❞❡s ♣❡t✐t❡s s✉r❢❛❝❡s s✉❝❝❡ss✐✈❡♠❡♥t✱ ❧❛ ❞é❝❤❛r❣❡ ♣r♦❣r❡ss✐✈❡ ❝ré❡ ❞❡s ♥✐✈❡❛✉① ❞❡ ❧✉♠✐♥♦s✐té ❞✐✛ér❡♥ts ❡t ❢❛✐t ❛♣✲ ♣❛r❛îtr❡ ✉♥❡ ✐♠❛❣❡ ✭❝❢✳ ✜❣✉r❡ ✼✮✳
❉❛♥s P✉❧s❡✱ ❉❛✐t♦ ▼❛♥❛❜❡ ✉t✐❧✐s❡ ❞❡s ❧❛s❡rs ♠♦♥tés s✉r ❞❡s ❜r❛s r♦❜♦✲ t✐sés ❡t ❞❡s ♠✐r♦✐rs ♣❧❛❝és ❞❛♥s t♦✉t ❧✬❡s♣❛❝❡ ♣♦✉r ❞é✈✐❡r ❧❡s tr❛❥❡❝t♦✐r❡s ❡t ❝ré❡r ✉♥ ❥❡✉ ❞❡ ❧✉♠✐èr❡✳

✶✳✶✳✾ ❆♥t♦✐♥❡ ❱✐❧❧❡r❡t ✕ ❙✐❧❤♦✉❡tt❡ ✕ ✷✵✶✸
❙✐❧❤♦✉❡tt❡ ❡st ✉♥❡ ✐♥st❛❧❧❛t✐♦♥ ✐♥t❡r❛❝t✐✈❡ ❞❛♥s ❧❛q✉❡❧❧❡ ✉♥ ♣r♦❥❡❝t❡✉r ❧❛s❡r ❞❡ss✐♥❡ ❧❡s s✐❧❤♦✉❡tt❡s ❛♥✐♠é❡s ❞❡s s♣❡❝t❛t❡✉rs✳ ▲♦rsq✉✬✉♥ s♣❡❝t❛✲ t❡✉r ♣❛ss❡ ❞❡✈❛♥t ❧❛ ❝❛♠ér❛ ✉♥ tr❛✐t ✈❡rt ❛♣♣❛r❛ît ❛✉ ♠✉r✳ ❙✬✐❧ ❛✈❛♥❝❡✱ ❧❡

✺

tr❛✐t ❞❡✈✐❡♥t ❢♦r♠❡ ❡t ❧❡ s♣❡❝t❛t❡✉r s❡ r❡❝♦♥♥❛ît ❛❧♦rs✳ ▲♦rsq✉✬✉♥ s♣❡❝t❛✲ t❡✉r ♣❛ss❡ ❞❡✈❛♥t ❧❛ ❝❛♠ér❛ ✉♥ tr❛✐t ✈❡rt ❛♣♣❛r❛ît ❛✉ ♠✉r✳ ❙✬✐❧ ❛✈❛♥❝❡✱ ❧❡ tr❛✐t ❞❡✈✐❡♥t ❢♦r♠❡ ❡t ❧❡ s♣❡❝t❛t❡✉r s❡ r❡❝♦♥♥❛ît ❛❧♦rs✳ ▲❡ ❞✐s♣♦s✐t✐❢ ❛tt✐r❡ ❧❡s ✈✐s✐t❡✉rs q✉✐ s♦♥t ❝✉r✐❡✉① ❞❡s ❢♦r♠❡s ❛♥✐♠é❡s ♣r♦❥❡té❡s ❛✉ ♠✉r ✭❝❢✳ ✽✮✳ ▲♦rsq✉❡ ❧❡ ♣✉❜❧✐❝ ❡st tr♦♣ ♥♦♠❜r❡✉①✱ ❧❡s s✐❧❤♦✉❡tt❡s s✬❡♥tr❡♠ê❧❡♥t ❡t ❞❡✈✐❡♥♥❡♥t ❛❜str❛✐t❡s✱ à t❡❧ ♣♦✐♥t q✉❡ ❝❡rt❛✐♥s ♥❡ r❡♥❞❡♥t ♣❛s ❝♦♠♣t❡ q✉❡ ❝✬❡st ❡✉① q✉✐ s♦♥t r❡♣rés❡♥tés✳ ▲♦rsq✉✬✐❧ ② ❛ ♠♦✐♥s ❞❡ ♠♦♥❞❡✱ ❧❡s s✐❧❤♦✉❡tt❡s ❞❡✈✐❡♥♥❡♥t ♣❧✉s ♥❡tt❡s✳ P♦✉r ❛✉t❛♥t✱ ❧❡ s♣❡❝t❛t❡✉r ♥❡ ré❛❧✐s❡ ♣❛s ❢♦r❝é♠❡♥t q✉✬✐❧ ❡st r❡♣rés❡♥té ❡♥ t❡♠♣s ré❡❧✳ ❙♦✉✈❡♥t✱ ❧♦rsq✉✬✐❧ s✬❡♥ r❡♥❞ ❝♦♠♣t❡✱ ✉♥ ❥❡✉ ❛✈❡❝ ❧❡ ❞✐s♣♦s✐t✐❢ ❞é❜✉t❡✳ ▲❡s s♣❡❝t❛t❡✉rs ❞❛♥s❡♥t✱ s❛✉t❡♥t✱ ❢♦♥t ❞❡s ❣r✐♠❛❝❡s ♣♦✉r t❡st❡r ❧❡ ❞✐s♣♦s✐t✐❢ ❡t ❝❤❡r❝❤❡r s❡s ❧✐♠✐t❡s✳ ❈❡tt❡ ✐♥st❛❧❧❛t✐♦♥ ✉t✐❧✐s❡ ✉♥ ❝❛♣t❡✉r ❑✐♥❡❝t ♣♦✉r ❡①tr❛✐r❡ ❧❡s s✐❧❤♦✉❡tt❡s ❛✐♥s✐ q✉❡ ❧✬✐♥t❡r❢❛❝❡ ❞é❝r✐t❡ ❞❛♥s ❧❛ s✉✐t❡ ❞❡ ❝❡ ❞♦❝✉♠❡♥t ♣♦✉r ♣✐❧♦t❡r ❧❡ ❧❛s❡r✳

### ✶✳✶✳✶✵ ▼❛rs❤♠❛❧❧♦✇ ▲❛s❡r ❋❡❛st ✕ ▲❛s❡r ❋♦r❡st ✕ ✷✵✶✸

▲❛s❡r ❋♦r❡st ✉t✐❧✐s❡ ✶✺✵ ❧❛s❡rs ♣❧❛❝és ❡♥ ❤❛✉t ❞❡ ♠âts ❞✬❡♥✈✐r♦♥ ✸ m ❝♦♥st✐t✉❛♥t ❛✐♥s✐ ✉♥❡ ✓ ❢♦rêt ✔✳ ▲❛ s♦✉♣❧❡ss❡ ♥❛t✉r❡❧❧❡ ❞❡s ♠âts ❢❛✐t ♦s✲ ❝✐❧❧❡r ❧❡s ❧❛s❡rs ❞ès ❧♦rs q✉✬♦♥ ❧❡s t♦✉❝❤❡ ✭❝❢✳ ✾✮✳ ❈❡s ❧❛s❡rs ❞❡ss✐♥❡♥t ❞❡s ❢♦r♠❡s ♠♦✉✈❛♥t❡s ❞❛♥s ❧✬❡s♣❛❝❡ ❡t à ❝❤❛q✉❡ ✓ ❛r❜r❡ ✔ ❡st ❛ss♦❝✐é ✉♥ s♦♥✳

✻


❋✐❣✉r❡ ✸ ✕ ❯❱❆ ✕ ❙♣❡❡❞ ♦❢ ❧✐❣❤t

✼


❋✐❣✉r❡ ✹ ✕ ❘♦❜❡rt ❍❡♥❦❡ ✕ ❋r❛❣✐❧❡s ❚❡rr✐t♦✐r❡s


❋✐❣✉r❡ ✺ ✕ ❙❛♠✉❡❧ ❇✐❛♥❝❤✐♥✐ ✕ ❊♥s❡✐❣♥❡

✽


❋✐❣✉r❡ ✻ ✕ ❍②✉♥❞❛✐ ❛♥❞ ❲❤✐t❡❱♦✐❞ ✕ ❋❧✉✐❞✐❝ ✲ ❙❝✉❧♣t✉r❡ ✐♥ ♠♦t✐♦♥


❋✐❣✉r❡ ✼ ✕ ❉❛✐t♦ ▼❛♥❛❜❡ ✕ ❯❱ ❧❛s❡r ❢❛❞❡ ♦✉t

✾


❋✐❣✉r❡ ✽ ✕ ❆♥t♦✐♥❡ ❱✐❧❧❡r❡t ✕ ❙✐❧❤♦✉❡tt❡


❋✐❣✉r❡ ✾ ✕ ▼❛rs❤♠❛❧❧♦✇ ▲❛s❡r ❋❡❛st ✕ ▲❛s❡r ❋♦r❡st

✶✵

## ✶✳✷ ➱t❛t ❞❡s t❡❝❤♥✐q✉❡s

✶✳✷✳✶ ❯♥ ♣❡✉ ❞✬❤✐st♦✐r❡

▲❡ ❧❛s❡r ❛ été ❝♦♥❝❡♣t✉❛❧✐sé ♣❛r ❆❧❜❡rt ❊✐♥st❡✐♥ ✈❡rs ✶✾✶✼✳ ▲❡ ♣r❡♠✐❡r ❧❛s❡r ❛ été ❝♦♥str✉✐t ❡♥ ✶✾✺✽✳ ❙♦♥ ✉t✐❧✐s❛t✐♦♥ ✐♥❞✉str✐❡❧❧❡ ✭❞é❝♦✉♣❡ ♥♦t❛♠✲ ♠❡♥t✮ ❝♦♠♠❡♥❝❡ à ❧❛ ✜♥ ❞❡s ❛♥♥é❡s ✼✵✱ ❞❡♣✉✐s ✐❧ ❡st ❡①trê♠❡♠❡♥t ✉t✐❧✐sé ✿ ❧❡❝t❡✉r ❞✐sq✉❡ ♦♣t✐q✉❡ ✭❈❉✱ ❉❱❉✳✳✳✮✱ ❧❡❝t❡✉r ❞❡ ❝♦❞❡ ❜❛rr❡✱ ❞é❝♦✉♣❡ ❞❡ ♠❛tér✐❛✉①✱ ❛r♠❡ ❞❡ ❞ét❡❝t✐♦♥✱ ❝❛♣t❡✉r ❞❡ ❞✐st❛♥❝❡✳ ✳ ✳ ❏❡❛♥✲▼✐❝❤❡❧ ❏❛rr❡ ❢✉t✱ à ♠❛ ❝♦♥♥❛✐ss❛♥❝❡✱ ❧❡ ♣r❡♠✐❡r à ✉t✐❧✐s❡r ❧❡ ❧❛s❡r ❞❛♥s ✉♥ ❜✉t ❛rt✐st✐q✉❡ ❛✈❡❝ s❛ ❤❛r♣❡ ❧❛s❡r✳

✶✳✷✳✷ ▲❡s ♣r♦❥❡❝t❡✉rs ❞✬❛♥✐♠❛t✐♦♥

❉❛♥s ❧❡s ♣r♦❥❡❝t❡✉rs ❞✬❛♥✐♠❛t✐♦♥✱ ❧❡ ❢❛✐s❝❡❛✉ ❧❛s❡r ❡st ❞é✈✐é ♣❛r ❞❡s ♠✐r♦✐rs ♠♦❜✐❧❡s très r❛♣✐❞❡s ❡✛❡❝t✉❛♥t ✉♥ ❜❛❧❛②❛❣❡ ♣❡r♠❛♥❡♥t✳ ▲❛ ♣❡r✲ s✐st❛♥❝❡ rét✐♥✐❡♥♥❡ ♣❡r♠❡t ❞❡ ✈♦✐r ❧❛ tr❛❝❡ ❞✉ ❧❛s❡r✳ ❈❡rt❛✐♥s ♣r♦❥❡❝t❡✉rs s♦♥t ❞♦tés ❞✬✉♥❡ ❡♥tré❡ ❉▼❳ q✉✐ ♣❡r♠❡t ❞❡ ❝❤♦✐s✐r ❧❡ ♠♦t✐❢ ♣❛r♠✐ ✉♥❡ ❜✐❜❧✐♦t❤èq✉❡ ✐♥té❣ré❡ ❛✉ ♣r♦❥❡❝t❡✉r ❡t ❞✬❡♥ ♠♦❞✐✜❡r ❝❡rt❛✐♥s ♣❛r❛♠ètr❡s ❝♦♠♠❡ ❧✬é❝❤❡❧❧❡ ♦✉ ❧❛ ♣♦s✐t✐♦♥✳ ❊♥ r❡✈❛♥❝❤❡✱ ❧❡ ♣r♦t♦❝♦❧❡ ❉▼❳ ♥❡ ♣❡r✲ ♠❡t ♣❛s ❞❡ ❞❡ss✐♥❡r ❞❡s ❢♦r♠❡s ❛r❜✐tr❛✐r❡s✳ P♦✉r ❝❡❧❛✱ ❝❡rt❛✐♥s ♣r♦❥❡❝✲ t❡✉rs s♦♥t éq✉✐♣és ❞✬✉♥❡ ❡♥tré❡ ■▲❉❆✳ ❈❡ ♣r♦t♦❝♦❧❡ ❛♥❛❧♦❣✐q✉❡ ♣❡r♠❡t ❞❡ ❝♦♥trô❧❡r ❞✐r❡❝t❡♠❡♥t ❧❡s s❝❛♥♥❡rs ❡t ❧✬✐♥t❡♥s✐té ❞❡s s♦✉r❝❡s✳ ❖♥ ♣❡✉t ❞♦♥❝ ❞❡ss✐♥❡r ❞❡s ❢♦r♠❡s ❛r❜✐tr❛✐r❡s✳

✶✳✷✳✸ ▲❡s ✐♥t❡r❢❛❝❡s ■▲❉❆

❇✐❡♥ q✉❡ ❧❡ ♣r♦t♦❝♦❧❡ ■▲❉❆ s♦✐t ❛ss❡③ ré♣❛♥❞✉ s✉r ❧❡s ♣r♦❥❡❝t❡✉rs ❞✬❛♥✐♠❛t✐♦♥ à ♣❛rt✐r ❞✉ ♠✐❧✐❡✉ ❞❡ ❣❛♠♠❡✱ ✐❧ ❡①✐st❡ ♣❡✉ ❞✬✐♥t❡r❢❛❝❡s s✉r ❧❡ ♠❛r❝❤é ♣❡r♠❡tt❛♥t ❞❡ ❧❡s ❝♦♥trô❧❡r ❞❡♣✉✐s ✉♥ ♦r❞✐♥❛t❡✉r✳

P❛♥❣♦❧✐♥ ▲❡ ❧❡❛❞❡r ❞✉ ♠❛r❝❤é ❞❛♥s ❝❡ ❞♦♠❛✐♥❡ ❡st P❛♥❣♦❧✐♥ q✉✐ ♣r♦✲ ♣♦s❡ ✉♥❡ s✉✐t❡ ❧♦❣✐❝✐❡❧❧❡ ❡t ♠❛tér✐❡❧❧❡ ❝♦♠♣❧èt❡ ♣♦✉r ❝♦♥trô❧❡r ❧❡s ❧❛s❡r✳ ❆✉ ♥✐✈❡❛✉ ❧♦❣✐❝✐❡❧✱ ✐❧s ♣r♦♣♦s❡♥t ❞❡s s♦❧✉t✐♦♥s ♣♦✉r ré❛❧✐s❡r ❞❡ ♣❡t✐ts s❤♦✇ ❧❛s❡r ✭◗✉✐❝❦ ❙❤♦✇✮ ✐♥té❣r❛♥t ✉♥ séq✉❡♥❝❡✉r ❞✬❛♥✐♠❛t✐♦♥✳ ■❧ ♣r♦✲ ♣♦s❡ é❣❛❧❡♠❡♥t ✉♥ ❙❉❑ ♣♦✉r ❞é✈❡❧♦♣♣❡r ❞❡s ❛♣♣❧✐❝❛t✐♦♥s s♣é❝✐✜q✉❡s ❡t ❞❡s ✉t✐❧✐t❛✐r❡s ❞❡ ✈❡❝t♦r✐s❛t✐♦♥ ♣♦✉r ❝♦♥✈❡rt✐r ❞❡s ✐♠❛❣❡s ✜①❡s✳ ❆✉ ♥✐✲ ✈❡❛✉ ♠❛tér✐❡❧✱ P❛♥❣♦❧✐♥ ❛ ❞é✈❡❧♦♣♣é ✉♥❡ ❝❤❛î♥❡ t❡❝❤♥✐q✉❡ très ❝♦♠♣❧èt❡✳ ❖♥ tr♦✉✈❡ ❞❡s ✐♥t❡r❢❛❝❡s ■▲❉❆ ❯❙❇✱ rés❡❛✉✱ ❖❊▼ ♠❛✐s é❣❛❧❡♠❡♥t ❞❡s ♠❛tr✐❝❡s ♣❡r♠❡tt❛♥t ❞✐str✐❜✉❡r ❧❡ s✐❣♥❛❧ à ❞✐✛ér❡♥ts ♣r♦❥❡❝t❡✉rs ❡t ❛✉ss✐ ❞❡s ♦♣t✐q✉❡s s♣é❝✐✜q✉❡s ✭♣♦✉r ♣r♦❥❡t❡r à ✸✻✵➦♣❛r ❡①❡♠♣❧❡✮✳ ▼❛❧❤❡✉r❡✉s❡♠❡♥t t♦✉t ❝❡❝✐ ❡st ✉♥✐q✉❡♠❡♥t ❞✐s♣♦♥✐❜❧❡ ♣♦✉r ❲✐♥❞♦✇s✳ ▲❡s s♦❧✉t✐♦♥s P❛♥❣♦❧✐♥ s♦♥t ❛ss❡③ ♦♥ér❡✉s❡s ♣✉✐sq✉❡ ❧✬✐♥t❡r❢❛❝❡ ❛✈❡❝ ❧❡ ❧♦❣✐❝✐❡❧ ❞❡ ❜❛s❡ ❡st ❝♦♠♠❡r❝✐❛❧✐sé❡ ❛✉ ♣r✐① ❞❡ ✻✺✵ e ❡t ❧❡s ✈❡rs✐♦♥s ♣r♦✲ ❢❡ss✐♦♥♥❡❧❧❡s ❞é♣❛ss❡♥t ❧❡s ✹ ✵✵✵ e✳

✶✶

❊❧❡❝tr♦✲❝♦♥❝❡♣t ❊❧❡❝tr♦✲❝♦♥❝❡♣t ✸ ❛ ❞é✈❡❧♦♣♣é ❞❡✉① ✐♥t❡r❢❛❝❡s ❯❙❇ ■▲❉❆✱ ▼✐♥✐✐❧❞❛ ❡t ▼❛①✐✐❧❞❛ ❝♦♠♠❡r❝✐❛❧✐sé❡s r❡s♣❡❝t✐✈❡♠❡♥t ❛✉ ♣r✐① ❞❡ ✷✶✾ e ❡t ✸✹✾ e✳ ❈❡s ❞❡✉① ✐♥t❡r❢❛❝❡s ❢♦♥❝t✐♦♥♥❡♥t s♦✉s ❲✐♥❞♦✇s ✉♥✐q✉❡✲ ♠❡♥t✳ ❏✬❛✐ ♣✉ t❡sté ❧✬✐♥t❡r❢❛❝❡ ▼✐♥✐✐❧❞❛ ❡t ❥✬❛✐ ❞é✈❡❧♦♣♣é ✉♥ ❝♦♥trô❧❡✉r ❛✈❡❝ P✉r❡❞❛t❛✳ ▼❛✐s ❧✬✐♥t❡r❢❛❝❡ ♠❛♥q✉❡ ❞❡ st❛❜✐❧✐té ❡t ➱❧❡❝tr♦✲❝♦♥❝❡♣t ❡st tr♦♣ ♣❡✉ ré❛❝t✐❢ à ♠❡s q✉❡st✐♦♥s ♣♦✉r ❝❡ ❣❡♥r❡ ❞é✈❡❧♦♣♣❡♠❡♥t✳ ❏✬❛✐ ❞♦♥❝ ❛❜❛♥❞♦♥♥é ❝❡tt❡ ♣✐st❡ ❛ss❡③ tôt✳

●❛❧❛①② ▲❛s❡r ❙❤♦✇ P♦✉r ❧❡ ♣r♦❥❡t ❊♥s❡✐❣♥❡ ❞❡ ❙❛♠✉❡❧ ❇✐❛♥❝❤✐♥✐ ✭❝❢✳ ✺✮✱ ♥♦✉s ❛✈♦♥s tr❛✈❛✐❧❧é ❛✈❡❝ ❧❛ s♦❝✐été q✉✐ é❞✐t❡ ❧✬✐♥t❡r❢❛❝❡ ●❛❧❛①② ▲❛s❡r ❙❤♦✇ ❛✉ ❞é✈❡❧♦♣♣❡♠❡♥t ❞✬✉♥ s❡r✈❡✉r ❝r♦ss✲♣❧❛t❡❢♦r♠❡✳ ❈❡❝✐ ❝♦♥st✐t✉❛✐t ✉♥❡ ❜♦♥♥❡ ✐♥✐t✐❛t✐✈❡✱ ♠ê♠❡ s✐ ❧❡ ❧♦❣✐❝✐❡❧ ♥✬❡st ♣❛s ♦♣❡♥ s♦✉r❝❡✱ ❝✬ét❛✐t ❧❛ ♣r❡♠✐èr❡ ✐♥t❡r❢❛❝❡ q✉✐ ❢♦♥❝t✐♦♥♥❡ s♦✉s t♦✉s ❧❡s s②stè♠❡s ❞✬❡①♣❧♦✐t❛t✐♦♥ q✉❡ ❥❡ ❝♦♥♥❛✐ss❡✳ ▲✬✐♥t❡r❢❛❝❡ ❡st ❜❛sé s✉r ✉♥ s❡r✈❡✉r ❯❉P ♣r♦❣r❛♠♠é ❡♥ ❈★ s✉r ❧❛ ♣❧❛t❡❢♦r♠❡ ✳◆❊❚ ✹ q✉✐ ❝♦♠♠✉♥✐q✉❡ ❛✈❡❝ ❧✬✐♥t❡r❢❛❝❡ ❯❙❇ q✉✐ ❝♦♥t✐❡♥t ✉♥ ❋P●❆✳ P♦t❡♥t✐❡❧❧❡♠❡♥t✱ ♥✬✐♠♣♦rt❡ q✉❡❧ ❧♦❣✐❝✐❡❧ ❝❛♣❛❜❧❡ ❞✬❡♥✈♦②❡r ❞❡s ❞♦♥♥é❡s ❡♥ ❯❉P ♣❡✉t ❞♦♥❝ ❞❡ss✐♥❡r ❛✈❡❝ ✉♥ ❧❛s❡r ❡t ❝❡tt❡ ✐♥t❡r❢❛❝❡✳
❏✬❛✐ t❡sté ❧❡s ✈❡rs✐♦♥s ✷ ❡t ✸ ❞❡ ❧✬✐♥t❡r❢❛❝❡ ●❛❧❛①②✳ ❆✈❡❝ ❧❛ ✈❡rs✐♦♥ ✷✱ ❧❡ s❡r✈❡✉r ❝❡ss❡ ❞❡ ré♣♦♥❞r❡ ❧♦rsq✉✬♦♥ ❡♥✈♦✐❡ ❞❡s tr❛♠❡s rés❡❛✉ tr♦♣ ♣❡t✐t❡s ♦✉ ❧♦rsq✉❡ ❧❛ ❢réq✉❡♥❝❡ ❡st tr♦♣ é❧❡✈é❡ ✭❛✉ ❞❡❧à ❞❡ ✷✵ kpps✮✳ ▼❛❧❣ré ❝❡ ♣r♦❜❧è♠❡✱ ❝❡tt❡ ✐♥t❡r❢❛❝❡ ❛ été ✉t✐❧✐sé❡ à ♣❧✉s✐❡✉rs r❡♣r✐s❡s ♣♦✉r ❧❛ ♣ré✲ s❡♥t❛t✐♦♥ ❞✬❊♥s❡✐❣♥❡ ❡t ❞❡ ❧❛ ♣r❡♠✐èr❡ ✈❡rs✐♦♥ ❞❡ ♠♦♥ ✐♥st❛❧❧❛t✐♦♥ ▲❛s❡r ❉r❛✇❡r✳ ▲❡ ♠♦❞è❧❡ ✸ q✉❡ ❥✬❛✐ ❡✉ ❡♥ t❡st s❡♠❜❧❡ ❞é❢❡❝t✉❡✉① ✿ ❧✬✐♥t❡r❢❛❝❡ ♥✬❡st ♣❧✉s r❡❝♦♥♥✉❡ ❞ès ❧♦rs q✉❡ q✉❡❧q✉❡ ❝❤♦s❡ ❡st r❡❧✐é❡ ❛✉ ❝♦♥♥❡❝t❡✉r ❙❯❇✲❉✷✺✳

▲❡ ♣r♦❥❡t ❜■▲❉❆ ✺ ❜■▲❉❆ ❡st ✉♥ ♣r♦❥❡t ❞✬✐♥t❡r❢❛❝❡ ❧❛s❡r ♦♣❡♥ s♦✉r❝❡ ❝♦♥st✐t✉é ❞✬✉♥❡ ✐♥t❡r❢❛❝❡ é❧❡❝tr♦♥✐q✉❡ ❯❙❇ ❡t ❞✬✉♥ ❧♦❣✐❝✐❡❧ ♣♦✉r ❧✬✉t✐❧✐✲ s❡r✳ ❈❡ ♣r♦❥❡t ❡st ❛❝t✉❡❧❧❡♠❡♥t ♦❜s♦❧èt❡ ✿ ❧❡ ♠✐❝r♦✲❝♦♥trô❧❡✉r ❆◆✷✶✸✺❙❈ ❞❡ ❈②♣r❡ss ❙❡♠✐❝♦♥❞✉❝t♦r✱ é❧é♠❡♥t ♣r✐♥❝✐♣❛❧ ❞❡ ❧❛ ❝❛rt❡ é❧❡❝tr♦♥✐q✉❡✱ ♥✬❡st ♣❧✉s ❢❛❜r✐q✉é✳ ❉❡ ♣❧✉s✱ s❡s ♣❡r❢♦r♠❛♥❝❡s ét❛✐❡♥t ❛ss❡③ ♠♦❞❡st❡ ✿ ❧❡s ❝♦♥✈❡rt✐ss❡✉rs ❛♥❛❧♦❣✐q✉❡✲♥✉♠ér✐q✉❡ ❉❆❈✵✽✸✵ ♦♥t ✉♥❡ q✉❛♥t✐✜❝❛t✐♦♥ ❞❡ ✽ bit s❡✉❧❡♠❡♥t✳

❊t❤❡r❞r❡❛♠ ✻ ❊t❤❡r❞r❡❛♠ ❡st ✉♥❡ ✐♥t❡r❢❛❝❡ ■▲❉❆ ❖♣❡♥ ❙♦✉r❝❡ ❡①✲ trê♠❡♠❡♥t ♣♦❧②✈❛❧❡♥t❡✳ ❊❧❧❡ ♣♦ssè❞❡ ✉♥❡ ✐♥t❡r❢❛❝❡ ❊t❤❡r♥❡t ♣❡r♠❡tt❛♥t ❞✬❡♥✈♦②❡r ❞❡s tr❛♠❡s ■▲❉❆ ❥✉sq✉✬à ✶✵✵ kpps✳ ❙♦♥ s❧♦t ♣♦✉r ❝❛rt❡ ▼✐✲ ❝r♦❙❉ ♣❡r♠❡t ❞❡ s❛✉✈❡❣❛r❞❡r ❧❛ ❝♦♥✜❣✉r❛t✐♦♥ ❡t ❞❡ ❥♦✉❡r ❞❡s ❛♥✐♠❛t✐♦♥s ❞❡ ♠❛♥✐èr❡ ❛✉t♦♥♦♠❡✳ ❊❧❧❡ ❡st ❡♥t✐èr❡♠❡♥t ❝♦♥✜❣✉r❛❜❧❡ ❡♥ ❖❙❈ ❡t ✐♥✲ tè❣r❡ ✉♥❡ ❝♦rr❡❝t✐♦♥ ❞❡ ♣❡rs♣❡❝t✐✈❡✳ ❏❡ ♥✬❛✐ ♠❛❧❤❡✉r❡✉s❡♠❡♥t ❞é❝♦✉✈❡rt

✸✳ ❤tt♣✿✴✴✇✇✇✳❜♦✉t✐q✉❡✲❡❧❡❝tr♦❝♦♥❝❡♣t✳❝♦♠✴❜♦✉t✐q✉❡✴ (http://www.boutique-electroconcept.com/boutique/)
✹✳ ✳◆❊❚ ❡st ✉♥❡ t❡❝❤♥♦❧♦❣✐❡ ❞❡ ▼✐❝r♦s♦❢t q✉✐ ❡st ❞✐s♣♦♥✐❜❧❡ s✉r ▼❛❝ ❖❙ ❳ ❡t ▲✐♥✉① à tr❛✈❡rs ❧❡ ❢r❛♠❡✇♦r❦ ♦♣❡♥ s♦✉r❝❡ ▼♦♥♦✳
✺✳
✻✳ ❤tt♣✿✴✴❡t❤❡r✲❞r❡❛♠✳❝♦♠✴ (http://ether-dream.com/)

✶✷

❝❡tt❡ ✐♥t❡r❢❛❝❡ q✉✬❛♣rès ❛✈♦✐r ❝♦♥ç✉ ❧❛ ♠✐❡♥♥❡✳ ❊❧❧❡s s♦♥t ❡①trê♠❡♠❡♥t s✐♠✐❧❛✐r❡s ❞❛♥s ❧❡s ❢♦♥❝✐t♦♥s ❞✐s♣♦♥✐❜❧❡s✳ ▲✬✐♥t❡r❢❛❝❡ ❊t❤❡r❞r❡❛♠ ❡st ✈❡♥✲ ❞✉❡ ✷✹✾ $✳

▲❡s ✐♥t❡r❢❛❝❡s ❛❧t❡r♥❛t✐✈❡s ❈♦♠♠❡ é✈♦q✉é ❞❛♥s ❧❛ ♣❛rt✐❡ ✶✳✶✱ ♣❧✉✲ s✐❡✉rs ❛rt✐st❡s ✉t✐❧✐s❡♥t ❞❡s ❝❛rt❡s s♦♥s ♣♦✉r ♣✐❧♦t❡r ❧❡s ❧❛s❡rs✳ ❖♥ r❡✲ tr♦✉✈❡ à ♣❧✉s✐❡✉rs r❡♣r✐s❡ ♥♦t❛♠♠❡♥t ❧❛ ▼❖❚❯ ❚r❛✈❡❧❧❡r q✉✐ ♥❡ ♣♦ssè❞❡ ♣❛s ❞❡ ✜❧tr❡s ❝♦♥t✐♥✉s ❡♥ s♦rt✐❡✱ ❝❡ q✉✐ ♣❡r♠❡t ❞✬❡♥✈♦②❡r ✉♥ s✐❣♥❛❧ ♥♦♥ s②♠étr✐q✉❡ ♣❛r r❛♣♣♦rt à ❧❛ ♠❛ss❡ ❡t ❞♦♥❝ ❞❡ ❞é❝❛❧❡r ✈❡rt✐❝❛❧❡♠❡♥t ❡t ❤♦r✐③♦♥t❛❧❡♠❡♥t ❧❡ ❞❡ss✐♥ ❞✉ ❧❛s❡r ♣❛r r❛♣♣♦rt ❛✉ ❝❡♥tr❡ ❞❡ ❧❛ ♣r♦❥❡❝✲ t✐♦♥✳ ❈❡s ❛rt✐st❡s ✉t✐❧✐s❡♥t ❧❡✉r ♣r♦♣r❡ ❧♦❣✐❝✐❡❧ ✭s♦✉✈❡♥t ❝♦♥ç✉ à ♣❛rt✐r ❞❡ ▼❛①✴▼❙P✮ ❡t ❧❡✉r ♣r♦♣r❡ ✐♥t❡r❢❛❝❡ ❞✬❛❞❛♣t❛t✐♦♥ ❞✉ s✐❣♥❛❧ é❧❡❝tr✐q✉❡✳

✶✸

✷ ▲❡ ♣r♦❥❡t ▲❛s❡r ❉r❛✇❡r

## ✷✳✶ ❈❛❤✐❡r ❞❡s ❝❤❛r❣❡s

❱❡rs❛t✐❧✐té ▲❛ ♣r❡♠✐èr❡ ❝♦♥tr❛✐♥t❡ ❞✉ ❞✐s♣♦s✐t✐❢ ❡st s❛ ❝♦♠♣❛t✐❜✐❧✐té ❛✈❡❝ ❧❡s ❧❛s❡rs ❞✬❛♥✐♠❛t✐♦♥ ❞✉ ❝♦♠♠❡r❝❡✳ ▲❛ ♥♦r♠❡ ■▲❉❆ ❞é✜♥✐ ✉♥ ♣r♦✲ t♦❝♦❧❡ ❛♥❛❧♦❣✐q✉❡ ♣♦✉r ♣✐❧♦t❡r ❝❡s ❧❛s❡rs✳ ▲❡ ❞✐s♣♦s✐t✐❢ ❞♦✐t ❞♦♥❝ êtr❡ ❝♦♥❢♦r♠❡ à ❝❡tt❡ ♥♦r♠❡✳

Pr✐① ▲❡s s♦❧✉t✐♦♥s ✭♣❛❝❦ ✐♥t❡r❢❛❝❡ ✰ ❧♦❣✐❝✐❡❧✮ ❞✉ ❝♦♠♠❡r❝❡ ❝♦ût❡♥t ♣❧✉s✐❡✉rs ❝❡♥t❛✐♥❡s ❞✬❡✉r♦s✱ ▲❛s❡r ❉r❛✇❡r ❡st ❝♦♥ç✉ à ♣❛rt✐r ❞❡ ♠❛tér✐❡❧ ♣❡✉ ❝❤❡r ❡t ❞✬✉♥ ❧♦❣✐❝✐❡❧ ♦♣❡♥ s♦✉r❝❡ ❣r❛t✉✐t✳

❈♦♠♣❛t✐❜✐❧✐té ▲❛s❡r ❉r❛✇❡r ❡st ❝♦♠♣❛t✐❜❧❡ ❛✈❡❝ ❧❛ ♣❧✉♣❛rt ❞❡s s②s✲ tè♠❡s ❞✬❡①♣❧♦✐t❛t✐♦♥ ✭▼✐❝r♦s♦❢t ❲✐♥❞♦✇s✱ ❆♣♣❧❡ ▼❛❝ ❖❙ ❳✱ ❡t ❧❡s ❞✐str✐✲ ❜✉t✐♦♥s ▲✐♥✉①✱ ♥♦t❛♠♠❡♥t ❉❡❜✐❛♥ ❡t s❡s ❞ér✐✈és ❯❜✉♥t✉ ❡t ❘❛s♣❜✐❛♥✮✳

✷✳✷ ❈♦♥❝❡♣t✐♦♥

▲❡ ❞✐s♣♦s✐t✐❢ ▲❛s❡r ❉r❛✇❡r s❡ ❝♦♠♣♦s❡ ❞✬✉♥❡ ♣❛rt✐❡ ♠❛tér✐❡❧❧❡ ❡t ❞✬✉♥ ❧♦❣✐❝✐❡❧ ♣♦✉r ❧❛ ♣✐❧♦t❡r✳

✷✳✷✳✶ ▼❛tér✐❡❧

▲✬✐♥t❡r❢❛❝❡ ♠❛tér✐❡❧ ❞❡ ▲❛s❡r ❉r❛✇❡r ❡st ❜❛sé❡ s✉r ✉♥❡ ❝❛rt❡ s♦♥ ❡t ✉♥ ét❛❣❡ ❞✬❛❞❛♣t❛t✐♦♥ à ❧❛ ♥♦r♠❡ ■▲❉❆✳

■♥t❡r❢❛❝❡ s♦♥ ▲❛ ❝❛rt❡ s♦♥ ❊❙■ ❯❉❏✲✻ ❛ été ❝❤♦✐s✐❡ ❝❛r ❡❧❧❡ ❡st ❝♦♥❢♦r♠❡ à ❧❛ ♥♦r♠❡ ❯❙❇ ❆✉❞✐♦ ❈❧❛ss ✶✳✵ ❡t ❞♦♥❝ ❞❡ ❢❛✐t ❝♦♠♣❛t✐❜❧❡ ❛✈❡❝ ❧❛ ♣❧✉✲ ♣❛rt ❞❡s s②stè♠❡s ✭♥♦t❛♠♠❡♥t ▲✐♥✉①✮✳ ❊❧❧❡ ♣♦ssè❞❡ ✻ s♦rt✐❡s ❛♥❛❧♦❣✐q✉❡s ❡t ❛✉❝✉♥❡ ❡♥tré❡✱ ✐❞é❛❧ ♣♦✉r ♣✐❧♦t❡r ✉♥ ❧❛s❡r tr✐❝♦❧♦r❡✳ ❊❧❧❡ ❢♦♥❝t✐♦♥♥❡ à ✉♥❡ ❢réq✉❡♥❝❡ ❞❡ ✹✽ kHz ❡♥ ✷✹ bit✱ ❝❡ q✉✐ ♣❡r♠❡t ❞❡ ♣✐❧♦t❡r ❞❡s s❝❛♥♥❡rs ❥✉sq✉✬à ✹✽ kpps ❛✈❡❝ ✉♥❡ ❣r❛♥❞❡ ♣ré❝✐s✐♦♥✳
❈❡tt❡ ❝❛rt❡ s♦♥ ♣♦ssè❞❡ ❞❡s ✜❧tr❡s ❞❡ ❝♦✉r❛♥t ❝♦♥t✐♥✉ s✉r ❝❡s s♦rt✐❡s ❘❈❆ q✉✬✐❧ ❝♦♥✈✐❡♥t ❞❡ s✉♣♣r✐♠❡r ♣♦✉r ♣♦✉✈♦✐r ❞é❝❛❧❡r ❧❡ ❞❡ss✐♥ ♣❛r r❛♣♣♦rt à ❧❛ ♣♦s✐t✐♦♥ ❞✬♦r✐❣✐♥❡ ❞✉ ❧❛s❡r✳ P♦✉r ❝❡ ❢❛✐r❡✱ ♦♥ ❝♦✉rt✲❝✐r❝✉✐t❡ ❧❡s ❝♦♥❞❡♥s❛t❡✉rs ❡♥ s♦✉❞❛♥t ❞❡s ✜❧s ❝♦♠♠❡ ✐♥❞✐q✉é ❡♥ r♦✉❣❡ s✉r ❧❛ ✜❣✉r❡ ✶✵✳

➱t❛❣❡ ❞✬❛❞❛♣t❛t✐♦♥ ▲❛ ❝❛rt❡ s♦♥ ❢♦✉r♥✐t ✉♥ s✐❣♥❛❧ ❞❡ ✵✱✻ V ❝rêt❡ à ❝rêt❡ ❛❧♦rs q✉❡ ❧❛ ♥♦r♠❡ ■▲❉❆ ✉t✐❧✐s❡ ❞❡s s✐❣♥❛✉① ❞❡ ✶✵ V ❝rêt❡ à ❝rêt❡✳ ❯♥ ét❛❣❡ ❞✬❛❞❛♣t❛t✐♦♥ ❡st ❞♦♥❝ ♥é❝❡ss❛✐r❡ ♣♦✉r ❛♠♣❧✐✜❡r ❧❡ s✐❣♥❛❧✳ P♦✉r ❞❡s r❛✐s♦♥s ♣r❛t✐q✉❡s✱ ❥✬❛✐ ❝❤♦✐s✐ ❞✬❛❧✐♠❡♥t❡r ❝❡t ét❛❣❡ ❞✬❛❞❛♣t❛t✐♦♥ ❞✐✲ r❡❝t❡♠❡♥t ❞❡♣✉✐s ❧✬❛❧✐♠❡♥t❛t✐♦♥ ❯❙❇ ❞❡ ❧❛ ❝❛rt❡ s♦♥ ✭❝❡❧❛ é✈✐t❡ ❞✬❛❥♦✉t❡r ✉♥❡ ❛❧✐♠❡♥t❛t✐♦♥ ❡①t❡r♥❡✮✳ ❏✬❛✐ ❞♦♥❝ ❝❤♦✐s✐ ✉♥ ❛♠♣❧✐✜❝❛t❡✉r ♦♣ér❛t✐♦♥✲ ♥❡❧ r❛✐❧✲t♦✲r❛✐❧ ♣❡r♠❡tt❛♥t ❞✬❛tt❡✐♥❞r❡ ❡♥ s♦rt✐❡ ❧❛ ✈❛❧❡✉r ❞❡ ❧❛ t❡♥s✐♦♥ ❞✬❛❧✐♠❡♥t❛t✐♦♥ ✭✐❝✐ ✺ ❱✮✳ ❉❡ ♣❧✉s ❧❡ ❧❛s❡r q✉❡ ❥✬❛✈❛✐s à ❞✐s♣♦s✐t✐♦♥ ♣♦✉r

✶✹

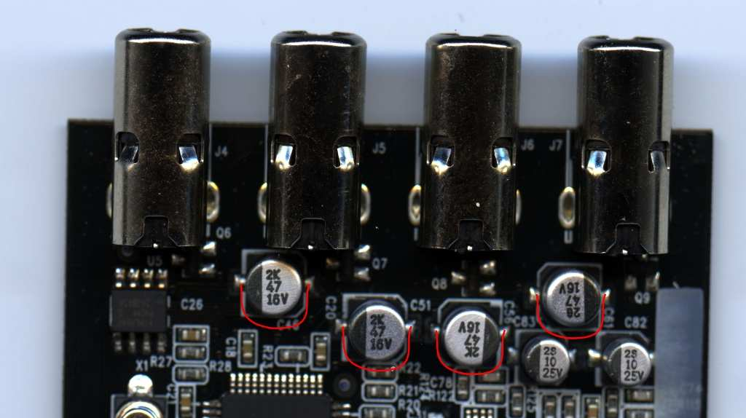
[picture p23: figure]

❋✐❣✉r❡ ✶✵ ✕ ❋✐❧tr❡ ❉❈ à ❝♦✉rt✲❝✐r❝✉✐t❡r

ré❛❧✐s❡r ❝❡s ❞é✈❡❧♦♣♣❡♠❡♥ts ♥✬❡st ♣❛s ❝♦♥❢♦r♠❡ à ❧❛ ♥♦r♠❡ ■▲❉❆✱ ♥♦t❛♠✲ ♠❡♥t ❧✬❡♥tré❡ ❞✉ s✐❣♥❛❧ ■▲❉❆ ♥✬❡st ♣❛s s②♠étr✐sé❡✳ P♦✉r q✉❡ ❧✬✐♥t❡r❢❛❝❡ s♦✐t ❝♦♠♣❛t✐❜❧❡ ❛✈❡❝ ❝❡ ❧❛s❡r✱ ❥✬❛✐ ❞é❝✐❞é ❞❡ ♥❡ ♣❛s ♠❡ ❝♦♥❢♦r♠❡r à ❧❛ ♥♦r♠❡ ✭♣♦✉r ❧❛ ré❛❧✐s❛t✐♦♥ ❞✉ ♣r♦t♦t②♣❡✮ ❡t ❞✬❛✈♦✐r ❞❡s s♦rt✐❡s ❛s②♠é✲ tr✐q✉❡s✳
❈❡ ❝❤♦✐① ❛ ♣❧✉s✐❡✉rs ❝♦♥séq✉❡♥❝❡s✳ ❉✬✉♥❡ ♣❛rt✱ ❧❡ s✐❣♥❛❧ ❡st ♣❧✉s s❡♥✲ s✐❜❧❡ ❛✉① ✐♥t❡r❢ér❡♥❝❡s✱ ❡t ❞♦♥❝ ✐❧ ❡st ♥é❝❡ss❛✐r❡ ❞❡ ré❞✉✐r❡ ❛✉t❛♥t q✉❡ ♣♦ss✐❜❧❡ ❧❡s ❧♦♥❣✉❡✉rs ❞❡ ❝â❜❧❡s ❡♥tr❡ ❧✬✐♥t❡r❢❛❝❡ ❡t ❧❡ ❧❛s❡r✳ ❉✬❛✉tr❡ ♣❛rt✱ s❡✉❧❡ ❧❛ ♣❛rt✐❡ ♣♦s✐t✐✈❡ ❞✉ s✐❣♥❛❧ ❛ été ❣❛r❞é❡ ❡t ❞♦♥❝ ❛✉ ❧✐❡✉ ❞✬❛✈♦✐r ✉♥❡ t❡♥s✐♦♥ ❝rêt❡✲à✲❝rêt❡ ❞❡ ✶✵ V ❝♦♠♠❡ ♣ré❝♦♥✐sé ♣❛r ❧❛ ♥♦r♠❡✱ ♥♦✉s ❛✈♦♥s s❡✉❧❡♠❡♥t ✺ V✳ ▲✬❛✐r❡ ❞❡ ❜❛❧❛②❛❣❡ ❞✉ ❧❛s❡r ❡st ❞♦♥❝ ré❞✉✐t❡ ❞❡ ♠♦✐t✐é✳ ❆ ❝♦♥tr❛r✐♦✱ ❝❡ ❝❤♦✐① s✐♠♣❧✐✜❡ ❧❡ ♠♦♥t❛❣❡ é❧❡❝tr♦♥✐q✉❡✳

✷✳✷✳✷ ▲♦❣✐❝✐❡❧

▲❡ ❧♦❣✐❝✐❡❧ q✉✐ ♣✐❧♦t❡ ❧✬✐♥t❡r❢❛❝❡ ❡st ✉♥ s❡r✈❡✉r ❖❙❈✳ ■❧ r❡ç♦✐t ❧❡s ♣♦✐♥ts s♦✉s ❢♦r♠❡ ❞❡ ❜❧♦❜s ✼
❡♥✈♦②és ❡♥ ✉♥ s❡✉❧ ♠❡ss❛❣❡✳ ❚♦✉s ❧❡s ❜❧♦❜s ❞♦✐✈❡♥t ❛✈♦✐r ❧❛ ♠ê♠❡ t❛✐❧❧❡✳ ▲❡s ❜❧♦❜s ❝♦rr❡s♣♦♥❞❡♥t r❡s♣❡❝t✐✈❡♠❡♥t ❛✉① ❝❛♥❛✉① ❳✱ ❨✱ r♦✉❣❡✱ ✈❡rt ❡t ❜❧❡✉✳ ❚r♦✐s✱ q✉❛tr❡ ♦✉ ❝✐♥q ❜❧♦❜s ♣❡✉✈❡♥t êtr❡ ❡♥✈♦②és s✐♠✉❧t❛♥é♠❡♥t✱ ♣♦✉r ♠❡ttr❡ à ❥♦✉r ❛✉t❛♥t ❞❡ t❛❜❧❡s✳ ▲❡s ♣❛r❛♠ètr❡s ❞❡ ♣r♦❥❡❝t✐♦♥ ✭é❝❤❡❧❧❡✱ t❛✐❧❧❡✱ tr❛♥s❧❛t✐♦♥✱ ✈✐t❡ss❡✳✳✳✮ s♦♥t q✉❛♥t à ❡✉① ❡♥✈♦②és sé♣❛ré♠❡♥t ❛✈❡❝ ✉♥ ♠❡ss❛❣❡ ❖❙❈ ♣❛r ♣❛r❛♠ètr❡✳ ▲❡ t❛❜❧❡❛✉ ✶ ❞♦♥♥❡ ❧❡s ❞✐✛ér❡♥ts t②♣❡s ❞❡ ♠❡ss❛❣❡s s✉♣♣♦rtés ♣❛r ❧❡ s❡r✈❡✉r✳ ▲❡s ♣♦✐♥ts s♦♥t st♦❝❦és ❞❛♥s ♣❧✉s✐❡✉rs t❛❜❧❡s q✉✐ s♦♥t ❡♥s✉✐t❡ ❧✉❡s✱ tr❛♥s❢♦r♠é❡s s❡❧♦♥ ❧❡s ♣❛r❛♠ètr❡s ❞❡ ❧❛ ♣r♦❥❡❝t✐♦♥ ❡t ❡♥✈♦②é❡s à ❧❛ ❝❛rt❡ s♦♥✳
▲❛ ❝♦rr❡❝t✐♦♥ ❞❡ ✜♥ ❞❡ ❧✐❣♥❡ ❞é❝❛❧❡ ❧❛ ❧❡❝t✉r❡ ❞❡ ❧❛ t❛❜❧❡ ❞✬✐♥t❡♥s✐té ♣♦✉r ❛♥t✐❝✐♣❡r ❧❛ ❧❛t❡♥❝❡ ❞✬❛❧❧✉♠❛❣❡ ❡t ❞✬❡①t✐♥❝✐t✐♦♥ ❞✉ ❧❛s❡r✳ ❈❡❝✐ ❝♦♥s✐✲ ❞èr❡ t♦✉t❡❢♦✐s q✉❡ ❝❡tt❡ ❧❛t❡♥❝❡ ❡st ❝♦♥st❛♥t❡✱ ❝❡ q✉✐ ♥✬❡st ♣❛s ✈ér✐✜é✳ ❈❡ s❡r✈❡✉r✱ ❛✐♥s✐ q✉❡ ❧❡ ❝❧✐❡♥t ❛ss♦❝✐é✱ s♦♥t ♣r♦❣r❛♠♠és ❡♥ P✉r❡❞❛t❛✳

✼✳ ❜❧♦❜ ❡st ✉♥ t②♣❡ ❞❡ ❞♦♥♥é❡s ❖❙❈✱ ✉♥ ❝♦♥t❡♥❡✉r ♣♦✉r ✉♥ ❜❧♦❝ ❞❡ ❞♦♥♥é❡s ❛r❜✐tr❛✐r❡s

✶✺

▼❡ss❛❣❡ | P❛r❛♠ètr❡ ❜ ✿ ❜❧♦❜ ❢ ✿ ❢❧♦❛t | ❊✛❡t
✴❛rr❛②s | ❜❜❜④❜⑥④❜⑥ | ▼✐s❡ à ❥♦✉r ❞❡s t❛❜❧❡s ❛✈❡❝ ❧❡s ❞♦♥✲ ♥é❡s ❞❡s ❜❧♦❜s
✴s❡tt✐♥❣✴♦❢❢s❡t | ❢❢❢ | ❉é❝❛❧❛❣❡ ❞❡s ❝❛♥❛✉①✱ r❡s♣❡❝t✐✈❡✲ ♠❡♥t ❳✱ ❨ ❡t ✐♥t❡♥s✐té
✴s❡tt✐♥❣✴s❝❛❧❡ | ❢❢❢ | ➱❝❤❡❧❧❡ r❡s♣❡❝t✐✈❡♠❡♥t ❡♥ ❳✱ ❨ ❡t ✐♥t❡♥s✐té
✴s❡tt✐♥❣✴✐♥✈❡rt | ❢❢❢ | ■♥✈❡rs✐♦♥ ❞❡s ❝❛♥❛✉①✱ r❡s♣❡❝t✐✈❡✲ ♠❡♥t ❳✱ ❨ ❡t ✐♥t❡♥s✐té
✴s❡tt✐♥❣✴✐♥t❡♥s✐t② | ❢❢❢ | ■♥t❡♥s✐té ❞❡s ❝❛♥❛✉① ❞❡ ❝♦✉❧❡✉r✱ r❡s✲ ♣❡❝t✐✈❡♠❡♥t ❘✱ ● ❡t ❇
✴s❡tt✐♥❣✴❜❧❛♥❦✐♥❣❴♦❢❢ | ❢ | ❉és❛❝t✐✈❡ ❧❡ ❝♦♥trô❧❡ ❞❡ ❧✬✐♥t❡♥s✐té ❞✉ ❧❛s❡r
✴s❡tt✐♥❣✴❛♥❣❧❡❴❝♦rr❡❝t✐♦♥ | ❢ | P❛r❛♠ètr❡ ❞❡ ❝♦rr❡❝t✐♦♥ ❞✬❛♥❣❧❡ ✭♥♦♥ ✐♠♣❧é♠❡♥té❡ ♣♦✉r ❧❡ ♠♦♠❡♥t✮
✴s❡tt✐♥❣✴❡♥❞❴❧✐♥❡❴❝♦rr❡❝t✐♦♥ | ❢ | P❛r❛♠ètr❡ ❞❡ ❝♦rr❡❝t✐♦♥ ❞❡ ✜♥ ❞❡ ❧✐❣♥❡
✴s❡tt✐♥❣✴s❝❛♥❴❢r❡q | ❢ | ❋réq✉❡♥❝❡ ❡♥ ❦❍③ ❞❡s s❝❛♥♥❡rs
✴s❡tt✐♥❣✴♣❡rs♣❡❝t✐✈❡❴❝♦rr❡❝t✐♦♥ | ❢ | ❆❝t✐✈❡ ❧❛ ❝♦rr❡❝t✐♦♥ ❞❡ ♣❡rs♣❡❝t✐✈❡
✴s❡tt✐♥❣✴❞st❴♣♦✐♥t | ❢❢❢❢❢❢❢❢ | P♦✐♥ts ❞é✜♥✐ss❛♥t ❧✬❡s♣❛❝❡ ❞❡ ♣r♦❥❡❝✲ t✐♦♥ ♣♦✉r ❝♦rr✐❣❡r ❧❛ ♣❡rs♣❡❝t✐✈❡

❚❛❜❧❡ ✶ ✕ ▼❡ss❛❣❡s ❖❙❈ s✉♣♣♦rtés ♣❛r ❧❡ s❡r✈❡✉r

✶✻

❚♦✉s ❞❡✉① ❞é♣❡♥❞❡♥t ❞❡ ❧❛ ❜✐❜❧✐♦t❤èq✉❡ ■▲❉❆ ❞❡ P✉r❡❞❛t❛ q✉✐ ❝♦♥t✐❡♥t tr♦✐s ♦❜❥❡ts ❡①t❡r♥❡s s♣é❝✐✜q✉❡s à ❝❡ ♣r♦❥❡t✳ ✐❧❞❛s❡♥❞ ❡t ✐❧❞❛r❡❝❡✐✈❡ s❡r✈❡♥t✱ r❡s♣❡❝t✐✈❡♠❡♥t✱ à ❡♥✈♦②❡r ❡t à r❡❝❡✈♦✐r ❧❡s ♣❛q✉❡ts ❖❙❈✳ ■❧s ❞é✲ ♣❡♥❞❡♥t ❞❡ ❧❛ ❜✐❜❧✐♦t❤èq✉❡ ❧✐❜❧♦ ✽

✳ ▲✬♦❜❥❡t ✐❧❞❛❢✐❧❡✱ ❜❛sé s✉r ❜✐♥❢✐❧❡ ❞❡ ▼❛t✐♥ P❡❛❝❤✱ ❧✐t ❧❡s ✜❝❤✐❡rs ❞✬❛♥✐♠❛t✐♦♥ ✳✐❧❞ ❡t ❝❤❛r❣❡ ❧❡✉r ❝♦♥t❡♥✉✱ tr❛♠❡ ♣❛r tr❛♠❡✱ ❞❛♥s ✉♥❡ t❛❜❧❡ q✉❡ ❧✬♦♥ ♣❡✉t ❡♥s✉✐t❡ ❡♥✈♦②❡r ❛✉ s❡r✈❡✉r✳ ▲✬❛r❝❤✐t❡❝t✉r❡ ❝❧✐❡♥t✴s❡r✈❡✉r ❖❙❈ ❞✉ ❧♦❣✐❝✐❡❧ ♣❡r♠❡t ❞❡ ❞é♣♦rt❡r ❧❡ s❡r✈❡✉r s✉r ✉♥❡ ♠❛❝❤✐♥❡ ❞✐✛ér❡♥t❡✳ ▲❡ s❡r✈❡✉r ❛ été t❡sté s✉r ✉♥❡ ❘❛s♣✲ ❜❡rr② P✐✳ ▼❛❧❤❡✉r❡✉s❡♠❡♥t s✉r ❝❡tt❡ ❝❛rt❡✱ ❧❡ ♣♦rt ❡t❤❡r♥❡t ❡st s✉r ❧❡ ♠ê♠❡ ❜✉s q✉❡ ❧❡s ♣♦rts ❯❙❇ ❡t ❧♦rsq✉✬♦♥ ❡♥✈♦✐❡ ❞❡s ♣❛q✉❡ts tr♦♣ ❣r❛♥❞s✱ ✐❧ ② ❛ ❞❡s ❝♦✉♣✉r❡s ❞❛♥s ❧❛ ❝♦♠♠✉♥✐❝❛t✐♦♥ ❛✈❡❝ ❧❛ ❝❛rt❡ s♦♥✳ ■❧ ❡♥ rés✉❧t❡ ❞❡s ❞é❢❛✉ts ✈✐s✐❜❧❡s ❞❛♥s ❧❛ tr❛❥❡❝t♦✐r❡ ❞✉ ❧❛s❡r✳ ■❧ ❡st ♥é❛♥♠♦✐♥s ♣♦✉r✲ t❛♥t ♣❡✉t êtr❡ ♣♦ss✐❜❧❡ ❞❡ ❢❛✐r❡ ❢♦♥❝t✐♦♥♥❡r ❝♦rr❡❝t❡♠❡♥t ❝❡tt❡ ✐♥t❡r❢❛❝❡ ♠♦❞✐✜❛♥t ❧❡s ♣❛r❛♠ètr❡s ❞✉ ❞r✐✈❡r ✭♥♦t❛♠♠❡♥t ❡♥ ❞és❛❝t✐✈❛♥t ❧❡ ♠♦❞❡ t✉r❜♦ ❞✉ ❝♦♥trô❧❡✉r ❊t❤❡r♥❡t✮ ♠❛✐s ❝❡s ♣✐st❡s ♥✬♦♥t ♣♦✉r ❧✬✐♥st❛♥t ♣❛s été ❡①♣❧♦ré❡s✳
▲❡s s♦✉r❝❡s ❞✉ ❧♦❣✐❝✐❡❧ ❛✐♥s✐ q✉❡ ❧❡s ❡①❡♠♣❧❡s s♦♥t ❞✐s♣♦♥✐❜❧❡s s✉r
♠♦♥ ❣✐t❤✉❜ ✿ ❤tt♣s✿✴✴❣✐t❤✉❜✳❝♦♠✴❛✈✐❧❧❡r❡t✴❧❛s❡r❴❞r✐✈❡r✳ (https://github.com/avilleret/laser_driver)

✽✳ ❤tt♣✿✴✴❧✐❜❧♦✳s♦✉r❝❡❢♦r❣❡✳♥❡t✴ (http://liblo.sourceforge.net/)

✶✼

## ✷✳✸ ❈♦♠♣❛r❛✐s♦♥ ❛✈❡❝ ❧✬✐♥t❡r❢❛❝❡ ●❛❧❛①② ▲❛s❡r ❙❤♦✇

❈❡tt❡ ♣❛rt✐❡ ♠❡t ❡♥ ♣❛r❛❧❧è❧❡ ❧❡s ♣❡r❢♦r♠❛♥❝❡s ❞❡ ❧✬✐♥t❡r❢❛❝❡ ❞é❝r✐t❡ ❝✐✲❛✈❛♥t ❡t ❞❡ ❧✬✐♥t❡r❢❛❝❡ ●❛❧❛①② ▲❛s❡r ❙❤♦✇✳ P♦✉r ❝❡❧❛✱ ❥✬❛✐ ✉t✐❧✐sé ❧❡ ♠♦t✐❢ ❞❡ t❡st ❡t ❞❡ ré❣❧❛❣❡ ■▲❉❆ ✭❝❢✳ ✜❣✉r❡ ✶✶✮ q✉❡ ❥✬❛✐ ♦❜s❡r✈é à ❧❛ ❢♦✐s à ❧✬♦s❝✐❧❧♦s❝♦♣❡ ❡t ♣r♦❥❡té ♣❛r ❧❡ ❧❛s❡r✳ ❈❡ ♣❛tt❡r♥ ♣❡r♠❡t ❞❡ ré❣❧❡r ❧❡s ❧❛s❡rs ❡♥ ❝♦rr✐❣❡❛♥t ❧❛ ✈✐t❡ss❡ ❡t ❧✬❛♠♦rt✐ss❡♠❡♥t ❞❡s ❣❛❧✈❛♥♦♠ètr❡s✳ ❙✉r ❧❛ ✜❣✉r❡ ✶✶❝ ❧❡ ❝❡r❝❧❡ ❜❧❡✉ ❛♣♣❛r❛ît ♣r♦❥❡té à ❧✬✐♥tér✐❡✉r ❞✉ ❝❛rré ✈❡rt ❛❧♦rs q✉✬✐❧ ❡st s✐t✉é à ❧✬❡①tér✐❡✉r s✉r ❧❡ ❞❡ss✐♥ ✶✶❜✳ ❈✬❡st ❛✐♥s✐ q✉✬✉♥ ❧❛s❡r ❜✐❡♥ ré❣❧é ❞♦✐t ré❛❣✐r ❞✬❛♣rès ❧❡s r❡❝♦♠♠❛♥❞❛t✐♦♥s ❞❡ ❧❛ ♥♦r♠❡ ■▲❉❆✳ ▲❛ ♣r❡♠✐èr❡ ❝♦♥st❛t❛t✐♦♥ ❡st q✉❡ ❧✬✐♥t❡r❢❛❝❡ ●❛❧❛①② ♥✬✐♥t❡r♣♦❧❡ ♣❛s ❞❡ ♠❛♥✐èr❡ ❝♦♥t✐♥✉❡ ❡♥tr❡ ❧❡s ♣♦✐♥ts✳ ❙✉r ❧❛ ✜❣✉r❡ ✶✶❛ ♦♥ ✈♦✐t q✉❡ ❧❡ ❝❡r❝❧❡ ❜❧❡✉ ❡st ❝♦♥st✐t✉é ❞❡ ❞♦✉③❡ ♣♦✐♥ts✱ s✉r ❧❛ ✜❣✉r❡ ✶✷❜ ✐❧ ❡♥ ♣♦ssè❞❡ tr❡♥t❡ ❛❧♦rs q✉❡ s✉r ❧❛ ✜❣✉r❡ ✶✷❛ ❧❡ ❝❡r❝❧❡ ❡st ❝♦♥t✐♥✉✳ ❈❡❝✐ ❡st ♣r♦❜❧é♠❛t✐q✉❡ ♣♦✉r ❞❡✉① r❛✐s♦♥s✳ ❚♦✉t ❞✬❛❜♦r❞ ♦♥ ✈❡rr❛ ❧❡s ♣♦✐♥ts ❞✐s❝r❡ts ❛✉ ❧✐❡✉ ❞✬✉♥ tr❛✐t ❛✈❡❝ ✉♥❡ ❞✐♦❞❡ ❡①trê♠❡♠❡♥t ré❛❝t✐✈❡✳ ❉❡ ♣❧✉s✱ ❡♥ r❛❥♦✉t❛♥t ❞❡s ♣♦✐♥ts ❧❡ tr❛❝é ❡st ❢❛✉ssé ❡t ❧❡ ❝❡r❝❧❡ ❛♣♣❛r❛ît ❡♥ ❞❡❤♦rs ❞✉ ❝❛rré ❛✈❡❝ ✉♥ ❧❛s❡r ❜✐❡♥ ré❣❧é ✭❝❢✳ ✜❣✉r❡ ✶✹❜✮✳
❖♥ ❝♦♥st❛t❡ s✉r ❧❛ ✜❣✉r❡ ✶✸ q✉❡ ❧✬✐♥t❡r❢❛❝❡ ●❛❧❛①② ❡st ♣❧✉s st❛❜❧❡ q✉❡ ❧❛ ♠✐❡♥♥❡✳ ◆é❛♥♠♦✐♥s✱ ✐❧ ❛♣♣❛r❛ît ❞❡s ♣♦✐♥ts ♣❧✉s ❧✉♠✐♥❡✉① ❛✉ ❢✉r à ♠❡s✉r❡ q✉❡ ❧✬♦♥ ❛✉❣♠❡♥t❡ ❧❛ ✈✐t❡ss❡✳
▲❡s ❞é❢❛✉ts q✉✐ ❛♣♣❛r❛✐ss❡♥t s✉r ❧❡ ❝❡r❝❧❡ ❞❡ ❧❛ ✜❣✉r❡ ✶✸❛ s♦♥t ❞❡s ♥♦♥✲❧✐♥é❛r✐tés ❞❡s ❆❖P ❞✉❡s à ❧✬✉t✐❧✐s❛t✐♦♥ ❞❡ ❝❡✉①✲❝✐ ❞❛♥s ❞❡s ❝♦♥❞✐t✐♦♥s ❧✐♠✐t❡s✳ ▲♦rs ❞❡s t❡sts ❧✬✐♥t❡r❢❛❝❡ ét❛✐t ❛❧✐♠❡♥té❡ ❞❡♣✉✐s ❧✬❛❧✐♠❡♥t❛t✐♦♥ ❞❡s s❝❛♥♥❡rs ❡♥ ✰✶✺ V✴✲✶✺ V✳ ▲❡s ❆❖P ▲▼✸✺✽ ❡♥ ♣❧❛❝❡ à ❝❡ ♠♦♠❡♥t ❧à ét❛✐❡♥t ❞♦♥❝ ✉t✐❧✐sés ❞❛♥s ❞❡s ❝♦♥❞✐t✐♦♥s ❧✐♠✐t❡s ❝❛r ❧❛ t❡♥s✐♦♥ ❞✬❛❧✐♠❡♥t❛t✐♦♥ ♠❡s✉ré❡ ❞❡ ✸✶ V ❡st ♣r♦❝❤❡ ❞❡ ❧❛ ❧✐♠✐t❡ t❤é♦r✐q✉❡ ❞❡ ✸✷ V✳ ▲✬✉t✐❧✐s❛t✐♦♥ ❞✬❛✉tr❡s ❆❖P ❡t ❞✬✉♥❡ t❡♥s✐♦♥ ❞✬❛❧✐♠❡♥t❛t✐♦♥ ♣❧✉s ❢❛✐❜❧❡ ❞❡✈r❛✐t rè❣❧❡r ❝❡ ♣r♦❜❧è♠❡✳

✶✽


✭❛✮ P♦✐♥ts | ✭❜✮ ❱❡❝t❡✉rs


✭❝✮ Pr♦❥❡té ❛✈❡❝ ✉♥ ❧❛s❡r ré❣❧é

❋✐❣✉r❡ ✶✶ ✕ P♦✐♥ts ❡t ✈❡❝t❡✉rs ❝♦♥st✐t✉❛♥t ❧❡ ♣❛tt❡r♥ ❞❡ t❡st ■▲❉❆

✶✾


✭❛✮ ▲❛s❡r ❉r❛✇❡r | ✭❜✮ ●❛❧❛①②

❋✐❣✉r❡ ✶✷ ✕ ❖❜s❡r✈❛t✐♦♥ à ❧✬♦s❝✐❧❧♦s❝♦♣❡ à ✶✷ kpps


✭❛✮ ▲❛s❡r ❉r❛✇❡r ✕ ✹✽ kpps | ✭❜✮ ●❛❧❛①② ✕ ✶✵✵ kkps

❋✐❣✉r❡ ✶✸ ✕ ❖❜s❡r✈❛t✐♦♥ à ❧✬♦s❝✐❧❧♦s❝♦♣❡ à ❧❛ ✈✐t❡ss❡ ❧✐♠✐t❡

✷✵


✭❛✮ ▲❛s❡r ❉r❛✇❡r | ✭❜✮ ●❛❧❛①②

❋✐❣✉r❡ ✶✹ ✕ Pr♦❥❡❝t✐♦♥ ❛✉ ❧❛s❡r à ✶✷ kpps

✷✶

## ❆♥♥❡①❡ ❆ ❙❝❤é♠❛ é❧❡❝tr♦♥✐q✉❡

▲❛ ✜❣✉r❡ ✶✺ ♣rés❡♥t❡ ❧❡ ♠♦♥t❛❣❡ ❞✉ ♣r♦t♦t②♣❡ ré❛❧✐sé✳ ❈❡ s❝❤é♠❛ ❢♦♥❝✲ t✐♦♥♥❡✱ ♥é❛♥♠♦✐♥s ✐❧ s♦✉✛r❡ ❞❡ q✉❡❧q✉❡s ❞é❢❛✉ts✳ ❚♦✉t ❞✬❛❜♦r❞✱ ✐❧ ♥✬② ❛ ♣❛s ❞❡ ♣r♦t❡❝t✐♦♥ ❝♦♥tr❡ ❧❡s ❝♦✉rt✲❝✐r❝✉✐ts ❡♥ s♦rt✐❡✳ ▲❡s ❆❖P r✐sq✉❡♥t ❞♦♥❝ ❞✬êtr❡ ❡♥❞♦♠♠❛❣és ❧♦rs ❞✬✉♥ ♠❛✉✈❛✐s ❜r❛♥❝❤❡♠❡♥t ♦✉ ❞✬✉♥ ❞é❢❛✉t ❞❡ ❧✬éq✉✐♣❡♠❡♥t r❡❧✐é✳
▲❡ ❝♦♥✈❡rt✐ss❡✉r ❉❈✴❉❈ ✺ V ✐s♦❧é ♣❡r♠❡t ❞✬✐♥✈❡rs❡r ❧❛ t❡♥s✐♦♥ ❞✬❛❧✐✲ ♠❡♥t❛t✐♦♥✳ ●râ❝❡ à ❝❡ ❝♦♠♣♦s❛♥t ❡t ❛✉① ❆❖P r❛✐❧✲t♦✲r❛✐❧✱ ❧❡ ♠♦♥t❛❣❡ ♣❡✉t êtr❡ ❛❧✐♠❡♥té ♣❛r ❧✬❯❙❇✳ ❚♦✉t❡❢♦✐s✱ ❧✬❛❧✐♠❡♥t❛t✐♦♥ ♣ré❧❡✈é s✉r ❧❛ ❝❛rt❡ s♦♥ ♥✬❡st q✉❡ ❞❡ 4, 85 V ❡t ❧❡ ❝♦♥✈❡rt✐ss❡✉r ❧❛ tr❛♥s❢♦r♠❡ ❡♥ −4, 95 V✱ ❧✬❛❧✐♠❡♥t❛t✐♦♥ ❡st ❛❧♦rs ❞✐ss②♠étr✐q✉❡✳
▼❛✐s ❝❡s ❝♦♠♣♦s❛♥ts s♦♥t ❛ss❡③ ♦♥ér❡✉①✳ ❖♥ ♣♦✉rr❛✐t ré❞✉✐r❡ ❧❡s ❝♦ûts✱ s❛♥s ré❞✉✐r❡ ❧❛ q✉❛❧✐té✱ ❡♥ ♣r❡♥❛♥t ✉♥❡ ❛❧✐♠❡♥t❛t✐♦♥ ❛✐❧❧❡✉rs✱ s✉r ❧✬❛❧✐♠❡♥t❛t✐♦♥ ❞❡s s❝❛♥♥❡rs à ❧✬✐♥tér✐❡✉r ❞✉ ❧❛s❡r ♣❛r ❡①❡♠♣❧❡ q✉✐ ❢♦✉r✲ ♥✐t ❣é♥ér❛❧❡♠❡♥t +15 V ❡t −15 V✳ ❉❛♥s ❝❡ ❝❛s✱ ✉♥ ❞♦✉❜❧❡ ré❣✉❧❛t❡✉r +9 V/ − 9 V ✭▲▼✼✽✵✾ ❡t ▲▼✼✾✵✾✮ ❡t ❞❡s ❆❖P t②♣❡s ◆❊✺✺✸✷ ✭♦✉ éq✉✐✲ ✈❛❧❡♥ts✮ s♦♥t s✉✣s❛♥ts✳
❯♥❡ ❛✉tr❡ ❧✐♠✐t❛t✐♦♥ ❞❡ ❝❡ ♠♦♥t❛❣❡ ❡st s❛ s❡♥s✐❜✐❧✐té à ❧❛ ❝❛♣❛❝✐té ❞❡s ❧♦♥❣s ❝â❜❧❡s✳ ▲♦rsq✉✬✉♥ ❝â❜❧❡ ❧♦♥❣ ✭> 50 m✮ ❡st ✉t✐❧✐sé✱ ✐❧ ❛❥♦✉t❡ ✉♥❡ ❝❤❛r❣❡ ❝❛♣❛❝✐t✐✈❡ ♥♦♥ ♥é❣❧✐❣❡❛❜❧❡ ❡t ❞❡s ♦s❝✐❧❧❛t✐♦♥s ♣❛r❛s✐t❡s ♣❡✉✈❡♥t ❛♣♣❛r❛îtr❡✳ ■❧ ❝♦♥✈✐❡♥t ❞❛♥s ❝❡ ❝❛s ❞❡ r❛❥♦✉t❡r ❞❡s ❝♦♥❞❡♥s❛t❡✉rs ❞❡ ✷✷✵ pF ❞❛♥s ❧❛ ❝♦♥tr❡✲ré❛❝t✐♦♥ ❞❡s ❆❖P✱ ❡♥ ♣❛r❛❧❧è❧❡ ❞❡s rés✐st❛♥❝❡s ❞❡ ✶✵ kΩ✳

▲❛ ✜❣✉r❡ ✶✻ ♣rés❡♥t❡ ✉♥ s❝❤é♠❛ ❛♠é❧✐♦ré ♣❡r♠❡tt❛♥t ❞❡ ♣✐❧♦t❡r ✉♥ ❧❛s❡r ❘●❇✳ ▲❡s s♦rt✐❡s s♦♥t s②♠étr✐sé❡s ♣❛r ❞❡s ❆❖P ❡t ♣r♦té❣é❡s ❞❡s ❝♦✉rts ❝✐r❝✉✐ts ♣❛r ❞❡s rés✐st❛♥❝❡s✳ ❉❡s ❝♦♥❞❡♥s❛t❡✉rs ❞❛♥s ❧❛ ❝♦♥tr❡✲ ré❛❝t✐♦♥ ❞❡s ❆❖P é✈✐t❡♥t ❧❡s ♦s❝✐❧❧❛t✐♦♥s s♣♦♥t❛♥é❡s✳
▲❡ ❝♦♥✈❡rt✐ss❡✉r ❉❈✴❉❈ ❳P✲P❖❲❊❘ ■❍✵✺✵✾❙ ♣♦ssè❞❡ ✉♥❡ ❧❛r❣❡ ♣❧❛❣❡ ❞❡ t❡♥s✐♦♥ ❞✬❡♥tré❡ ✭❞❡ 4, 5 V à 9 V✮ ❡t ✉♥❡ ❞♦✉❜❧❡ t❡♥s✐♦♥ ❞❡ s♦rt✐❡ ré❣✉❧é❡ +9 V/ − 9 V ❝❡ q✉✐ ♣❡r♠❡t ❞✬✉t✐❧✐s❡r ❞❡s ❆❖P ♥♦♥ r❛✐❧✲t♦✲r❛✐❧ ❡t ❞♦♥❝ ♠♦✐♥s ♦♥ér❡✉① ❡t ❞✬♦❜t❡♥✐r ❧❛ t❡♥s✐♦♥ ré❣✉❧é❡ ❛✈❡❝ ❧✬❛❧✐♠❡♥t❛t✐♦♥ ❯❙❇ ❞❡ 4, 85 V ❏✬❛✐ ❝❤♦✐s✐ ❞❡s ◆❊✺✺✸✷ ♣♦✉r ❧❡✉rs ♣❡r❢♦r♠❛♥❝❡s ❛✉❞✐♦ ❡t ❧❡✉r très ❜♦♥ r❛♣♣♦rt q✉❛❧✐té✴♣r✐①✳ ▲❡s ❥✉♠♣❡rs ❏P✶ à ❏P✻ s♦♥t ❞❡s ✜❧s ♠♦♥tés ❡♥ s✉r❢❛❝❡ ♣♦✉r ❢❛✐r❡ ❞❡s ❧✐❛✐s♦♥s ❡t é✈✐t❡r ❞✬❛✈♦✐r ✉♥ t②♣♦♥ ❞♦✉❜❧❡ ❢❛❝❡✳ ▲❡s ❧✐❛✐s♦♥s ❞❡s ❥✉♠♣❡rs s♦♥t r❡♣rés❡♥té❡s ❡♥ ❥❛✉♥❡ s✉r ❧❡ s❝❤é♠❛ ❞❡ ❧❛ ✜❣✉r❡ ✶✼ ♣❛❣❡ ✷✺✳
▲❛ ✜❣✉r❡ ✶✼ ♣❛❣❡ ✷✺ ♣rés❡♥t❡ ❧❡ ❝✐r❝✉✐t é❧❡❝tr♦♥✐q✉❡ ❛✈❡❝ ❧❡s ❝♦♠♣♦✲ s❛♥ts ♣♦✉r ré❢ér❡♥❝❡✳ ▲❛ ✜❣✉r❡ ✶✽ ♣❛❣❡ ✷✺ ♣rés❡♥t❡ ❧❡ t②♣♦♥✳ ▲❡ t❛❜❧❡❛✉ ✷ ♣❛❣❡ ✷✸ ❧✐st❡ ❧❡s ❝♦♠♣♦s❛♥ts ✉t✐❧✐sés✳

✷✷

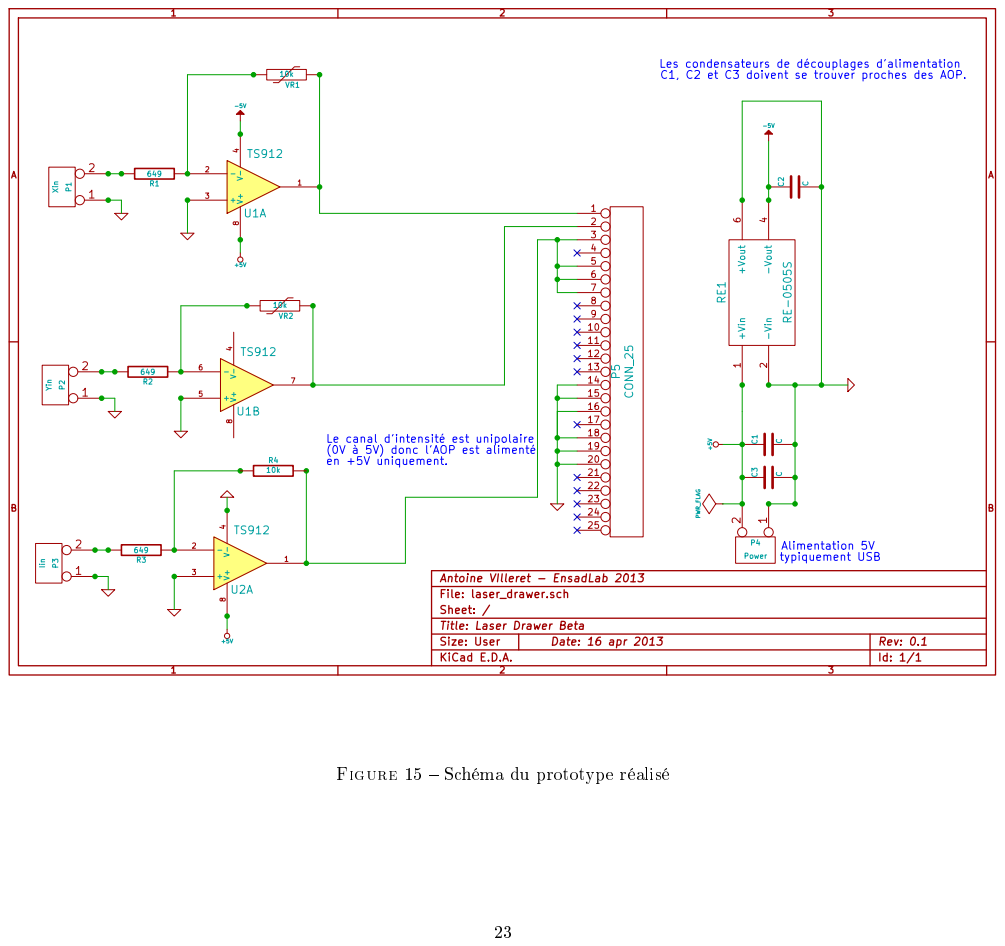
[picture p24: page 23]

Les condensateurs de découplages d'alimentation
C1, C2 et C3 doivent se trouver proches des AOP.

Le canal d'intensité est unipolaire
(0V à 5V) donc l'AOP est alimenté
en +5V uniquement.

Antoine VIlleret - EnsadLab 2013
File: laser_drawer.sch
Sheet: /
Title: Laser Drawer Beta
KiCad E.D.A.

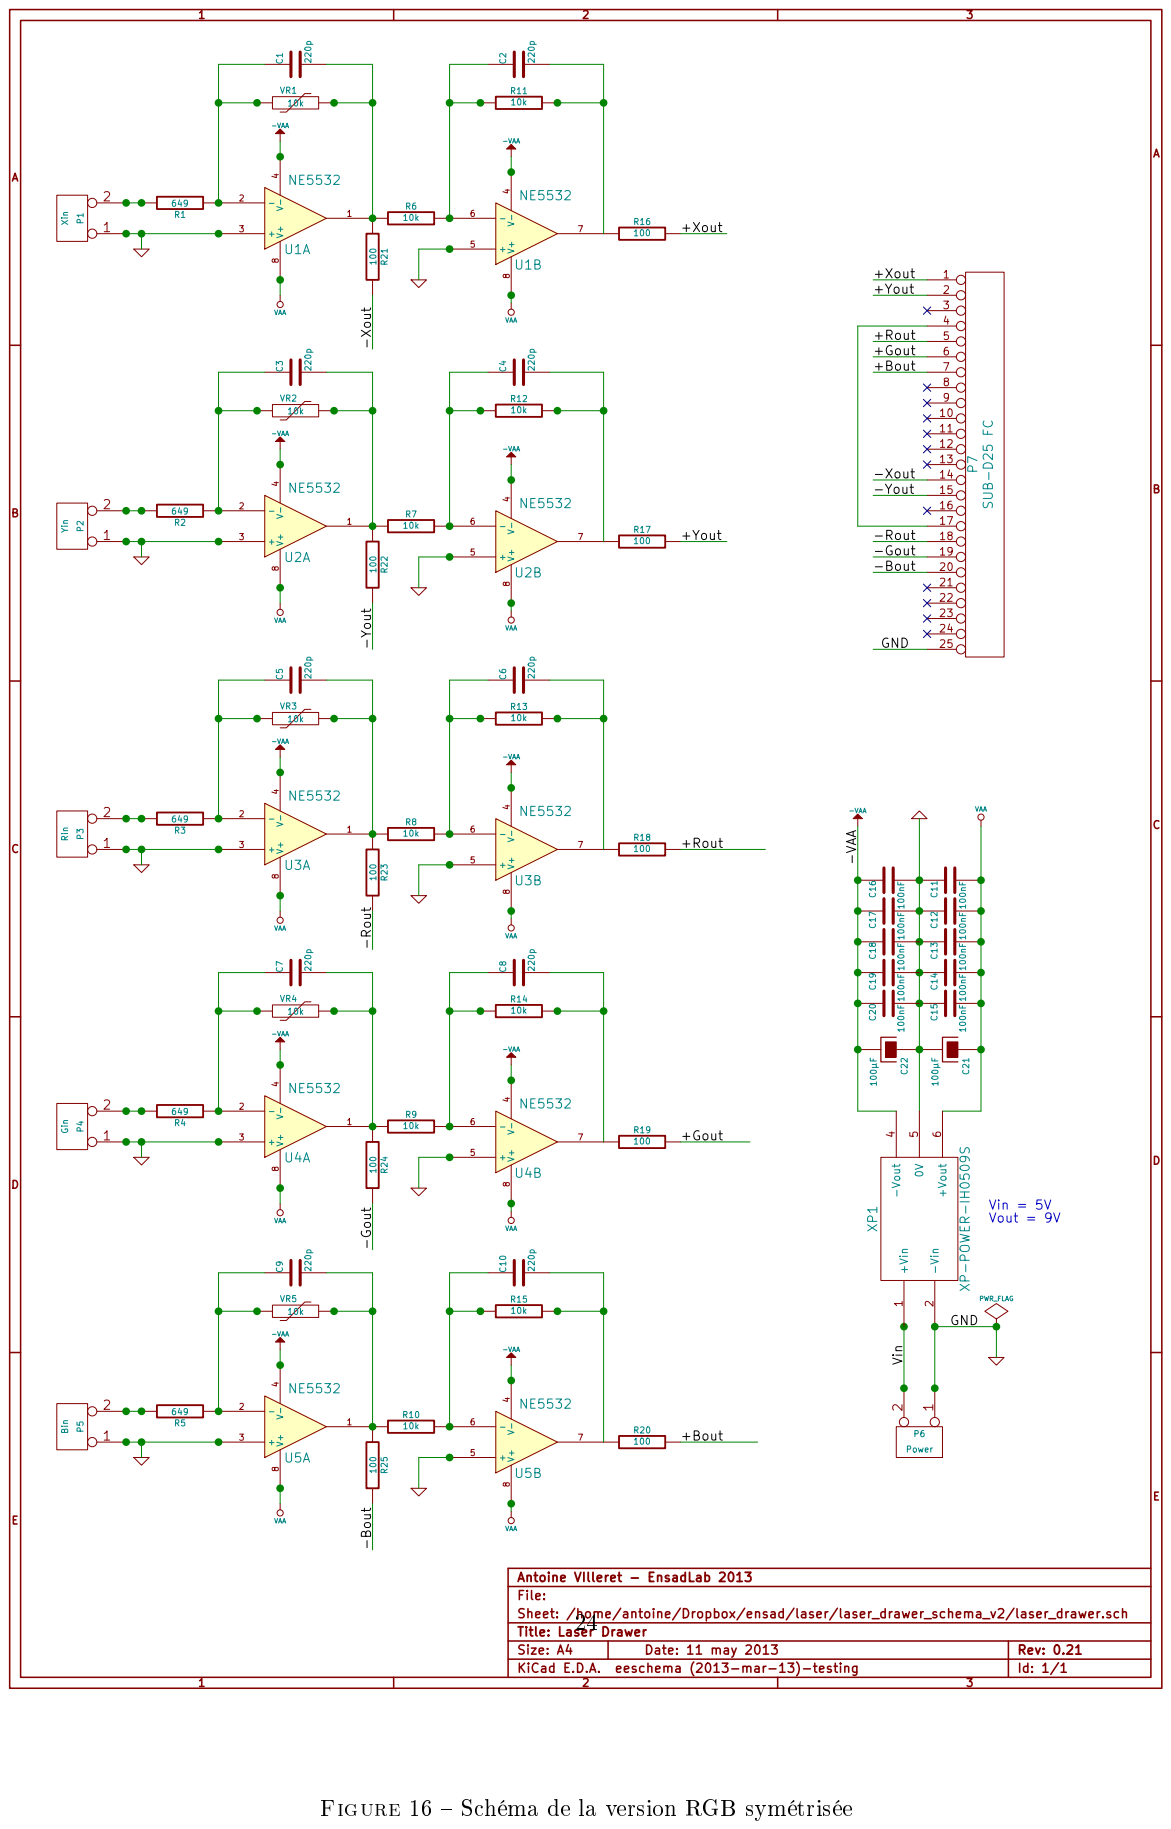
[picture p25: page 24]

Antoine VIlleret - EnsadLab 2013
File:
Sheet: /home/antoine/Dropbox/ensad/laser/laser_drawer_schema_v2/laser_drawer.sch

Title: Laser Drawer
KiCad E.D.A. eeschema (2013-mar-13)-testing

❋✐❣✉r❡ ✶✻ ✕ ❙❝❤é♠❛ ❞❡ ❧❛ ✈❡rs✐♦♥ ❘●❇ s②♠étr✐sé❡

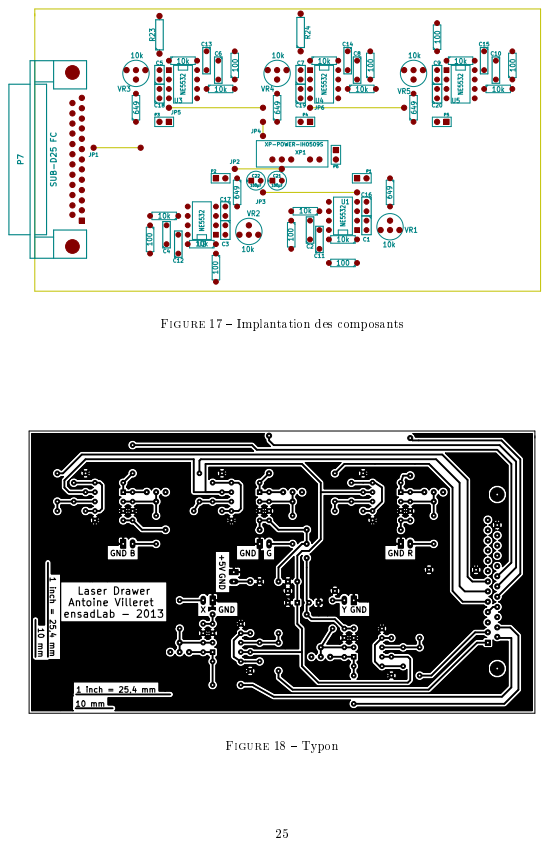
[picture p26: page 25]

❘❡❢✳ | ❱❛❧❡✉r | ◗✉❛♥t✐té | r❡❢✳ ❋❛r♥❡❧❧
❈✶ à ❈✶✵ | 220 pF | ✶✵
❈✶✶ à ❈✷✵ | 100 nF | ✶✵
❈✷✶✱ ❈✷✷ | 100 µF | ✷
❏P✶ à ❏P✻ | ❏❯▼P❊❘ | ✻
P✶ à P✻ | ✷①✶ P■◆ ❍❊❆❉❊❘ | ✻ | ✾✼✸✶✶✹✽ (http://fr.farnell.com/jsp/search/productdetail.jsp?sku=9731148)
P✼ | ❙❯❇✲❉✷✺ ❋❈ | ✶ | ✶✵✾✾✷✾✻ (http://fr.farnell.com/jsp/search/productdetail.jsp?sku=1099296)
❘✶ à ❘✺ | 649 Ω | ✺
❘✻ à ❘✶✺ | 10 kΩ | ✶✵
❘✶✻ à ❘✷✺ | 100 Ω | ✶✵
❯✶ à ❯✺ | ◆❊✺✺✸✷ | ✺ | ✶✶✵✻✵✾✶ (http://fr.farnell.com/jsp/search/productdetail.jsp?sku=1106091)
❱❘✶ à ❱❘✺ | 10 kΩ tr✐♠❡r | ✺ | ✾✸✺✹✸✵✶ (http://fr.farnell.com/jsp/search/productdetail.jsp?sku=9354301)
❳P✶ | ❳P✲P❖❲❊❘ ■❍✵✺✵✾❙ | ✶ | ✽✼✷✼✽✽✵ (http://fr.farnell.com/jsp/search/productdetail.jsp?sku=8727880)

❚❛❜❧❡ ✷ ✕ ▲✐st❡ ❞❡s ❝♦♠♣♦s❛♥ts ✉t✐❧✐sés ❞❛♥s ❧❡ ❝✐r❝✉✐t

✷✻

## ❆♥♥❡①❡ ❇ ▲é❣✐s❧❛t✐♦♥ s✉r ❧❡s ❧❛s❡rs

▲❡s ❧❛s❡rs ♣❡✉✈❡♥t êtr❡ ❞❛♥❣❡r❡✉①✳ ❯♥❡ ❢♦rt❡ q✉❛♥t✐té ❞❡ ❧✉♠✐èr❡ ❝♦❤ér❡♥t❡ ❝♦♥❝❡♥tré❡ s✉r ✉♥❡ ♣❡t✐t❡ s✉r❢❛❝❡ ❢❛✐t ♠♦♥t❡r ♣♦♥❝t✉❡❧❧❡♠❡♥t ❧❛ t❡♠♣ér❛t✉r❡✳ ❈✬❡st ♣♦✉r ❝❡❧❛ q✉❡ ❧❡s ❧❛s❡rs s♦♥t ✉t✐❧✐sés ♣♦✉r ❞é❝♦✉♣❡r ❞❡s ♠❛tér✐❛✉①✳ ▼❛✐s ❝❡tt❡ ♣r♦♣r✐été r❡♣rés❡♥t❡ ✉♥ ❞❛♥❣❡r ♣♦t❡♥t✐❡❧✱ à ❧❛ ❢♦✐s ♣♦✉r ❧❡s ♣❡rs♦♥♥❡s ♠❛✐s ❛✉ss✐ ♣♦✉r ❧❡s ❜✐❡♥s✳ ❖♥ ♣❡✉t êtr❡ ❜rû❧é ♣❛r ✉♥ ❧❛s❡r ❡t ❧❡s ②❡✉① s♦♥t é❣❛❧❡♠❡♥t très s❡♥s✐❜❧❡s✳ P❛r ❡①❡♠♣❧❡✱ ✐❧ ❡st ♣♦ss✐❜❧❡ ❞✬❛❧❧✉♠❡r ✉♥❡ ❝✐❣❛r❡tt❡ ❛✈❡❝ ✉♥ ❢❛✐s❝❡❛✉ ❧❛s❡r ❞❡ ✺ W✳ ■❧ ❡st ❞♦♥❝ ♥é❝❡ss❛✐r❡ ❞❡ ♣r❡♥❞r❡ ❞❡s ♣ré❝❛✉t✐♦♥s ❞❛♥s ❧❛ ♠✐s❡ ❡♥ ÷✉✈r❡ ❞✬✉♥ ❧❛s❡r✳ ❚♦✉t ❝❡❧❛ ❡st ❡♥❝❛❞ré ♣❛r ❞❡s ❧♦✐s ❡t ❞é❝r❡ts q✉✐ ♣❛r❢♦✐s s♦♥t ❞✐✣❝✐❧❡s à ❛♣♣❧✐q✉❡r✳
❈❡tt❡ ❛♥♥❡①❡ t❡♥t❡ ❞✬é❝❧❛✐r❝✐r ❧❡s ♠❡s✉r❡s ré❣❧❡♠❡♥t❛✐r❡s ❡t ❞❡ ❧❡s r❡❧❛t✐✈✐s❡r ♣❛r r❛♣♣♦rt à ❧✬✉t✐❧✐s❛t✐♦♥ q✉❡ ❧✬♦♥ ❢❛✐t ❞❡s ❧❛s❡rs✳

## ▲❡s r✐sq✉❡s

▲❡s ❧❛s❡rs ♣❡✉✈❡♥t ❜rû❧❡r ❧❛ ♣❡❛✉ ❡t s✉rt♦✉t ❧❛ rét✐♥❡✳ ▲❡s ❧és✐♦♥s ré✲ t✐♥✐❡♥♥❡s s♦♥t ✐rré✈❡rs✐❜❧❡s✳ ❖♥ ♣❡✉t ❞♦♥❝ ❞❡✈❡♥✐r ❞é✜♥✐t✐✈❡♠❡♥t ❛✈❡✉❣❧❡ ❡♥ r❡❣❛r❞❛♥t ✉♥ ❧❛s❡r à ❧✬÷✐❧ ♥✉✳
▲❡s ❧❛s❡rs ❞❡ ❝❧❛ss❡ ✹ ♣❡✉✈❡♥t ❞é❝❧❡♥❝❤❡r ✉♥ ✐♥❝❡♥❞✐❡✳ ❙✐ ❧❡ ❢❛✐s❝❡❛✉ r❡st❡ ✜①❡ s✉r ✉♥❡ s✉r❢❛❝❡ ✐♥✢❛♠♠❛❜❧❡✱ ❡❧❧❡ s✬❡♥✢❛♠♠❡ r❛♣✐❞❡♠❡♥t✳ P♦✉r q✉❡ ❧✬❡①♣♦s✐t✐♦♥ r❡st❡ s❛♥s ❞❛♥❣❡r✱ ❧❛ q✉❛♥t✐té ❞✬é♥❡r❣✐❡ r❡ç✉❡ ♥❡ ❞♦✐t ♣❛s ❞é♣❛ss❡r ❧❡ s❡✉✐❧ ❞❡ ❧✬❊①♣♦s✐t✐♦♥ ▼❛①✐♠❛❧❡ P❡r♠✐s❡ ✭❊▼P✮✳ ▲✬❊▼P ❡st ❞é✜♥✐❡ ❝♦♠♠❡ ❧❡ ❞✐①✐è♠❡ ❞❡ ❧❛ ❞♦s❡ q✉✐ ❛ ✉♥❡ ❝❤❛♥❝❡ s✉r ❞❡✉① ❞❡ ♣r♦❞✉✐r❡ ✉♥❡ ❧és✐♦♥ ❞❛♥s ❧❡s ❝♦♥❞✐t✐♦♥s ❧❡s ♣❧✉s ❞é❢❛✈♦r❛❜❧❡s✳ ❊❧❧❡ ❡st ♠❡s✉ré❡ s✉r ❧❛ ❝♦r♥é❡ ♦✉ s✉r ❧❛ ♣❡❛✉ ♣♦✉r ✉♥❡ ❧♦♥❣✉❡✉r ❞✬♦♥❞❡ ❡t ✉♥ t❡♠♣s ❞✬❡①♣♦s✐t✐♦♥ ❞♦♥♥és✳ ▲✬❊▼P ❡st ❡①♣✐♠é❡ ❡♥ W/cm² ♦✉ J/cm²

✳
❙✉r ❧❛ ✜❣✉r❡ ✶✾✱ ♦♥ ✈♦✐t q✉❡ ❧✬❡①♣♦s✐t✐♦♥ ❝♦♥t✐♥✉❡ ❞❡ ❧❛ ❝♦r♥é❡ à ✉♥ ❧❛s❡r ✈✐s✐❜❧❡ ❡st ❞❛♥❣❡✉rs❡ à ♣❛rt✐r ❞✬✶ mW✳
▲❡s ❧❛s❡rs s♦♥t é❣❛❧❡♠❡♥t ❞❛♥❣❡r❡✉① ♣♦✉r ❧✬❛✈✐❛t✐♦♥✳ ❙✐ ❧❡s ❛✈✐♦♥s s♦♥t t♦✉❥♦✉rs s✉✣s❛♠♠❡♥t ❧♦✐♥ ♣♦✉r q✉❡ ❧❡ ❧❛s❡r ♥❡ ❧❡s ❡♥❞♦♠♠❛❣❡ ♣❛s ✐❧ ❡st ❡♥ r❡✈❛♥❝❤❡ ♣♦ss✐❜❧❡ q✉❡ ❧❡s ♣✐❧♦t❡s s♦✐❡♥t é❜❧♦✉✐s✳

✷✼


❋✐❣✉r❡ ✶✾ ✕ ▼P❊ ♣♦✉r ❞✐✛ér❡♥t❡s ❧♦♥❣✉❡✉rs ❞✬♦♥❞❡ ✭s♦✉r❝❡ ✿ ❲✐❦✐♣❡❞✐❛✮

✷✽

❈❧❛ss❡ ✶ | ❧❛s❡rs s❛♥s ❞❛♥❣❡r✱ à ❝♦♥❞✐t✐♦♥ ❞❡ ❧❡s ✉t✐❧✐s❡r ❞❛♥s ❧❡✉rs ❝♦♥❞✐t✐♦♥s r❛✐s♦♥♥❛❜❧❡s ♣ré✈✐s✐❜❧❡s ✭❡①❡♠♣❧❡s ✿ ✐♠♣r✐♠❛♥t❡s✱ ❧❡❝t❡✉rs ❞❡ ❈❉✲❘❖▼ ❡t ❧❡❝t❡✉rs ❞❡ ❉❱❉✮✳
❈❧❛ss❡ ✶▼ | ❧❛s❡rs ❞♦♥t ❧❛ ✈✐s✐♦♥ ❞✐r❡❝t❡ ❞❛♥s ❧❡ ❢❛✐s❝❡❛✉✱ ♥♦t❛♠♠❡♥t à ❧✬❛✐❞❡ ❞✬✐♥str✉♠❡♥t ♦♣t✐q✉❡s✱ ♣❡✉t êtr❡ ❞❛♥❣❡r❡✉s❡✳
❈❧❛ss❡ ✷ | ❧❛s❡rs q✉✐ é♠❡tt❡♥t ✉♥ r❛②♦♥♥❡♠❡♥t ✈✐s✐❜❧❡ ❞❛♥s ❧❛ ❣❛♠♠❡ ❞❡ ❧♦♥❣✉❡✉r ❞❡ ✹✵✵ à ✼✵✵ ♥♠✳ ▲❛ ♣r♦t❡❝t✐♦♥ ❞❡ ❧✬÷✐❧ ❡st ♥♦r♠❛❧❡♠❡♥t ❛ss✉ré❡ ♣❛r ❧❡s ré✢❡①❡s ❞❡ ❞é❢❡♥s❡ ❝♦♠♣r❡♥❛♥t ❧❡ ré✢❡①❡ ♣❛❧♣é❜r❛❧✱ ❝❧✐❣♥❡♠❡♥t ❞❡ ❧❛ ♣❛✉♣✐èr❡ ✭♣❛r ❡①❡♠♣❧❡✱ ❞❡s ❧❡❝t❡✉rs ❞❡ ❝♦❞❡✲❜❛rr❡s✮✳
❈❧❛ss❡ ✷▼ | ❧❛s❡rs q✉✐ é♠❡tt❡♥t ✉♥ r❛②♦♥♥❡♠❡♥t ✈✐s✐❜❧❡ ❞❛♥s ❧❛ ❣❛♠♠❡ ❞❡ ❧♦♥❣✉❡✉r ❞❡ ✹✵✵ à ✼✵✵ ♥♠✳ ▲❛s❡rs ❞♦♥t ❧❛ ✈✐s✐♦♥ ❞✐r❡❝t❡ ❞❛♥s ❧❡ ❢❛✐s❝❡❛✉✱ ♥♦t❛♠♠❡♥t à ❧✬❛✐❞❡ ❞✬✐♥str✉♠❡♥t ♦♣t✐q✉❡s✱ ♣❡✉t êtr❡ ❞❛♥❣❡r❡✉s❡ ✭❡①❡♠♣❧❡s ✿ ❧♦✉♣❡s ❡t té❧❡s❝♦♣❡s✮✳
❈❧❛ss❡ ✸❆ | ❧❛s❡rs ❞♦♥t ❧✬❡①♣♦s✐t✐♦♥ ❞✐r❡❝t❡ ❞é♣❛ss❡ ❧✬❊▼P ✭❊①♣♦s✐t✐♦♥ ▼❛①✐♠❛❧❡ P❡r♠✐s❡✮ ♣♦✉r ❧✬÷✐❧✱ ♠❛✐s ❞♦♥t ❧❡ ♥✐✈❡❛✉ ❞✬é♠✐ss✐♦♥ ❡st ❧✐♠✐té à ❝✐♥q ❢♦✐s ❧❛ ▲❊❆ ✭▲✐♠✐t❡ ❞✬➱♠✐ss✐♦♥ ❆❝❝❡ss✐❜❧❡✮ ❞❡s ❝❧❛ss❡s ✶ ❡t ✷✳
❈❧❛ss❡ ✸❇ | ❧❛s❡r ❞♦♥t ❧❛ ✈✐s✐♦♥ ❞✐r❡❝t❡ ❞✉ ❢❛✐s❝❡❛✉ ❡st t♦✉❥♦✉rs ❞❛♥❣❡r❡✉s❡✳ ▲❛ ✈✐s✐♦♥ ❞❡ ré✢❡①✐♦♥s ❞✐✛✉s❡s ❡st ♥♦r♠❛❧❡♠❡♥t s❛♥s ❞❛♥❣❡r✳
❈❧❛ss❡ ✹ | ❧❛s❡rs q✉✐ s♦♥t ❛✉ss✐ ❝❛♣❛❜❧❡s ❞❡ ♣r♦❞✉✐r❡ ❞❡s ré✢❡①✐♦♥s ❞✐✛✉s❡s ❞❛♥❣❡r❡✉s❡s✳ ■❧s ♣❡✉✈❡♥t ❝❛✉s❡r ❞❡s ❞♦♠♠❛❣❡s s✉r ❧❛ ♣❡❛✉ ❡t ♣❡✉✈❡♥t é❣❛❧❡♠❡♥t ❝♦♥st✐t✉❡r ✉♥ ❞❛♥❣❡r ❞✬✐♥❝❡♥❞✐❡✳ ▲❡✉r ✉t✐❧✐s❛t✐♦♥ r❡q✉✐❡rt ❞❡s ♣ré❝❛✉t✐♦♥s ❡①trê♠❡s✳

❚❛❜❧❡ ✸ ✕ ❈❧❛ss✐✜❝❛t✐♦♥ ❞❡s ❧❛s❡rs ✭s♦✉r❝❡ ✿ ❲✐❦✐♣❡❞✐❛✮

✷✾

## ❘é❣❧❡♠❡♥t❛t✐♦♥

▲❡s ❧❛s❡rs s♦♥t ❝❧❛ssés s❡❧♦♥ ❧❡✉r ❞❛♥❣❡r♦s✐té ✭❝❢✳ t❛❜❧❡ ✸✮✳ ❯♥❡ ♣r❡✲ ♠✐èr❡ ❝❧❛ss✐✜❝❛t✐♦♥ ❡♥ ❝❤✐✛r❡ r♦♠❛✐♥ ♥❡ ♣r❡♥❛✐t ❡♥ ❝♦♠♣t❡ q✉❡ ❧❛ ♣✉✐s✲ s❛♥❝❡ ❞❡ ❧❛ s♦✉r❝❡✳ ❈❡tt❡ ❝❧❛ss✐✜❝❛t✐♦♥ ❛ été ré✈✐sé❡ ❡♥ ✷✵✵✼ ♣♦✉r ❛❞♦♣t❡r ✉♥❡ ♥✉♠ér♦t❛t✐♦♥ ❡♥ ❝❤✐✛r❡ ❛r❛❜❡ q✉✐ tr❛❞✉✐t t♦✉❥♦✉rs ❧❛ ❞❛♥❣❡r♦s✐té ❞✉ ❧❛s❡r ♠❛✐s ❡❧❧❡ ♣r❡♥❞ ❡♥ ❝♦♠♣t❡ ♣❧✉s ❞❡ ♣❛r❛♠ètr❡s ❝♦♠♠❡ ❧❛ ❧♦♥❣✉❡✉r ❞✬♦♥❞❡ ♦✉ ❧❛ ❞✐✈❡r❣❡♥❝❡ ✭❧❛ t❛✐❧❧❡ ❞❡ ❧❛ tâ❝❤❡ ❡♥ ❢♦♥❝t✐♦♥ ❞❡ ❧❛ ❞✐st❛♥❝❡✮✳ ▲❡s ❧❛s❡rs ❞❡ ❝❧❛ss❡ ✸ ❡t ✹✱ ✉t✐❧✐s❛❜❧❡s ❡①❝❧✉s✐✈❡♠❡♥t ❡♥ ♣❧❡✐♥ ❛✐r✱ s♦♥t ♠✐s ❡♥ ÷✉✈r❡ ♣❛r ✉♥ t❡❝❤♥✐❝✐❡♥ ❝♦♠♣ét❡♥t ❡t ❢♦r♠é ❛✉① r✐sq✉❡s s♣é❝✐✜q✉❡s ❞❡s ❧❛s❡rs✳ ✾
❋❛❝❡ à ❝❡tt❡ ❞❛♥❣❡r♦s✐té✱ ❧❛ ❧é❣✐s❧❛t✐♦♥ ✐♠♣♦s❡ ❞❡s ❞✐s♣♦s✐t✐❢s ❞❡ ❝♦✉✲ ♣✉r❡ ❛✉t♦♠❛t✐q✉❡ ❞✉ ❢❛✐s❝❡❛✉ ❡♥ ❝❛s ❞❡ ❞é❢❛✐❧❧❛♥❝❡ ❞✉ s②stè♠❡✳ ❙✉r ❝❡r✲ t❛✐♥s ❧❛s❡rs ♦♥ tr♦✉✈❡ ✉♥ s②stè♠❡ q✉✐ ❝♦✉♣❡ ❧❛ ❞✐♦❞❡ s✐ ❧✬❛✐r❡ ❞❡ ❜❛❧❛②❛❣❡ ♥✬❡st ♣❛s s✉✣s❛♠♠❡♥t ❣r❛♥❞❡✳ P❧✉s ❧✬❛✐r ❞❡ ❜❛❧❛②❛❣❡ ❡st ❣r❛♥❞❡✱ ♠♦✐♥s ❧❡ ❢❛✐s❝❡❛✉ r❡st❡ ❧♦♥❣t❡♠♣s ❛✉ ♠ê♠❡ ❡♥❞r♦✐t ❡t ❞♦♥❝ ♠♦✐♥s ✐❧ ❡st ❞❛♥❣❡r❡✉①✳ ▼❛✐s ❝❡ ❣❡♥r❡ ❞❡ ❞✐s♣♦s✐t✐❢ ❡st ❡①trê♠❡♠❡♥t ❝♦♥tr❛✐❣♥❛♥t ♣✉✐sq✉✬✐❧ ♥✬❡st ♣❧✉s ♣♦ss✐❜❧❡ ❞❡ ❞❡ss✐♥❡r ❞❡s ❢♦r♠❡s ❛r❜✐tr❛✐r❡s ♠ê♠❡ s✐ ❞❡s ♣ré❝❛✉t✐♦♥s s♦♥t ♣r✐s❡s ❛✐❧❧❡✉rs ✭s✉r❢❛❝❡ ❞❡ ♣r♦❥❡❝t✐♦♥ ✐❣♥✐❢✉❣é❡✱ ❝ô♥❡ ❞❡ ♣r♦❥❡❝t✐♦♥ ✐♥❛❝❝❡ss✐❜❧❡ ❛✉① ♣❡rs♦♥♥❡s✳ ✳ ✳✮✳

## ▲❛ ♣r❛t✐q✉❡

❉❛♥s ❧❛ ♣r❛t✐q✉❡ ❝❡tt❡ ❧é❣✐s❧❛t✐♦♥ ❡st très ❝♦♥tr❛✐❣♥❛♥t❡ ❡t s✉rt♦✉t ♣❡✉t ❢❛✐r❡ ♣❡✉r ❛✉① ♣❡rs♦♥♥❡s r❡s♣♦♥s❛❜❧❡s✳ ■❧ ❡st ❞♦♥❝ ♥é❝❡ss❛✐r❡ ❞✬❡①✲ ♣❧✐q✉❡r ❧❡s r✐sq✉❡s ❡t ❧❡s ♠❡s✉r❡s ❞❡ sé❝✉r✐té ♠✐s❡s ❡♥ ÷✉✈r❡✳ ❉ès ❧♦rs q✉❡ ❧✬♦♥ ✉t✐❧✐s❡ ✉♥ ❧❛s❡r ❞❡ ❝❧❛ss❡ ✸ ♦✉ ✹✱ ✐❧ ❢❛✉t é✈✐t❡r ❛✉t❛♥t q✉❡ ♣♦s✲ s✐❜❧❡ ❞❡ ❜❛❧❛②❡r ❧❡s s♣❡❝t❛t❡✉rs✳ ❙✐✱ ♠❛❧❣ré ❧❡s r✐sq✉❡s✱ ♦♥ s♦✉❤❛✐t❡ t♦✉t ❞❡ ♠ê♠❡ ❜❛❧❛②❡r ✉♥❡ ③♦♥❡ ♦ù ❧❡ ♣✉❜❧✐❝ ❡st ♣rés❡♥t✱ ✐❧ ❢❛✉t s✬❛ss✉r❡r q✉❡ ❧❛ ♣✉✐ss❛♥❝❡ r❡ç✉ ♣❛r ❧❡ ♣✉❜❧✐❝ ❡st ✐♥❢ér✐❡✉r❡ à ❧✬❊▼P✳
❘♦❜❡rt ❍❡♥❦❡ ♣♦✉r ❋r❛❣✐❧❡s ❚❡rr✐t♦✐r❡s ✉t✐❧✐s❡ ❞❡s ❧❛s❡rs ❞❡ ❝❧❛ss❡ ✹ ❡♥ ✐♥tér✐❡✉r✳ P♦✉r ❝❡❧❛✱ ✐❧ ❛ ♠✐s ❡♥ ♣❧❛❝❡ ✉♥❡ ❜❛rr✐èr❡ ♣❤②s✐q✉❡ q✉✐✱ s✐ ❡❧❧❡ ❡st ❢r❛♥❝❤✐❡✱ ❝♦✉♣❡ ❛✉t♦♠❛t✐q✉❡♠❡♥t ❧❡s ❧❛s❡rs✳ ▲❡s ♣❡rs♦♥♥❡s ♥❡ ♣❡✉✈❡♥t ❞♦♥❝ ❥❛♠❛✐s ❡♥tr❡r ❞❛♥s ❧❛ ③♦♥❡ ❞❡ ❜❛❧❛②❛❣❡✳ ❉❡ ❧♦♥❣✉❡s ❞✐s❝✉ss✐♦♥s ♦♥t été ♥é❝❡ss❛✐r❡s ❛✈❛♥t q✉❡ ❧❡ ❞✐s♣♦s✐t✐❢ ❞❡ sé❝✉r✐té ♥❡ s♦✐t ❛♣♣r♦✉✈é✳ P♦✉r ❊♥s❡✐❣♥❡ ❞❡ ❙❛♠✉❡❧ ❇✐❛♥❝❤✐♥✐✱ ❧❡ ❧❛s❡r ❞❡ ✽W ❡st ❝♦♥tr❛✐♥t ♣❛r ✉♥❡ ❢❡♥êtr❡ ♥♦✐r❡ ❡♥ ❛❧✉♠✐♥✐✉♠✳ ➚ tr❛✈❡rs ❝❡tt❡ ❢❡♥êtr❡✱ ❧❡ ❢❛✐s❝❡❛✉ ♥❡ ♣❡✉t q✉✬❛tt❡✐♥❞r❡ s❛ ❝✐❜❧❡ ✿ ❧❛ ❢❛ç❛❞❡ ❞✬✉♥ ✐♠♠❡✉❜❧❡ s✐t✉é à ✷✺✵ m✳ ❙✐ ❧❡ ❢❛✐s❝❡❛✉ s♦rt ❞❡ ❧❛ ❢❡♥êtr❡✱ ✐❧ ❡st ❞✐ss✐♣é ♣❛r ❧❡ ♠ét❛❧ ♥♦✐r q✉✐ ♥❡ ♣❡✉t ❢♦♥❞r❡ ♠ê♠❡ s✐ ❧❡ ❢❛✐s❝❡❛✉ r❡st❡ ✜①❡ ❧♦♥❣t❡♠♣s✳
◗✉❛♥t à ❘♦❜✐♥ ❋♦①✱ ❞❛♥s s♦♥ s❤♦✇ ✐❧ ❜❛❧❛②❡ ❧❡ ♣✉❜❧✐❝ q✉✐ ♣❡✉t r❡❝❡✈♦✐r ❧❡ ❧❛s❡r ❞❛♥s ❧❡s ②❡✉①✳ ■❧ ♥❡ s❡♠❜❧❡ ♣❛s ✐♥❝♦♥s❝✐❡♥t ❞❡s ❞❛♥❣❡rs ♠❛✐s ✐❣♥♦r❡ q✉❡ s♦♥ ❧❛s❡r ✭❝❧❛ss❡ ✸✱ ✺✸✷ nm ✸✺✵ mW✮ ❡st ✐♥t❡r❞✐t ❞✬✉t✐❧✐s❛t✐♦♥ ❡♥ ✐♥tér✐❡✉r✱ ❞✉ ♠♦✐♥s ❡♥ ❋r❛♥❝❡✳

✾✳ ❉✬❛♣rès ❧❡ ❏♦✉r♥❛❧ ❖✣❝✐❡❧ ❞❡ ❧❛ ❘é♣✉❜❧✐q✉❡ ❋r❛♥ç❛✐s❡ ♥✉♠ér♦ ✵✵✸✾ ❞✉ ✶✻ ❢é✈r✐❡r ✷✵✶✵✱ t❡①t ✾

✸✵

## ❆♥♥❡①❡ ❈ ❈ré❞✐t ✐♠❛❣❡

▲✬✐♠❛❣❡ ✻ ❡st r❡♣r♦❞✉✐t❡ ❛✈❡❝ ❧✬❛✐♠❛❜❧❡ ❛✉t♦r✐s❛t✐♦♥ ❞❡ ❲❤✐t❡ ❱♦✐❞✳ ▲✬✐♠❛❣❡ ✾ ❡st r❡♣r♦❞✉✐t❡ ❛✈❡❝ ❧✬❛✐♠❛❜❧❡ ❛✉t♦r✐s❛t✐♦♥ ❞❡ ▼❛rs❤♠❛❧❧♦✇ ▲❛s❡r ❋❡❛st✳
▲✬✐♠❛❣❡ ✹ ❡st r❡♣r♦❞✉✐t❡ ❛✈❡❝ ❧✬❛✐♠❛❜❧❡ ❛✉t♦r✐s❛t✐♦♥ ❞❡ ❘♦❜❡rt ❍❡♥❦❡✳ ❏✬❛✐ ♣❡rs♦♥♥❡❧❧❡♠❡♥t ré❛❧✐sé ❧❡s ♣❤♦t♦s ✺ ❡t ✷✳
▲❡s ❞❡♠❛♥❞❡s ❞✬❛✉t♦r✐s❛t✐♦♥ ❞❡ r❡♣r♦❞✉❝t✐♦♥ ♣♦✉r ❧❡s ❛✉tr❡s ♣❤♦t♦s s♦♥t r❡sté❡s s❛♥s s✉✐t❡✳ ❏✬❛✐ ❞é❝✐❞é ❞❡ t♦✉t ❞❡ ♠ê♠❡ ❧❡s r❡♣r♦❞✉✐r❡ ♣♦✉r ✐❧❧✉str❡r ♠♦♥ ❞♦ss✐❡r✳ ❊❧❧❡s ♣❡✉✈❡♥t êtr❡ r❡t✐ré❡s s✉r s✐♠♣❧❡ ❞❡♠❛♥❞❡ ❞❡s ❛✉t❡✉rs✳

✸✶
