avilleret/laser_drawer/src/examples/ildatestpattern_512x512.jpg

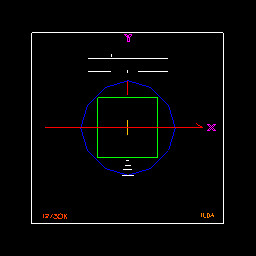
src/examples/ildatestpattern_512x512.jpg
