avilleret/laser_drawer/src/examples/ildatestpattern_512x512_point.jpg

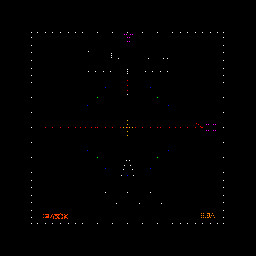
src/examples/ildatestpattern_512x512_point.jpg
