avilleret/laser_drawer/schematic/laser_drawer.pdf

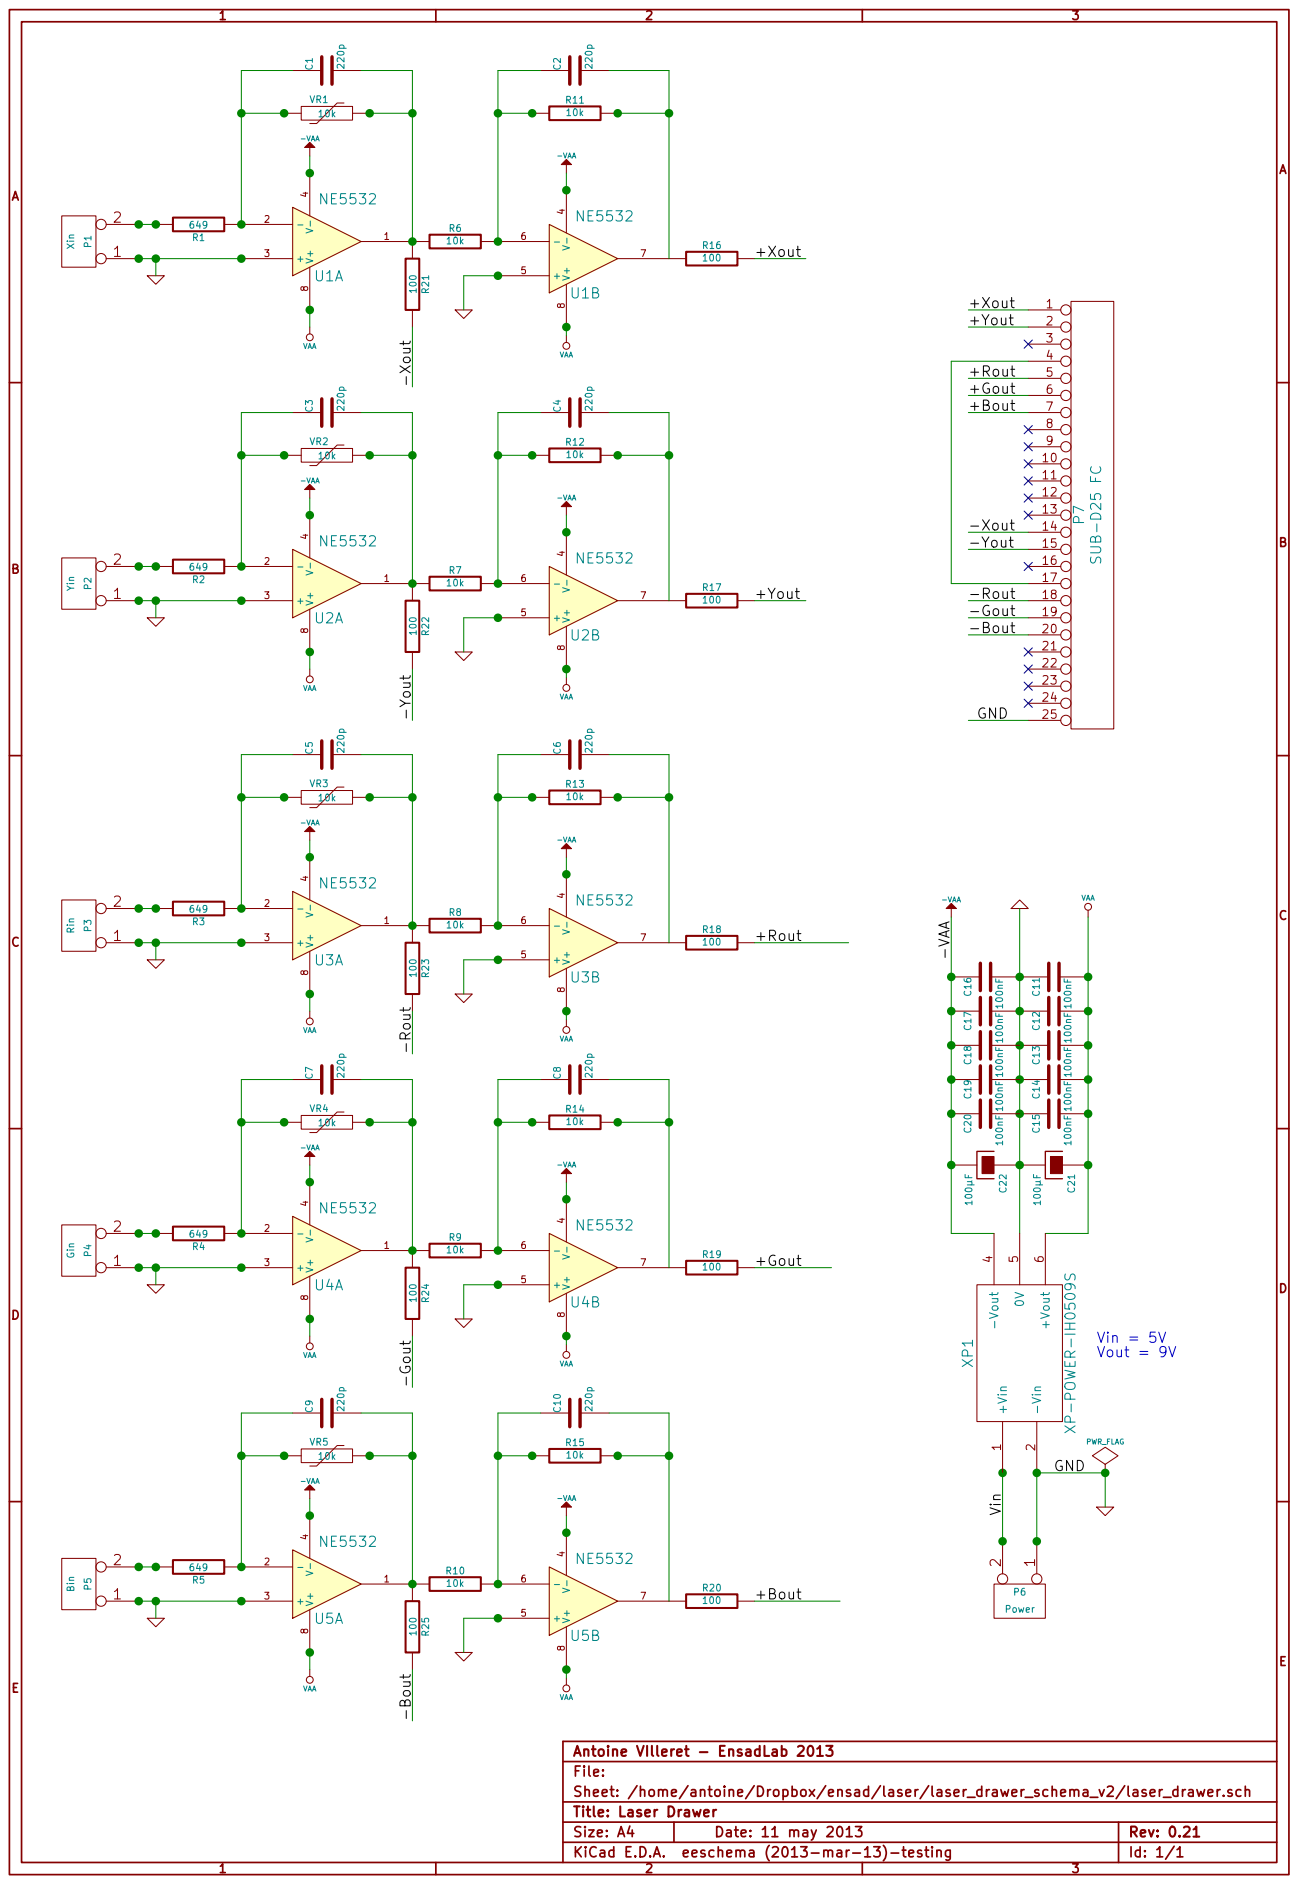
[picture p29: page 1]
