avilleret/laser_drawer/schematic/pdf/laser_drawer--brd.pdf

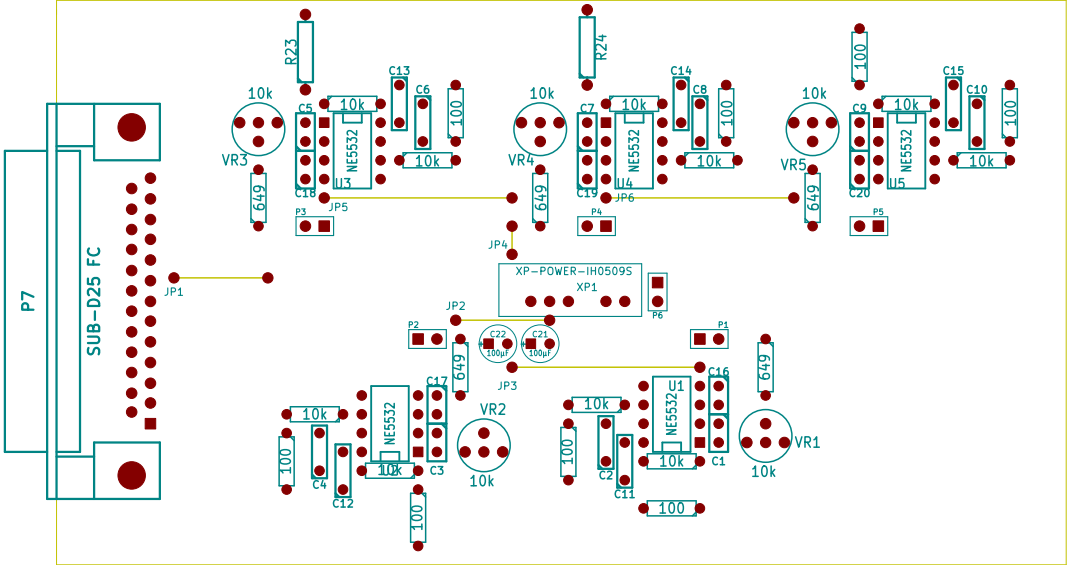
[picture p30: page 1]
