avilleret/laser_drawer/schematic/pdf/laser_drawer-B_Cu.pdf

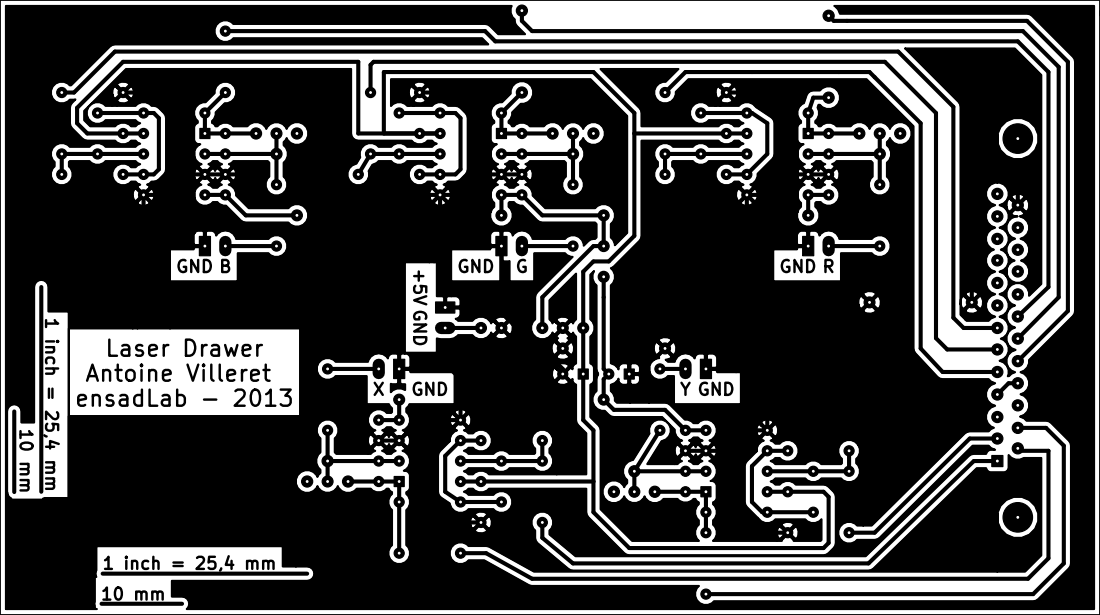
[picture p31: page 1]
