avilleret/laser_drawer/schematic/laser_drawer.kicad_pcb

## KiCad design schematic/laser_drawer.kicad_pcb (2014-02-22)

Schematic: laser_drawer.sch, Laser Drawer

Parts:
C1, C2, C3, C4, C5, C6, C7, C8, C9, C10: 220p
C11, C12, C13, C14, C15, C16, C17, C18, C19, C20: 100nF
C21, C22: 100µF
JP1, JP2, JP3, JP4, JP5, JP6: (no value)
P1: Xin
P2: Yin
P3: Rin
P4: Gin
P5: Bin
P6: Power
P7: SUB-D25 FC
R1, R2, R3, R4, R5: 649
R6, R7, R8, R9, R10, R11, R12, R13, R14, R15: 10k
R16, R17, R18, R19, R20, R21, R22, R23, R24, R25: 100
U1, U2, U3, U4, U5: NE5532
VR1, VR2, VR3, VR4, VR5: 10k
XP1: XP-POWER-IH0509S

Connections:
-VAA: C16.1, C17.1, C18.1, C19.1, C20.1, C22.2, JP3.1, JP3.2, JP4.1, JP4.2, JP5.1, JP5.2, JP6.1, JP6.2, U1.4 (V-), U2.4 (V-), U3.4 (V-), U4.4 (V-), U5.4 (V-), XP1.4
/+Bout: P7.7, R20.2
/+Gout: P7.6, R19.2
/+Rout: P7.5, R18.2
/+Xout: P7.1, R16.2
/+Yout: P7.2, R17.2
/-Bout: P7.20, R25.2
/-Gout: P7.19, R24.2
/-Rout: P7.18, R23.2
/-Xout: P7.14, R21.2
/-Yout: P7.15, R22.2
/Vin: P6.2 (PM), XP1.1
GND: C11.1, C12.1, C13.1, C14.1, C15.1, C16.2, C17.2, C18.2, C19.2, C20.2, C21.2, C22.1, JP1.1, JP1.2, JP2.1, JP2.2, P1.1, P2.1, P3.1, P4.1, P5.1, P6.1, P7.25, U1.3 (+), U1.5 (+), U2.3 (+), U2.5 (+), U3.3 (+), U3.5 (+), U4.3 (+), U4.5 (+), U5.3 (+), U5.5 (+), XP1.2, XP1.5
unnamed: C6.2, R13.2, R18.1, U3.7
unnamed: C5.2, R8.1, R23.1, U3.1, VR3.1
unnamed: C6.1, R8.2, R13.1, U3.6 (-)
unnamed: C7.1, R4.2, U4.2 (-), VR4.2
unnamed: P4.2 (PM), R4.1
unnamed: P3.2 (PM), R3.1
unnamed: C8.2, R14.2, R19.1, U4.7
unnamed: C8.1, R9.2, R14.1, U4.6 (-)
unnamed: C7.2, R9.1, R24.1, U4.1, VR4.1
unnamed: C9.1, R5.2, U5.2 (-), VR5.2
unnamed: P5.2 (PM), R5.1
unnamed: C3.2, R7.1, R22.1, U2.1, VR2.1
unnamed: C3.1, R2.2, U2.2 (-), VR2.2
unnamed: P2.2 (PM), R2.1
unnamed: C4.2, R12.2, R17.1, U2.7
unnamed: C5.1, R3.2, U3.2 (-), VR3.2
unnamed: C4.1, R7.2, R12.1, U2.6 (-)
unnamed: P7.4, P7.17
unnamed: C10.1, R10.2, R15.1, U5.6 (-)
unnamed: C10.2, R15.2, R20.1, U5.7
unnamed: C9.2, R10.1, R25.1, U5.1, VR5.1
unnamed: P1.2 (PM), R1.1
unnamed: C1.2, R6.1, R21.1, U1.1, VR1.1
unnamed: C1.1, R1.2, U1.2 (-), VR1.2
unnamed: C2.1, R6.2, R11.1, U1.6 (-)
unnamed: C2.2, R11.2, R16.1, U1.7
VAA: C11.2, C12.2, C13.2, C14.2, C15.2, C21.1, U1.8 (V+), U2.8 (V+), U3.8 (V+), U4.8 (V+), U5.8 (V+), XP1.6

Notes on the sheet:
Vin = 5V Vout = 9V

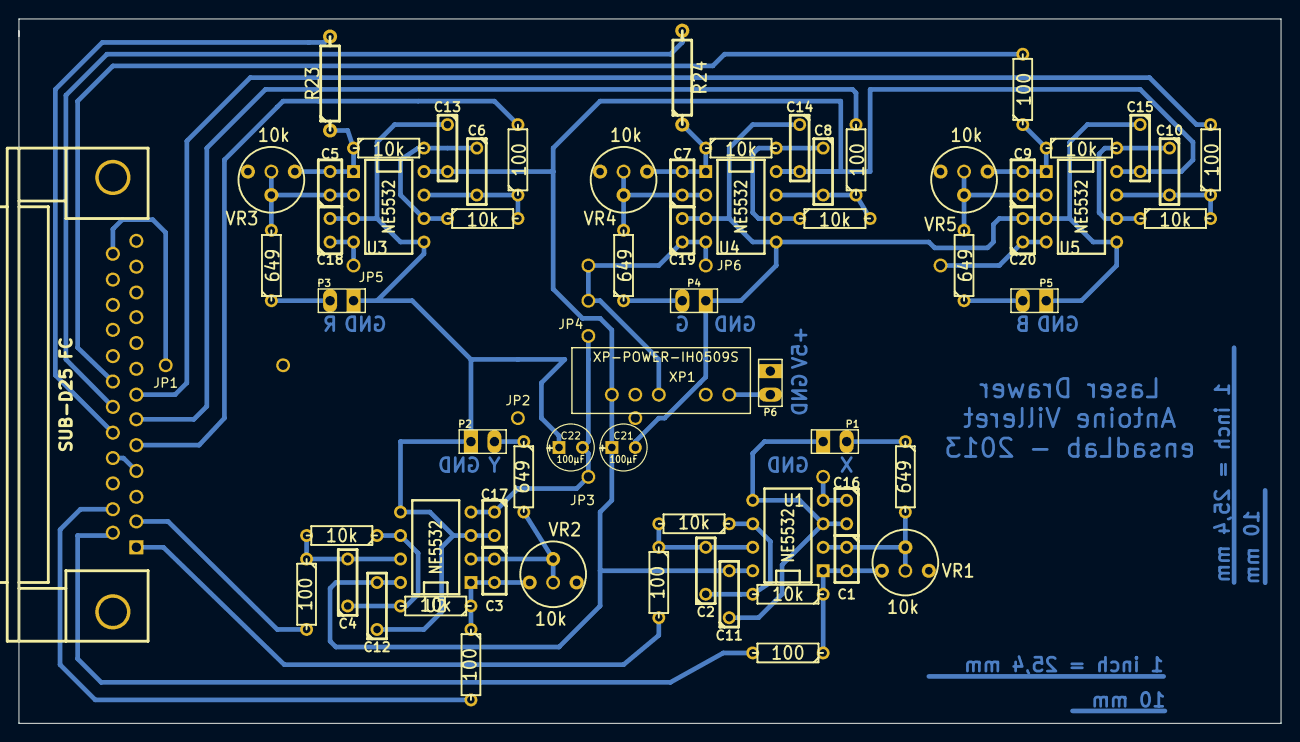
[picture p32: board laser_drawer.kicad_pcb from above]

Board: 2 copper layers, 136.5 x 76.2 mm, 71 parts (0 on the bottom side), 40 nets.
