avilleret/laser_drawer/(commit log)

2013-03-04 initial commit of laser_driver
2013-03-04 ça a l'air de marcher
2013-03-05 3D frame decoding
2013-04-16 ildafile : - add color support (standard color table in ilda.h) - fix crash when frame is longer than array - add intensity channel
2013-06-18 add documentation add schematics
    [laser_drawer.kicad_pcb, laser_drawer.sch, rgb.sch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]
2013-06-20 update doc
    [laser_drawer.kicad_pcb, laser_drawer.sch, rgb.sch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]
2014-02-22 update schematics
    [laser_drawer.kicad_pcb, laser_drawer.sch]
